diazmanuel/Display-PoV/README.md

# TD2-Project
Castro Germán.
Diaz Manuel.
Vieiro Alexis.
