diazmanuel/Display-PoV/Informes/Doxygen/latex/HallSensor_8h.tex

\hypertarget{HallSensor_8h}{}\section{inc/\+Hall\+Sensor.h File Reference}
\label{HallSensor_8h}\index{inc/\+Hall\+Sensor.\+h@{inc/\+Hall\+Sensor.\+h}}

Asociaciones a \mbox{\hyperlink{HallSensor_8c}{Hall\+Sensor.\+c}}.  

\subsection*{Data Structures}
\begin{DoxyCompactItemize}
\item 
struct \mbox{\hyperlink{structHallSensor}{Hall\+Sensor}}
\begin{DoxyCompactList}\small\item\em \mbox{\hyperlink{structHallSensor}{Hall\+Sensor}} data struct. \end{DoxyCompactList}\end{DoxyCompactItemize}
\subsection*{Macros}
\begin{DoxyCompactItemize}
\item 
\#define \mbox{\hyperlink{HallSensor_8h_a820b6b8369fe8a5102e352fd4bf670c9}{H\+A\+L\+L\+\_\+\+P\+IN}}~2,11
\item 
\#define \mbox{\hyperlink{HallSensor_8h_a815fd72f780650a3f0c92feb34b96a6e}{I\+S\+E\+\_\+\+E\+I\+N\+T1}}~19
\end{DoxyCompactItemize}
\subsection*{Typedefs}
\begin{DoxyCompactItemize}
\item 
typedef struct \mbox{\hyperlink{structHallSensor}{Hall\+Sensor}} \mbox{\hyperlink{HallSensor_8h_a1d1ee3822fdc22322726af6aaa56c168}{Hall\+Sensor\+\_\+t}}
\end{DoxyCompactItemize}
\subsection*{Functions}
\begin{DoxyCompactItemize}
\item 
void \mbox{\hyperlink{HallSensor_8h_afa1a93d781ae7c1db6d4a0d502c606f9}{Init\+Hall\+Sensor}} (void)
\begin{DoxyCompactList}\small\item\em Inicializa el hardware asociado al sensor hall. \end{DoxyCompactList}\item 
void \mbox{\hyperlink{HallSensor_8h_a336b0614150fc54c84bed71cd56a2ab3}{Crear\+Hall\+Sensor}} (\mbox{\hyperlink{HallSensor_8h_a1d1ee3822fdc22322726af6aaa56c168}{Hall\+Sensor\+\_\+t}} $\ast$$\ast$Hall\+Sensor\+H\+E\+AD)
\begin{DoxyCompactList}\small\item\em Crea y aloja en R\+AM estatica la memoria necesaria. \end{DoxyCompactList}\item 
void \mbox{\hyperlink{HallSensor_8h_a38bbe17aa64273d2f6037dbece46a151}{Eliminar\+Hall\+Sensor}} (\mbox{\hyperlink{HallSensor_8h_a1d1ee3822fdc22322726af6aaa56c168}{Hall\+Sensor\+\_\+t}} $\ast$$\ast$Hall\+Sensor\+H\+E\+AD)
\begin{DoxyCompactList}\small\item\em Elimina la memoria previamente alojada. \end{DoxyCompactList}\item 
void \mbox{\hyperlink{HallSensor_8h_a0ef4ba006c957012969c84b5b3db29e7}{E\+I\+N\+T0\+\_\+\+I\+R\+Q\+Handler}} (void)
\item 
void \mbox{\hyperlink{HallSensor_8h_a94ed24c6187969099266b37b4e22d749}{Hall\+Sensor\+Interrupt}} (\mbox{\hyperlink{HallSensor_8h_a1d1ee3822fdc22322726af6aaa56c168}{Hall\+Sensor\+\_\+t}} $\ast$This\+\_\+\+Hall\+Sensor)
\begin{DoxyCompactList}\small\item\em Sensa y da aviso de la velocidad del motor. \end{DoxyCompactList}\end{DoxyCompactItemize}
\subsection*{Variables}
\begin{DoxyCompactItemize}
\item 
\mbox{\hyperlink{HallSensor_8h_a1d1ee3822fdc22322726af6aaa56c168}{Hall\+Sensor\+\_\+t}} $\ast$ \mbox{\hyperlink{HallSensor_8h_a76ef976dec1b7dd1e23be44758510da5}{Hall\+Sensor}}
\begin{DoxyCompactList}\small\item\em Global Pointer to a Hall\+Sensor\+\_\+t. \end{DoxyCompactList}\item 
int \mbox{\hyperlink{HallSensor_8h_a4fd47c892115b2962abe067da643c98a}{Phase\+Refresh}}
\end{DoxyCompactItemize}

\subsection{Detailed Description}
Asociaciones a \mbox{\hyperlink{HallSensor_8c}{Hall\+Sensor.\+c}}. 

El codigo fuente, asi como el resto del proyecto, se encuentra disponible en su totalidad, libre y gratuito en\+:

\href{https://github.com/CastroGerman/TD2-Project/}{\tt https\+://github.\+com/\+Castro\+German/\+T\+D2-\/\+Project/}

Cualquier consulta, correccion y/o aporte al codigo y al proyecto es bienvenida por mail a\+: \href{mailto:gcastro@est.frba.utn.edu.ar}{\tt gcastro@est.\+frba.\+utn.\+edu.\+ar}

Atentamente\+: Castro Germán.

\begin{DoxyAuthor}{Author}
Castro Germán 
\end{DoxyAuthor}
\begin{DoxyDate}{Date}
07-\/\+Dic-\/2018 
\end{DoxyDate}

\subsection{Macro Definition Documentation}
\mbox{\Hypertarget{HallSensor_8h_a820b6b8369fe8a5102e352fd4bf670c9}\label{HallSensor_8h_a820b6b8369fe8a5102e352fd4bf670c9}} 
\index{Hall\+Sensor.\+h@{Hall\+Sensor.\+h}!H\+A\+L\+L\+\_\+\+P\+IN@{H\+A\+L\+L\+\_\+\+P\+IN}}
\index{H\+A\+L\+L\+\_\+\+P\+IN@{H\+A\+L\+L\+\_\+\+P\+IN}!Hall\+Sensor.\+h@{Hall\+Sensor.\+h}}
\subsubsection{\texorpdfstring{H\+A\+L\+L\+\_\+\+P\+IN}{HALL\_PIN}}
{\footnotesize\ttfamily \#define H\+A\+L\+L\+\_\+\+P\+IN~2,11}

$<$Puerto,Pin$>$ de entrada del microcontrolador al que irá conectado la señal analogica del hall sensor. Fue dispuesta para la interrupcion externa 1 (E\+I\+N\+T1). 

Definition at line 25 of file Hall\+Sensor.\+h.

Referenced by Init\+Hall\+Sensor().

\mbox{\Hypertarget{HallSensor_8h_a815fd72f780650a3f0c92feb34b96a6e}\label{HallSensor_8h_a815fd72f780650a3f0c92feb34b96a6e}} 
\index{Hall\+Sensor.\+h@{Hall\+Sensor.\+h}!I\+S\+E\+\_\+\+E\+I\+N\+T1@{I\+S\+E\+\_\+\+E\+I\+N\+T1}}
\index{I\+S\+E\+\_\+\+E\+I\+N\+T1@{I\+S\+E\+\_\+\+E\+I\+N\+T1}!Hall\+Sensor.\+h@{Hall\+Sensor.\+h}}
\subsubsection{\texorpdfstring{I\+S\+E\+\_\+\+E\+I\+N\+T1}{ISE\_EINT1}}
{\footnotesize\ttfamily \#define I\+S\+E\+\_\+\+E\+I\+N\+T1~19}

Bit asociado a la E\+I\+N\+T1 en el Interrupt Set-\/\+Enable Register 0 del microcontrolador 

Definition at line 30 of file Hall\+Sensor.\+h.

Referenced by Init\+Hall\+Sensor().

\subsection{Typedef Documentation}
\mbox{\Hypertarget{HallSensor_8h_a1d1ee3822fdc22322726af6aaa56c168}\label{HallSensor_8h_a1d1ee3822fdc22322726af6aaa56c168}} 
\index{Hall\+Sensor.\+h@{Hall\+Sensor.\+h}!Hall\+Sensor\+\_\+t@{Hall\+Sensor\+\_\+t}}
\index{Hall\+Sensor\+\_\+t@{Hall\+Sensor\+\_\+t}!Hall\+Sensor.\+h@{Hall\+Sensor.\+h}}
\subsubsection{\texorpdfstring{Hall\+Sensor\+\_\+t}{HallSensor\_t}}
{\footnotesize\ttfamily typedef struct \mbox{\hyperlink{structHallSensor}{Hall\+Sensor}} \mbox{\hyperlink{HallSensor_8h_a1d1ee3822fdc22322726af6aaa56c168}{Hall\+Sensor\+\_\+t}}}

\subsection{Function Documentation}
\mbox{\Hypertarget{HallSensor_8h_a336b0614150fc54c84bed71cd56a2ab3}\label{HallSensor_8h_a336b0614150fc54c84bed71cd56a2ab3}} 
\index{Hall\+Sensor.\+h@{Hall\+Sensor.\+h}!Crear\+Hall\+Sensor@{Crear\+Hall\+Sensor}}
\index{Crear\+Hall\+Sensor@{Crear\+Hall\+Sensor}!Hall\+Sensor.\+h@{Hall\+Sensor.\+h}}
\subsubsection{\texorpdfstring{Crear\+Hall\+Sensor()}{CrearHallSensor()}}
{\footnotesize\ttfamily void Crear\+Hall\+Sensor (\begin{DoxyParamCaption}\item[{\mbox{\hyperlink{HallSensor_8h_a1d1ee3822fdc22322726af6aaa56c168}{Hall\+Sensor\+\_\+t}} $\ast$$\ast$}]{Hall\+Sensor\+H\+E\+AD }\end{DoxyParamCaption})}

Crea y aloja en R\+AM estatica la memoria necesaria. 

\begin{DoxyParams}{Parameters}
{\em Hall\+Sensor\+H\+E\+AD} & Direccion del puntero. \\
\hline
\end{DoxyParams}
\begin{DoxyReturn}{Returns}
void 
\end{DoxyReturn}

Definition at line 55 of file Hall\+Sensor.\+c.

References pv\+Port\+Malloc().

Referenced by t\+Init().

\mbox{\Hypertarget{HallSensor_8h_a0ef4ba006c957012969c84b5b3db29e7}\label{HallSensor_8h_a0ef4ba006c957012969c84b5b3db29e7}} 
\index{Hall\+Sensor.\+h@{Hall\+Sensor.\+h}!E\+I\+N\+T0\+\_\+\+I\+R\+Q\+Handler@{E\+I\+N\+T0\+\_\+\+I\+R\+Q\+Handler}}
\index{E\+I\+N\+T0\+\_\+\+I\+R\+Q\+Handler@{E\+I\+N\+T0\+\_\+\+I\+R\+Q\+Handler}!Hall\+Sensor.\+h@{Hall\+Sensor.\+h}}
\subsubsection{\texorpdfstring{E\+I\+N\+T0\+\_\+\+I\+R\+Q\+Handler()}{EINT0\_IRQHandler()}}
{\footnotesize\ttfamily void E\+I\+N\+T0\+\_\+\+I\+R\+Q\+Handler (\begin{DoxyParamCaption}\item[{void}]{ }\end{DoxyParamCaption})}

\mbox{\Hypertarget{HallSensor_8h_a38bbe17aa64273d2f6037dbece46a151}\label{HallSensor_8h_a38bbe17aa64273d2f6037dbece46a151}} 
\index{Hall\+Sensor.\+h@{Hall\+Sensor.\+h}!Eliminar\+Hall\+Sensor@{Eliminar\+Hall\+Sensor}}
\index{Eliminar\+Hall\+Sensor@{Eliminar\+Hall\+Sensor}!Hall\+Sensor.\+h@{Hall\+Sensor.\+h}}
\subsubsection{\texorpdfstring{Eliminar\+Hall\+Sensor()}{EliminarHallSensor()}}
{\footnotesize\ttfamily void Eliminar\+Hall\+Sensor (\begin{DoxyParamCaption}\item[{\mbox{\hyperlink{HallSensor_8h_a1d1ee3822fdc22322726af6aaa56c168}{Hall\+Sensor\+\_\+t}} $\ast$$\ast$}]{Hall\+Sensor\+H\+E\+AD }\end{DoxyParamCaption})}

Elimina la memoria previamente alojada. 

\begin{DoxyParams}{Parameters}
{\em Hall\+Sensor\+H\+E\+AD} & Direccion del puntero. \\
\hline
\end{DoxyParams}
\begin{DoxyReturn}{Returns}
void 
\end{DoxyReturn}

Definition at line 67 of file Hall\+Sensor.\+c.

References v\+Port\+Free().

\mbox{\Hypertarget{HallSensor_8h_a94ed24c6187969099266b37b4e22d749}\label{HallSensor_8h_a94ed24c6187969099266b37b4e22d749}} 
\index{Hall\+Sensor.\+h@{Hall\+Sensor.\+h}!Hall\+Sensor\+Interrupt@{Hall\+Sensor\+Interrupt}}
\index{Hall\+Sensor\+Interrupt@{Hall\+Sensor\+Interrupt}!Hall\+Sensor.\+h@{Hall\+Sensor.\+h}}
\subsubsection{\texorpdfstring{Hall\+Sensor\+Interrupt()}{HallSensorInterrupt()}}
{\footnotesize\ttfamily void Hall\+Sensor\+Interrupt (\begin{DoxyParamCaption}\item[{\mbox{\hyperlink{HallSensor_8h_a1d1ee3822fdc22322726af6aaa56c168}{Hall\+Sensor\+\_\+t}} $\ast$}]{This\+\_\+\+Hall\+Sensor }\end{DoxyParamCaption})}

Sensa y da aviso de la velocidad del motor. 

Sensa multiples veces el periodo que tarda el motor en dar una vuelta, lo procesa mediante un simple filtro F\+IR y cuando alcance un valor estable dentro de un acotrado margen de error (que lo cubrira de posibles vibraciones, ventiscas y/o cualquier factor que pueda alterar su periodo de giro) indicara al sistema operativo que ese es el valor verdadero de periodo para setear un timer (timer1). A partir de este momento en adelante, dicho timer será el dictador de la frecuencia que deberan tener los leds para refrescar su imagen. 
\begin{DoxyParams}{Parameters}
{\em This\+\_\+\+Hall\+Sensor} & Direccion de memoria de informacion util. \\
\hline
\end{DoxyParams}
\begin{DoxyReturn}{Returns}
void 
\end{DoxyReturn}

Definition at line 103 of file Hall\+Sensor.\+c.

References ON, R\+E\+F\+R\+E\+S\+H\+T\+I\+M\+E\+R\+\_\+\+A\+L\+R\+E\+A\+D\+Y\+\_\+\+S\+E\+T\+UP, s\+Refresh\+Timer\+Setup, Status\+\_\+\+Flags, Hall\+Sensor\+::\+Tiempo\+Vuelta, and Hall\+Sensor\+::\+Working\+Frequency.

Referenced by t\+Hall\+Sensor().

\mbox{\Hypertarget{HallSensor_8h_afa1a93d781ae7c1db6d4a0d502c606f9}\label{HallSensor_8h_afa1a93d781ae7c1db6d4a0d502c606f9}} 
\index{Hall\+Sensor.\+h@{Hall\+Sensor.\+h}!Init\+Hall\+Sensor@{Init\+Hall\+Sensor}}
\index{Init\+Hall\+Sensor@{Init\+Hall\+Sensor}!Hall\+Sensor.\+h@{Hall\+Sensor.\+h}}
\subsubsection{\texorpdfstring{Init\+Hall\+Sensor()}{InitHallSensor()}}
{\footnotesize\ttfamily void Init\+Hall\+Sensor (\begin{DoxyParamCaption}\item[{void}]{ }\end{DoxyParamCaption})}

Inicializa el hardware asociado al sensor hall. 

\begin{DoxyReturn}{Returns}
void 
\end{DoxyReturn}

Definition at line 42 of file Hall\+Sensor.\+c.

References E\+X\+T\+M\+O\+D\+E1, E\+X\+T\+P\+O\+L\+A\+R1, H\+A\+L\+L\+\_\+\+P\+IN, I\+S\+E\+\_\+\+E\+I\+N\+T1, I\+S\+E\+R0, M\+Y\+E\+X\+T\+M\+O\+DE, M\+Y\+E\+X\+T\+P\+O\+L\+AR, and Set\+P\+I\+N\+S\+E\+L().

Referenced by Inicializar().

\subsection{Variable Documentation}
\mbox{\Hypertarget{HallSensor_8h_a76ef976dec1b7dd1e23be44758510da5}\label{HallSensor_8h_a76ef976dec1b7dd1e23be44758510da5}} 
\index{Hall\+Sensor.\+h@{Hall\+Sensor.\+h}!Hall\+Sensor@{Hall\+Sensor}}
\index{Hall\+Sensor@{Hall\+Sensor}!Hall\+Sensor.\+h@{Hall\+Sensor.\+h}}
\subsubsection{\texorpdfstring{Hall\+Sensor}{HallSensor}}
{\footnotesize\ttfamily \mbox{\hyperlink{HallSensor_8h_a1d1ee3822fdc22322726af6aaa56c168}{Hall\+Sensor\+\_\+t}}$\ast$ \mbox{\hyperlink{structHallSensor}{Hall\+Sensor}}}

Global Pointer to a Hall\+Sensor\+\_\+t. 

El puntero principal que maneja la info del sensor hall. 

Definition at line 36 of file Hall\+Sensor.\+c.

\mbox{\Hypertarget{HallSensor_8h_a4fd47c892115b2962abe067da643c98a}\label{HallSensor_8h_a4fd47c892115b2962abe067da643c98a}} 
\index{Hall\+Sensor.\+h@{Hall\+Sensor.\+h}!Phase\+Refresh@{Phase\+Refresh}}
\index{Phase\+Refresh@{Phase\+Refresh}!Hall\+Sensor.\+h@{Hall\+Sensor.\+h}}
\subsubsection{\texorpdfstring{Phase\+Refresh}{PhaseRefresh}}
{\footnotesize\ttfamily int Phase\+Refresh}

Indicador de que hay que corregir la fase 

Definition at line 28 of file Hall\+Sensor.\+c.

Referenced by Carga\+Data(), and E\+I\+N\+T1\+\_\+\+I\+R\+Q\+Handler().
