diazmanuel/Display-PoV/Informes/Doxygen/latex/InterruptHandler_8h.tex

\hypertarget{InterruptHandler_8h}{}\section{inc/\+Interrupt\+Handler.h File Reference}
\label{InterruptHandler_8h}\index{inc/\+Interrupt\+Handler.\+h@{inc/\+Interrupt\+Handler.\+h}}

Asociacion a \mbox{\hyperlink{Serial_8c}{Serial.\+c}} en \mbox{\hyperlink{myTasks_8c}{my\+Tasks.\+c}}.  

\subsection*{Macros}
\begin{DoxyCompactItemize}
\item 
\#define \mbox{\hyperlink{InterruptHandler_8h_affc1b6de5da434e95c3c7d4dc7b9ea54}{R\+E\+F\+R\+E\+S\+H\+\_\+\+S\+T\+R\+E\+AM}}~1
\item 
\#define \mbox{\hyperlink{InterruptHandler_8h_a10f6d17f39e46ab1bb19fc19519c6a96}{R\+E\+F\+R\+E\+S\+H\+\_\+\+S\+T\+R\+E\+A\+M\+\_\+S}}~\mbox{\hyperlink{InterruptHandler_8h_affc1b6de5da434e95c3c7d4dc7b9ea54}{R\+E\+F\+R\+E\+S\+H\+\_\+\+S\+T\+R\+E\+AM}}$\ast$10
\end{DoxyCompactItemize}

\subsection{Detailed Description}
Asociacion a \mbox{\hyperlink{Serial_8c}{Serial.\+c}} en \mbox{\hyperlink{myTasks_8c}{my\+Tasks.\+c}}. 

El codigo fuente, asi como el resto del proyecto, se encuentra disponible en su totalidad, libre y gratuito en\+:

\href{https://github.com/CastroGerman/TD2-Project/}{\tt https\+://github.\+com/\+Castro\+German/\+T\+D2-\/\+Project/}

Cualquier consulta, correccion y/o aporte al codigo y al proyecto es bienvenida por mail a\+: \href{mailto:gcastro@est.frba.utn.edu.ar}{\tt gcastro@est.\+frba.\+utn.\+edu.\+ar}

Atentamente\+: Castro Germán.

\begin{DoxyAuthor}{Author}
Castro Germán 
\end{DoxyAuthor}
\begin{DoxyDate}{Date}
07-\/\+Dic-\/2018 
\end{DoxyDate}

\subsection{Macro Definition Documentation}
\mbox{\Hypertarget{InterruptHandler_8h_affc1b6de5da434e95c3c7d4dc7b9ea54}\label{InterruptHandler_8h_affc1b6de5da434e95c3c7d4dc7b9ea54}} 
\index{Interrupt\+Handler.\+h@{Interrupt\+Handler.\+h}!R\+E\+F\+R\+E\+S\+H\+\_\+\+S\+T\+R\+E\+AM@{R\+E\+F\+R\+E\+S\+H\+\_\+\+S\+T\+R\+E\+AM}}
\index{R\+E\+F\+R\+E\+S\+H\+\_\+\+S\+T\+R\+E\+AM@{R\+E\+F\+R\+E\+S\+H\+\_\+\+S\+T\+R\+E\+AM}!Interrupt\+Handler.\+h@{Interrupt\+Handler.\+h}}
\subsubsection{\texorpdfstring{R\+E\+F\+R\+E\+S\+H\+\_\+\+S\+T\+R\+E\+AM}{REFRESH\_STREAM}}
{\footnotesize\ttfamily \#define R\+E\+F\+R\+E\+S\+H\+\_\+\+S\+T\+R\+E\+AM~1}

Definition at line 21 of file Interrupt\+Handler.\+h.

\mbox{\Hypertarget{InterruptHandler_8h_a10f6d17f39e46ab1bb19fc19519c6a96}\label{InterruptHandler_8h_a10f6d17f39e46ab1bb19fc19519c6a96}} 
\index{Interrupt\+Handler.\+h@{Interrupt\+Handler.\+h}!R\+E\+F\+R\+E\+S\+H\+\_\+\+S\+T\+R\+E\+A\+M\+\_\+S@{R\+E\+F\+R\+E\+S\+H\+\_\+\+S\+T\+R\+E\+A\+M\+\_\+S}}
\index{R\+E\+F\+R\+E\+S\+H\+\_\+\+S\+T\+R\+E\+A\+M\+\_\+S@{R\+E\+F\+R\+E\+S\+H\+\_\+\+S\+T\+R\+E\+A\+M\+\_\+S}!Interrupt\+Handler.\+h@{Interrupt\+Handler.\+h}}
\subsubsection{\texorpdfstring{R\+E\+F\+R\+E\+S\+H\+\_\+\+S\+T\+R\+E\+A\+M\+\_\+S}{REFRESH\_STREAM\_S}}
{\footnotesize\ttfamily \#define R\+E\+F\+R\+E\+S\+H\+\_\+\+S\+T\+R\+E\+A\+M\+\_\+S~\mbox{\hyperlink{InterruptHandler_8h_affc1b6de5da434e95c3c7d4dc7b9ea54}{R\+E\+F\+R\+E\+S\+H\+\_\+\+S\+T\+R\+E\+AM}}$\ast$10}

Definition at line 22 of file Interrupt\+Handler.\+h.

Referenced by t\+Periodic().
