diazmanuel/Display-PoV/Informes/Doxygen/latex/list_8c.tex

\hypertarget{list_8c}{}\section{freertos/src/list.c File Reference}
\label{list_8c}\index{freertos/src/list.\+c@{freertos/src/list.\+c}}
{\ttfamily \#include $<$stdlib.\+h$>$}\newline
{\ttfamily \#include \char`\"{}Free\+R\+T\+O\+S.\+h\char`\"{}}\newline
{\ttfamily \#include \char`\"{}list.\+h\char`\"{}}\newline
\subsection*{Functions}
\begin{DoxyCompactItemize}
\item 
void \mbox{\hyperlink{list_8c_ab92eb169a508a99459d23f93245ebad3}{v\+List\+Initialise}} (x\+List $\ast$const px\+List)
\item 
void \mbox{\hyperlink{list_8c_aa6b21bf070c16bbb49d79b4496ef8abc}{v\+List\+Initialise\+Item}} (x\+List\+Item $\ast$const px\+Item)
\item 
void \mbox{\hyperlink{list_8c_a64467894b97580a645908325545a9822}{v\+List\+Insert\+End}} (x\+List $\ast$const px\+List, x\+List\+Item $\ast$const px\+New\+List\+Item)
\item 
void \mbox{\hyperlink{list_8c_a74ceba64564af9cca53bb1c29cf73f46}{v\+List\+Insert}} (x\+List $\ast$const px\+List, x\+List\+Item $\ast$const px\+New\+List\+Item)
\item 
unsigned port\+B\+A\+S\+E\+\_\+\+T\+Y\+PE \mbox{\hyperlink{list_8c_ab3412c6f76400fb1df644fac2c8169cf}{ux\+List\+Remove}} (x\+List\+Item $\ast$const px\+Item\+To\+Remove)
\end{DoxyCompactItemize}

\subsection{Function Documentation}
\mbox{\Hypertarget{list_8c_ab3412c6f76400fb1df644fac2c8169cf}\label{list_8c_ab3412c6f76400fb1df644fac2c8169cf}} 
\index{list.\+c@{list.\+c}!ux\+List\+Remove@{ux\+List\+Remove}}
\index{ux\+List\+Remove@{ux\+List\+Remove}!list.\+c@{list.\+c}}
\subsubsection{\texorpdfstring{ux\+List\+Remove()}{uxListRemove()}}
{\footnotesize\ttfamily unsigned port\+B\+A\+S\+E\+\_\+\+T\+Y\+PE ux\+List\+Remove (\begin{DoxyParamCaption}\item[{x\+List\+Item $\ast$const}]{px\+Item\+To\+Remove }\end{DoxyParamCaption})}

Definition at line 181 of file list.\+c.

Referenced by v\+Task\+Place\+On\+Event\+List(), and x\+Task\+Remove\+From\+Event\+List().

\mbox{\Hypertarget{list_8c_ab92eb169a508a99459d23f93245ebad3}\label{list_8c_ab92eb169a508a99459d23f93245ebad3}} 
\index{list.\+c@{list.\+c}!v\+List\+Initialise@{v\+List\+Initialise}}
\index{v\+List\+Initialise@{v\+List\+Initialise}!list.\+c@{list.\+c}}
\subsubsection{\texorpdfstring{v\+List\+Initialise()}{vListInitialise()}}
{\footnotesize\ttfamily void v\+List\+Initialise (\begin{DoxyParamCaption}\item[{x\+List $\ast$const}]{px\+List }\end{DoxyParamCaption})}

Definition at line 75 of file list.\+c.

Referenced by x\+Queue\+Generic\+Reset().

\mbox{\Hypertarget{list_8c_aa6b21bf070c16bbb49d79b4496ef8abc}\label{list_8c_aa6b21bf070c16bbb49d79b4496ef8abc}} 
\index{list.\+c@{list.\+c}!v\+List\+Initialise\+Item@{v\+List\+Initialise\+Item}}
\index{v\+List\+Initialise\+Item@{v\+List\+Initialise\+Item}!list.\+c@{list.\+c}}
\subsubsection{\texorpdfstring{v\+List\+Initialise\+Item()}{vListInitialiseItem()}}
{\footnotesize\ttfamily void v\+List\+Initialise\+Item (\begin{DoxyParamCaption}\item[{x\+List\+Item $\ast$const}]{px\+Item }\end{DoxyParamCaption})}

Definition at line 95 of file list.\+c.

\mbox{\Hypertarget{list_8c_a74ceba64564af9cca53bb1c29cf73f46}\label{list_8c_a74ceba64564af9cca53bb1c29cf73f46}} 
\index{list.\+c@{list.\+c}!v\+List\+Insert@{v\+List\+Insert}}
\index{v\+List\+Insert@{v\+List\+Insert}!list.\+c@{list.\+c}}
\subsubsection{\texorpdfstring{v\+List\+Insert()}{vListInsert()}}
{\footnotesize\ttfamily void v\+List\+Insert (\begin{DoxyParamCaption}\item[{x\+List $\ast$const}]{px\+List,  }\item[{x\+List\+Item $\ast$const}]{px\+New\+List\+Item }\end{DoxyParamCaption})}

Definition at line 123 of file list.\+c.

Referenced by v\+Task\+Place\+On\+Event\+List().

\mbox{\Hypertarget{list_8c_a64467894b97580a645908325545a9822}\label{list_8c_a64467894b97580a645908325545a9822}} 
\index{list.\+c@{list.\+c}!v\+List\+Insert\+End@{v\+List\+Insert\+End}}
\index{v\+List\+Insert\+End@{v\+List\+Insert\+End}!list.\+c@{list.\+c}}
\subsubsection{\texorpdfstring{v\+List\+Insert\+End()}{vListInsertEnd()}}
{\footnotesize\ttfamily void v\+List\+Insert\+End (\begin{DoxyParamCaption}\item[{x\+List $\ast$const}]{px\+List,  }\item[{x\+List\+Item $\ast$const}]{px\+New\+List\+Item }\end{DoxyParamCaption})}

Definition at line 102 of file list.\+c.
