diazmanuel/Display-PoV/Informes/Doxygen/latex/myTasks_8c.tex

\hypertarget{myTasks_8c}{}\section{Applications/my\+Tasks.c File Reference}
\label{myTasks_8c}\index{Applications/my\+Tasks.\+c@{Applications/my\+Tasks.\+c}}

Todas las tareas del S.\+O.  

{\ttfamily \#include \char`\"{}my\+Tasks.\+h\char`\"{}}\newline
{\ttfamily \#include \char`\"{}Shifter.\+h\char`\"{}}\newline
{\ttfamily \#include \char`\"{}Hall\+Sensor.\+h\char`\"{}}\newline
{\ttfamily \#include \char`\"{}Display.\+h\char`\"{}}\newline
{\ttfamily \#include \char`\"{}Initializations.\+h\char`\"{}}\newline
{\ttfamily \#include \char`\"{}Interrupt\+Handler.\+h\char`\"{}}\newline
{\ttfamily \#include \char`\"{}Status\+Handler.\+h\char`\"{}}\newline
{\ttfamily \#include \char`\"{}my\+Timers.\+h\char`\"{}}\newline
{\ttfamily \#include \char`\"{}G\+P\+I\+O\+L\+P\+C1769.\+h\char`\"{}}\newline
{\ttfamily \#include \char`\"{}S\+D.\+h\char`\"{}}\newline
\subsection*{Functions}
\begin{DoxyCompactItemize}
\item 
void \mbox{\hyperlink{myTasks_8c_a66abf544a07450035ec53b9dda23a5df}{disk\+\_\+timerproc}} ()
\item 
void \mbox{\hyperlink{myTasks_8c_a034c44a0db314c1dbc468d776ae2da0c}{Crear\+Semaforos}} (void)
\begin{DoxyCompactList}\small\item\em Crea Semaforos necesarios para las tareas del S.\+O. \end{DoxyCompactList}\item 
void \mbox{\hyperlink{myTasks_8c_ac7cfc279f39f3967f9afb0506dc21289}{Crear\+Tareas}} (void)
\begin{DoxyCompactList}\small\item\em Crea las tareas requeridas por el S.\+O. \end{DoxyCompactList}\item 
void \mbox{\hyperlink{myTasks_8c_a9ca051aa77e17583aa5a85d5de5c199a}{v\+Application\+Tick\+Hook}} (void)
\begin{DoxyCompactList}\small\item\em 10ms tickhook \end{DoxyCompactList}\item 
void \mbox{\hyperlink{myTasks_8c_a97fd430f36f8b065226e2bff9bad1de5}{v\+Application\+Idle\+Hook}} (void)
\begin{DoxyCompactList}\small\item\em Idle Hook from Free\+R\+T\+OS. \end{DoxyCompactList}\item 
void \mbox{\hyperlink{myTasks_8c_a1fa1a72c443ed5eda34fdce202ff3268}{t\+Periodic}} (void $\ast$pv)
\begin{DoxyCompactList}\small\item\em Marca cada cuanto pido informacion a la aplicacion de PC. \end{DoxyCompactList}\item 
void \mbox{\hyperlink{myTasks_8c_a46c4e03979bb91cfc22c570e29a91a19}{t\+Init}} (void $\ast$pv)
\begin{DoxyCompactList}\small\item\em Tarea de inicializacion de software. \end{DoxyCompactList}\item 
void \mbox{\hyperlink{myTasks_8c_ad58e2382c3b7f1795f3c80a978b03850}{t\+Hall\+Sensor}} (void $\ast$pv)
\begin{DoxyCompactList}\small\item\em Task asociada a la interrupcion del sensor hall. \end{DoxyCompactList}\item 
void \mbox{\hyperlink{myTasks_8c_ad5378d0e04665efc69a7eed4302919f0}{t\+Refresh\+Timer\+Setup}} (void $\ast$pv)
\begin{DoxyCompactList}\small\item\em Configura Timer 1. \end{DoxyCompactList}\item 
void \mbox{\hyperlink{myTasks_8c_a0e5211df00f85a93b59e1bf4e4564da6}{t\+Carga\+Data}} (void $\ast$pv)
\begin{DoxyCompactList}\small\item\em Asociada a la carga del Shifter\+\_\+t. \end{DoxyCompactList}\item 
void \mbox{\hyperlink{myTasks_8c_a391ae66cafa2c343002e3efe882b008b}{t\+Descomprimir}} (void $\ast$pv)
\begin{DoxyCompactList}\small\item\em Asociada al algoritmo de descompresion. \end{DoxyCompactList}\end{DoxyCompactItemize}
\subsection*{Variables}
\begin{DoxyCompactItemize}
\item 
x\+Semaphore\+Handle \mbox{\hyperlink{myTasks_8c_ab55a0bce19ea14181c8e7fc2919fce57}{stick}}
\item 
x\+Semaphore\+Handle \mbox{\hyperlink{myTasks_8c_ab6877a3433079d5dc760b3416a5dec5b}{s\+Hall\+Sensor}}
\item 
x\+Semaphore\+Handle \mbox{\hyperlink{myTasks_8c_a187c552f9e424df062a340d3fde3e271}{s\+Refresh\+Timer\+Setup}}
\item 
x\+Semaphore\+Handle \mbox{\hyperlink{myTasks_8c_ab518643122c7213106819d6708cde7b7}{s\+Carga\+Data}}
\item 
x\+Semaphore\+Handle \mbox{\hyperlink{myTasks_8c_a1c00489cdc5c047622bccd33c1b7f8ae}{s\+Descomprimir}}
\end{DoxyCompactItemize}

\subsection{Detailed Description}
Todas las tareas del S.\+O. 

El codigo fuente, asi como el resto del proyecto, se encuentra disponible en su totalidad, libre y gratuito en\+:

\href{https://github.com/CastroGerman/TD2-Project/}{\tt https\+://github.\+com/\+Castro\+German/\+T\+D2-\/\+Project/}

Cualquier consulta, correccion y/o aporte al codigo y al proyecto es bienvenida por mail a\+: \href{mailto:gcastro@est.frba.utn.edu.ar}{\tt gcastro@est.\+frba.\+utn.\+edu.\+ar}

Atentamente\+: Castro Germán.

\begin{DoxyAuthor}{Author}
Castro Germán 
\end{DoxyAuthor}
\begin{DoxyDate}{Date}
07-\/\+Dic-\/2018 
\end{DoxyDate}

\subsection{Function Documentation}
\mbox{\Hypertarget{myTasks_8c_a034c44a0db314c1dbc468d776ae2da0c}\label{myTasks_8c_a034c44a0db314c1dbc468d776ae2da0c}} 
\index{my\+Tasks.\+c@{my\+Tasks.\+c}!Crear\+Semaforos@{Crear\+Semaforos}}
\index{Crear\+Semaforos@{Crear\+Semaforos}!my\+Tasks.\+c@{my\+Tasks.\+c}}
\subsubsection{\texorpdfstring{Crear\+Semaforos()}{CrearSemaforos()}}
{\footnotesize\ttfamily void Crear\+Semaforos (\begin{DoxyParamCaption}\item[{void}]{ }\end{DoxyParamCaption})}

Crea Semaforos necesarios para las tareas del S.\+O. 

Definition at line 42 of file my\+Tasks.\+c.

References s\+Carga\+Data, s\+Descomprimir, s\+Hall\+Sensor, s\+Refresh\+Timer\+Setup, and stick.

Referenced by main().

\mbox{\Hypertarget{myTasks_8c_ac7cfc279f39f3967f9afb0506dc21289}\label{myTasks_8c_ac7cfc279f39f3967f9afb0506dc21289}} 
\index{my\+Tasks.\+c@{my\+Tasks.\+c}!Crear\+Tareas@{Crear\+Tareas}}
\index{Crear\+Tareas@{Crear\+Tareas}!my\+Tasks.\+c@{my\+Tasks.\+c}}
\subsubsection{\texorpdfstring{Crear\+Tareas()}{CrearTareas()}}
{\footnotesize\ttfamily void Crear\+Tareas (\begin{DoxyParamCaption}\item[{void}]{ }\end{DoxyParamCaption})}

Crea las tareas requeridas por el S.\+O. 

Definition at line 61 of file my\+Tasks.\+c.

References config\+M\+I\+N\+I\+M\+A\+L\+\_\+\+S\+T\+A\+C\+K\+\_\+\+S\+I\+ZE, t\+Carga\+Data(), t\+Descomprimir(), t\+Hall\+Sensor(), t\+Init(), t\+Periodic(), and t\+Refresh\+Timer\+Setup().

Referenced by main().

\mbox{\Hypertarget{myTasks_8c_a66abf544a07450035ec53b9dda23a5df}\label{myTasks_8c_a66abf544a07450035ec53b9dda23a5df}} 
\index{my\+Tasks.\+c@{my\+Tasks.\+c}!disk\+\_\+timerproc@{disk\+\_\+timerproc}}
\index{disk\+\_\+timerproc@{disk\+\_\+timerproc}!my\+Tasks.\+c@{my\+Tasks.\+c}}
\subsubsection{\texorpdfstring{disk\+\_\+timerproc()}{disk\_timerproc()}}
{\footnotesize\ttfamily void disk\+\_\+timerproc (\begin{DoxyParamCaption}{ }\end{DoxyParamCaption})}

Definition at line 604 of file mmc.\+c.

Referenced by t\+Periodic().

\mbox{\Hypertarget{myTasks_8c_a0e5211df00f85a93b59e1bf4e4564da6}\label{myTasks_8c_a0e5211df00f85a93b59e1bf4e4564da6}} 
\index{my\+Tasks.\+c@{my\+Tasks.\+c}!t\+Carga\+Data@{t\+Carga\+Data}}
\index{t\+Carga\+Data@{t\+Carga\+Data}!my\+Tasks.\+c@{my\+Tasks.\+c}}
\subsubsection{\texorpdfstring{t\+Carga\+Data()}{tCargaData()}}
{\footnotesize\ttfamily void t\+Carga\+Data (\begin{DoxyParamCaption}\item[{void $\ast$}]{pv }\end{DoxyParamCaption})}

Asociada a la carga del Shifter\+\_\+t. 

Encargada de desglosar la siguiente linea de la imagen a ser impresa y cargarla como dato futuro en una estructura Shifter\+\_\+t 
\begin{DoxyParams}{Parameters}
{\em pv} & Pointer to void \\
\hline
\end{DoxyParams}

Definition at line 186 of file my\+Tasks.\+c.

References Carga\+Data(), and s\+Carga\+Data.

Referenced by Crear\+Tareas().

\mbox{\Hypertarget{myTasks_8c_a391ae66cafa2c343002e3efe882b008b}\label{myTasks_8c_a391ae66cafa2c343002e3efe882b008b}} 
\index{my\+Tasks.\+c@{my\+Tasks.\+c}!t\+Descomprimir@{t\+Descomprimir}}
\index{t\+Descomprimir@{t\+Descomprimir}!my\+Tasks.\+c@{my\+Tasks.\+c}}
\subsubsection{\texorpdfstring{t\+Descomprimir()}{tDescomprimir()}}
{\footnotesize\ttfamily void t\+Descomprimir (\begin{DoxyParamCaption}\item[{void $\ast$}]{pv }\end{DoxyParamCaption})}

Asociada al algoritmo de descompresion. 

\begin{DoxyParams}{Parameters}
{\em pv} & Pointer to void \\
\hline
\end{DoxyParams}

Definition at line 200 of file my\+Tasks.\+c.

References Descomprimir(), and s\+Descomprimir.

Referenced by Crear\+Tareas().

\mbox{\Hypertarget{myTasks_8c_ad58e2382c3b7f1795f3c80a978b03850}\label{myTasks_8c_ad58e2382c3b7f1795f3c80a978b03850}} 
\index{my\+Tasks.\+c@{my\+Tasks.\+c}!t\+Hall\+Sensor@{t\+Hall\+Sensor}}
\index{t\+Hall\+Sensor@{t\+Hall\+Sensor}!my\+Tasks.\+c@{my\+Tasks.\+c}}
\subsubsection{\texorpdfstring{t\+Hall\+Sensor()}{tHallSensor()}}
{\footnotesize\ttfamily void t\+Hall\+Sensor (\begin{DoxyParamCaption}\item[{void $\ast$}]{pv }\end{DoxyParamCaption})}

Task asociada a la interrupcion del sensor hall. 

Encargada de hacer el sensado de la velocidad del motor. 
\begin{DoxyParams}{Parameters}
{\em pv} & \\
\hline
\end{DoxyParams}

Definition at line 148 of file my\+Tasks.\+c.

References Hall\+Sensor\+Interrupt(), ON, R\+E\+F\+R\+E\+S\+H\+T\+I\+M\+E\+R\+\_\+\+A\+L\+R\+E\+A\+D\+Y\+\_\+\+S\+E\+T\+UP, s\+Hall\+Sensor, and Status\+\_\+\+Flags.

Referenced by Crear\+Tareas().

\mbox{\Hypertarget{myTasks_8c_a46c4e03979bb91cfc22c570e29a91a19}\label{myTasks_8c_a46c4e03979bb91cfc22c570e29a91a19}} 
\index{my\+Tasks.\+c@{my\+Tasks.\+c}!t\+Init@{t\+Init}}
\index{t\+Init@{t\+Init}!my\+Tasks.\+c@{my\+Tasks.\+c}}
\subsubsection{\texorpdfstring{t\+Init()}{tInit()}}
{\footnotesize\ttfamily void t\+Init (\begin{DoxyParamCaption}\item[{void $\ast$}]{pv }\end{DoxyParamCaption})}

Tarea de inicializacion de software. 

Se ejecuta una unica vez. 
\begin{DoxyParams}{Parameters}
{\em pv} & \\
\hline
\end{DoxyParams}

Definition at line 125 of file my\+Tasks.\+c.

References Crear\+Hall\+Sensor(), Crear\+Shifter(), Display\+Send(), Display\+Stop(), Inicializar(), and S\+D\+\_\+\+Read().

Referenced by Crear\+Tareas().

\mbox{\Hypertarget{myTasks_8c_a1fa1a72c443ed5eda34fdce202ff3268}\label{myTasks_8c_a1fa1a72c443ed5eda34fdce202ff3268}} 
\index{my\+Tasks.\+c@{my\+Tasks.\+c}!t\+Periodic@{t\+Periodic}}
\index{t\+Periodic@{t\+Periodic}!my\+Tasks.\+c@{my\+Tasks.\+c}}
\subsubsection{\texorpdfstring{t\+Periodic()}{tPeriodic()}}
{\footnotesize\ttfamily void t\+Periodic (\begin{DoxyParamCaption}\item[{void $\ast$}]{pv }\end{DoxyParamCaption})}

Marca cada cuanto pido informacion a la aplicacion de PC. 

\begin{DoxyParams}{Parameters}
{\em pv} & Pointer to void \\
\hline
\end{DoxyParams}

Definition at line 103 of file my\+Tasks.\+c.

References disk\+\_\+timerproc(), R\+E\+F\+R\+E\+S\+H\+\_\+\+S\+T\+R\+E\+A\+M\+\_\+S, stick, and Stream().

Referenced by Crear\+Tareas().

\mbox{\Hypertarget{myTasks_8c_ad5378d0e04665efc69a7eed4302919f0}\label{myTasks_8c_ad5378d0e04665efc69a7eed4302919f0}} 
\index{my\+Tasks.\+c@{my\+Tasks.\+c}!t\+Refresh\+Timer\+Setup@{t\+Refresh\+Timer\+Setup}}
\index{t\+Refresh\+Timer\+Setup@{t\+Refresh\+Timer\+Setup}!my\+Tasks.\+c@{my\+Tasks.\+c}}
\subsubsection{\texorpdfstring{t\+Refresh\+Timer\+Setup()}{tRefreshTimerSetup()}}
{\footnotesize\ttfamily void t\+Refresh\+Timer\+Setup (\begin{DoxyParamCaption}\item[{void $\ast$}]{pv }\end{DoxyParamCaption})}

Configura Timer 1. 

Se ejecuta una unica vez. 
\begin{DoxyParams}{Parameters}
{\em pv} & Pointer to void \\
\hline
\end{DoxyParams}

Definition at line 168 of file my\+Tasks.\+c.

References Refresh\+Timer\+Setup(), and s\+Refresh\+Timer\+Setup.

Referenced by Crear\+Tareas().

\mbox{\Hypertarget{myTasks_8c_a97fd430f36f8b065226e2bff9bad1de5}\label{myTasks_8c_a97fd430f36f8b065226e2bff9bad1de5}} 
\index{my\+Tasks.\+c@{my\+Tasks.\+c}!v\+Application\+Idle\+Hook@{v\+Application\+Idle\+Hook}}
\index{v\+Application\+Idle\+Hook@{v\+Application\+Idle\+Hook}!my\+Tasks.\+c@{my\+Tasks.\+c}}
\subsubsection{\texorpdfstring{v\+Application\+Idle\+Hook()}{vApplicationIdleHook()}}
{\footnotesize\ttfamily void v\+Application\+Idle\+Hook (\begin{DoxyParamCaption}\item[{void}]{ }\end{DoxyParamCaption})}

Idle Hook from Free\+R\+T\+OS. 

Free\+R\+T\+OS application idle hook.

La tarea de menor prioridad del sistema. Se encarga de recibir los datos de la aplicacion de PC por bluetooth. Una vez terminado de recibir el paquete comprimido, da semaforo a t\+Descomprimir. 

Definition at line 89 of file my\+Tasks.\+c.

\mbox{\Hypertarget{myTasks_8c_a9ca051aa77e17583aa5a85d5de5c199a}\label{myTasks_8c_a9ca051aa77e17583aa5a85d5de5c199a}} 
\index{my\+Tasks.\+c@{my\+Tasks.\+c}!v\+Application\+Tick\+Hook@{v\+Application\+Tick\+Hook}}
\index{v\+Application\+Tick\+Hook@{v\+Application\+Tick\+Hook}!my\+Tasks.\+c@{my\+Tasks.\+c}}
\subsubsection{\texorpdfstring{v\+Application\+Tick\+Hook()}{vApplicationTickHook()}}
{\footnotesize\ttfamily void v\+Application\+Tick\+Hook (\begin{DoxyParamCaption}\item[{void}]{ }\end{DoxyParamCaption})}

10ms tickhook 

Free\+R\+T\+OS application tick hook.

\begin{DoxyWarning}{Warning}
this is called by an interrupt handler! 
\end{DoxyWarning}

Definition at line 76 of file my\+Tasks.\+c.

\subsection{Variable Documentation}
\mbox{\Hypertarget{myTasks_8c_ab518643122c7213106819d6708cde7b7}\label{myTasks_8c_ab518643122c7213106819d6708cde7b7}} 
\index{my\+Tasks.\+c@{my\+Tasks.\+c}!s\+Carga\+Data@{s\+Carga\+Data}}
\index{s\+Carga\+Data@{s\+Carga\+Data}!my\+Tasks.\+c@{my\+Tasks.\+c}}
\subsubsection{\texorpdfstring{s\+Carga\+Data}{sCargaData}}
{\footnotesize\ttfamily x\+Semaphore\+Handle s\+Carga\+Data}

Semaforo binario para t\+Carga\+Data 

Definition at line 28 of file my\+Tasks.\+c.

Referenced by Crear\+Semaforos(), t\+Carga\+Data(), and T\+I\+M\+E\+R1\+\_\+\+I\+R\+Q\+Handler().

\mbox{\Hypertarget{myTasks_8c_a1c00489cdc5c047622bccd33c1b7f8ae}\label{myTasks_8c_a1c00489cdc5c047622bccd33c1b7f8ae}} 
\index{my\+Tasks.\+c@{my\+Tasks.\+c}!s\+Descomprimir@{s\+Descomprimir}}
\index{s\+Descomprimir@{s\+Descomprimir}!my\+Tasks.\+c@{my\+Tasks.\+c}}
\subsubsection{\texorpdfstring{s\+Descomprimir}{sDescomprimir}}
{\footnotesize\ttfamily x\+Semaphore\+Handle s\+Descomprimir}

Semaforo binario para t\+Descomprimir 

Definition at line 28 of file my\+Tasks.\+c.

Referenced by Crear\+Semaforos(), Serial\+Manager(), and t\+Descomprimir().

\mbox{\Hypertarget{myTasks_8c_ab6877a3433079d5dc760b3416a5dec5b}\label{myTasks_8c_ab6877a3433079d5dc760b3416a5dec5b}} 
\index{my\+Tasks.\+c@{my\+Tasks.\+c}!s\+Hall\+Sensor@{s\+Hall\+Sensor}}
\index{s\+Hall\+Sensor@{s\+Hall\+Sensor}!my\+Tasks.\+c@{my\+Tasks.\+c}}
\subsubsection{\texorpdfstring{s\+Hall\+Sensor}{sHallSensor}}
{\footnotesize\ttfamily x\+Semaphore\+Handle s\+Hall\+Sensor}

Semaforo binario para t\+Hall\+Sensor 

Definition at line 28 of file my\+Tasks.\+c.

Referenced by Crear\+Semaforos(), E\+I\+N\+T1\+\_\+\+I\+R\+Q\+Handler(), and t\+Hall\+Sensor().

\mbox{\Hypertarget{myTasks_8c_a187c552f9e424df062a340d3fde3e271}\label{myTasks_8c_a187c552f9e424df062a340d3fde3e271}} 
\index{my\+Tasks.\+c@{my\+Tasks.\+c}!s\+Refresh\+Timer\+Setup@{s\+Refresh\+Timer\+Setup}}
\index{s\+Refresh\+Timer\+Setup@{s\+Refresh\+Timer\+Setup}!my\+Tasks.\+c@{my\+Tasks.\+c}}
\subsubsection{\texorpdfstring{s\+Refresh\+Timer\+Setup}{sRefreshTimerSetup}}
{\footnotesize\ttfamily x\+Semaphore\+Handle s\+Refresh\+Timer\+Setup}

Semaforo binario para t\+Refresh\+Timer\+Setup 

Definition at line 28 of file my\+Tasks.\+c.

Referenced by Crear\+Semaforos(), Hall\+Sensor\+Interrupt(), and t\+Refresh\+Timer\+Setup().

\mbox{\Hypertarget{myTasks_8c_ab55a0bce19ea14181c8e7fc2919fce57}\label{myTasks_8c_ab55a0bce19ea14181c8e7fc2919fce57}} 
\index{my\+Tasks.\+c@{my\+Tasks.\+c}!stick@{stick}}
\index{stick@{stick}!my\+Tasks.\+c@{my\+Tasks.\+c}}
\subsubsection{\texorpdfstring{stick}{stick}}
{\footnotesize\ttfamily x\+Semaphore\+Handle stick}

Semaforo binario para t\+Periodic 

Definition at line 28 of file my\+Tasks.\+c.

Referenced by Crear\+Semaforos(), t\+Periodic(), and v\+Application\+Tick\+Hook().
