diazmanuel/Display-PoV/Informes/Doxygen/latex/PinoutConfigLPC1769_8c.tex

\hypertarget{PinoutConfigLPC1769_8c}{}\section{Drivers/\+Pinout\+Config\+L\+P\+C1769.c File Reference}
\label{PinoutConfigLPC1769_8c}\index{Drivers/\+Pinout\+Config\+L\+P\+C1769.\+c@{Drivers/\+Pinout\+Config\+L\+P\+C1769.\+c}}

Manejo de G\+P\+IO.  

{\ttfamily \#include \char`\"{}Pinout\+Config\+L\+P\+C1769.\+h\char`\"{}}\newline
\subsection*{Functions}
\begin{DoxyCompactItemize}
\item 
void \mbox{\hyperlink{PinoutConfigLPC1769_8c_ac1ac1e3ae9905cc5e7a407ffa5098656}{Set\+P\+I\+N\+S\+EL}} (\mbox{\hyperlink{RegsLPC1769_8h_aba7bc1797add20fe3efdf37ced1182c5}{uint8\+\_\+t}} puerto, \mbox{\hyperlink{RegsLPC1769_8h_aba7bc1797add20fe3efdf37ced1182c5}{uint8\+\_\+t}} pin, \mbox{\hyperlink{RegsLPC1769_8h_aba7bc1797add20fe3efdf37ced1182c5}{uint8\+\_\+t}} funcion)
\item 
void \mbox{\hyperlink{PinoutConfigLPC1769_8c_a8112ffeb940cdd56da108c6c14265675}{Set\+M\+O\+DE}} (\mbox{\hyperlink{RegsLPC1769_8h_aba7bc1797add20fe3efdf37ced1182c5}{uint8\+\_\+t}} port, \mbox{\hyperlink{RegsLPC1769_8h_aba7bc1797add20fe3efdf37ced1182c5}{uint8\+\_\+t}} pin, \mbox{\hyperlink{RegsLPC1769_8h_aba7bc1797add20fe3efdf37ced1182c5}{uint8\+\_\+t}} modo)
\end{DoxyCompactItemize}

\subsection{Detailed Description}
Manejo de G\+P\+IO. 

\subsection{Function Documentation}
\mbox{\Hypertarget{PinoutConfigLPC1769_8c_a8112ffeb940cdd56da108c6c14265675}\label{PinoutConfigLPC1769_8c_a8112ffeb940cdd56da108c6c14265675}} 
\index{Pinout\+Config\+L\+P\+C1769.\+c@{Pinout\+Config\+L\+P\+C1769.\+c}!Set\+M\+O\+DE@{Set\+M\+O\+DE}}
\index{Set\+M\+O\+DE@{Set\+M\+O\+DE}!Pinout\+Config\+L\+P\+C1769.\+c@{Pinout\+Config\+L\+P\+C1769.\+c}}
\subsubsection{\texorpdfstring{Set\+M\+O\+D\+E()}{SetMODE()}}
{\footnotesize\ttfamily void Set\+M\+O\+DE (\begin{DoxyParamCaption}\item[{\mbox{\hyperlink{RegsLPC1769_8h_aba7bc1797add20fe3efdf37ced1182c5}{uint8\+\_\+t}}}]{port,  }\item[{\mbox{\hyperlink{RegsLPC1769_8h_aba7bc1797add20fe3efdf37ced1182c5}{uint8\+\_\+t}}}]{pin,  }\item[{\mbox{\hyperlink{RegsLPC1769_8h_aba7bc1797add20fe3efdf37ced1182c5}{uint8\+\_\+t}}}]{modo }\end{DoxyParamCaption})}

Definition at line 33 of file Pinout\+Config\+L\+P\+C1769.\+c.

References M\+Y\+P\+I\+N\+M\+O\+DE.

Referenced by Init\+Shifter().

\mbox{\Hypertarget{PinoutConfigLPC1769_8c_ac1ac1e3ae9905cc5e7a407ffa5098656}\label{PinoutConfigLPC1769_8c_ac1ac1e3ae9905cc5e7a407ffa5098656}} 
\index{Pinout\+Config\+L\+P\+C1769.\+c@{Pinout\+Config\+L\+P\+C1769.\+c}!Set\+P\+I\+N\+S\+EL@{Set\+P\+I\+N\+S\+EL}}
\index{Set\+P\+I\+N\+S\+EL@{Set\+P\+I\+N\+S\+EL}!Pinout\+Config\+L\+P\+C1769.\+c@{Pinout\+Config\+L\+P\+C1769.\+c}}
\subsubsection{\texorpdfstring{Set\+P\+I\+N\+S\+E\+L()}{SetPINSEL()}}
{\footnotesize\ttfamily void Set\+P\+I\+N\+S\+EL (\begin{DoxyParamCaption}\item[{\mbox{\hyperlink{RegsLPC1769_8h_aba7bc1797add20fe3efdf37ced1182c5}{uint8\+\_\+t}}}]{puerto,  }\item[{\mbox{\hyperlink{RegsLPC1769_8h_aba7bc1797add20fe3efdf37ced1182c5}{uint8\+\_\+t}}}]{pin,  }\item[{\mbox{\hyperlink{RegsLPC1769_8h_aba7bc1797add20fe3efdf37ced1182c5}{uint8\+\_\+t}}}]{funcion }\end{DoxyParamCaption})}

Definition at line 16 of file Pinout\+Config\+L\+P\+C1769.\+c.

References M\+Y\+P\+I\+N\+S\+EL.

Referenced by Config\+Pin\+Bluetooth(), Init\+Hall\+Sensor(), Init\+Shifter(), Test\+Point\+Init\+B\+T(), Test\+Point\+Init\+General(), and U\+A\+R\+T\+\_\+\+Init().
