diazmanuel/Display-PoV/Informes/Doxygen/latex/StatusHandler_8c.tex

\hypertarget{StatusHandler_8c}{}\section{Drivers/\+Status\+Handler.c File Reference}
\label{StatusHandler_8c}\index{Drivers/\+Status\+Handler.\+c@{Drivers/\+Status\+Handler.\+c}}

Variable de Status.  

{\ttfamily \#include \char`\"{}Status\+Handler.\+h\char`\"{}}\newline
\subsection*{Functions}
\begin{DoxyCompactItemize}
\item 
void \mbox{\hyperlink{StatusHandler_8c_a29457ebfbe7da3c0ffa1355ab3792b98}{Init\+Status\+Flags}} (void)
\begin{DoxyCompactList}\small\item\em Inicializa el status de programa. \end{DoxyCompactList}\end{DoxyCompactItemize}
\subsection*{Variables}
\begin{DoxyCompactItemize}
\item 
unsigned int \mbox{\hyperlink{StatusHandler_8c_a33388b9ade8e912ef2c2dd3b1f0b76e5}{Status\+\_\+\+Flags}}
\end{DoxyCompactItemize}

\subsection{Detailed Description}
Variable de Status. 

El codigo fuente, asi como el resto del proyecto, se encuentra disponible en su totalidad, libre y gratuito en\+:

\href{https://github.com/CastroGerman/TD2-Project/}{\tt https\+://github.\+com/\+Castro\+German/\+T\+D2-\/\+Project/}

Cualquier consulta, correccion y/o aporte al codigo y al proyecto es bienvenida por mail a\+: \href{mailto:gcastro@est.frba.utn.edu.ar}{\tt gcastro@est.\+frba.\+utn.\+edu.\+ar}

Atentamente\+: Castro Germán.

\begin{DoxyAuthor}{Author}
Castro Germán 
\end{DoxyAuthor}
\begin{DoxyDate}{Date}
07-\/\+Dic-\/2018 
\end{DoxyDate}

\subsection{Function Documentation}
\mbox{\Hypertarget{StatusHandler_8c_a29457ebfbe7da3c0ffa1355ab3792b98}\label{StatusHandler_8c_a29457ebfbe7da3c0ffa1355ab3792b98}} 
\index{Status\+Handler.\+c@{Status\+Handler.\+c}!Init\+Status\+Flags@{Init\+Status\+Flags}}
\index{Init\+Status\+Flags@{Init\+Status\+Flags}!Status\+Handler.\+c@{Status\+Handler.\+c}}
\subsubsection{\texorpdfstring{Init\+Status\+Flags()}{InitStatusFlags()}}
{\footnotesize\ttfamily void Init\+Status\+Flags (\begin{DoxyParamCaption}\item[{void}]{ }\end{DoxyParamCaption})}

Inicializa el status de programa. 

Definition at line 25 of file Status\+Handler.\+c.

References Status\+\_\+\+Flags.

Referenced by Inicializar().

\subsection{Variable Documentation}
\mbox{\Hypertarget{StatusHandler_8c_a33388b9ade8e912ef2c2dd3b1f0b76e5}\label{StatusHandler_8c_a33388b9ade8e912ef2c2dd3b1f0b76e5}} 
\index{Status\+Handler.\+c@{Status\+Handler.\+c}!Status\+\_\+\+Flags@{Status\+\_\+\+Flags}}
\index{Status\+\_\+\+Flags@{Status\+\_\+\+Flags}!Status\+Handler.\+c@{Status\+Handler.\+c}}
\subsubsection{\texorpdfstring{Status\+\_\+\+Flags}{Status\_Flags}}
{\footnotesize\ttfamily unsigned int Status\+\_\+\+Flags}

Variable de status de programa 

Definition at line 19 of file Status\+Handler.\+c.

Referenced by Descomprimir(), Hall\+Sensor\+Interrupt(), Init\+Status\+Flags(), Refresh\+Timer\+Setup(), Serial\+Manager(), Stream(), and t\+Hall\+Sensor().
