diazmanuel/Display-PoV/Informes/Doxygen/latex/Bluetooth_8d.tex

\hypertarget{Bluetooth_8d}{}\section{Debug/\+Drivers/\+Bluetooth.d File Reference}
\label{Bluetooth_8d}\index{Debug/\+Drivers/\+Bluetooth.\+d@{Debug/\+Drivers/\+Bluetooth.\+d}}
