diazmanuel/Display-PoV/Informes/Doxygen/latex/ff_8d.tex

\hypertarget{ff_8d}{}\section{Debug/spi/src/ff.d File Reference}
\label{ff_8d}\index{Debug/spi/src/ff.\+d@{Debug/spi/src/ff.\+d}}
