diazmanuel/Display-PoV/Informes/Doxygen/latex/GPIOLPC1769_8d.tex

\hypertarget{GPIOLPC1769_8d}{}\section{Debug/\+Drivers/\+G\+P\+I\+O\+L\+P\+C1769.d File Reference}
\label{GPIOLPC1769_8d}\index{Debug/\+Drivers/\+G\+P\+I\+O\+L\+P\+C1769.\+d@{Debug/\+Drivers/\+G\+P\+I\+O\+L\+P\+C1769.\+d}}
