diazmanuel/Display-PoV/Informes/Doxygen/latex/HallSensor_8d.tex

\hypertarget{HallSensor_8d}{}\section{Debug/\+Drivers/\+Hall\+Sensor.d File Reference}
\label{HallSensor_8d}\index{Debug/\+Drivers/\+Hall\+Sensor.\+d@{Debug/\+Drivers/\+Hall\+Sensor.\+d}}
