diazmanuel/Display-PoV/Informes/Doxygen/latex/lz4_8d.tex

\hypertarget{lz4_8d}{}\section{Debug/\+Drivers/lz4.d File Reference}
\label{lz4_8d}\index{Debug/\+Drivers/lz4.\+d@{Debug/\+Drivers/lz4.\+d}}
