diazmanuel/Display-PoV/Informes/Doxygen/latex/mmc_8d.tex

\hypertarget{mmc_8d}{}\section{Debug/spi/src/mmc.d File Reference}
\label{mmc_8d}\index{Debug/spi/src/mmc.\+d@{Debug/spi/src/mmc.\+d}}
