diazmanuel/Display-PoV/Informes/Doxygen/latex/Oscilador_8d.tex

\hypertarget{Oscilador_8d}{}\section{Debug/\+Drivers/\+Oscilador.d File Reference}
\label{Oscilador_8d}\index{Debug/\+Drivers/\+Oscilador.\+d@{Debug/\+Drivers/\+Oscilador.\+d}}
