diazmanuel/Display-PoV/Informes/Doxygen/latex/PinoutConfigLPC1769_8d.tex

\hypertarget{PinoutConfigLPC1769_8d}{}\section{Debug/\+Drivers/\+Pinout\+Config\+L\+P\+C1769.d File Reference}
\label{PinoutConfigLPC1769_8d}\index{Debug/\+Drivers/\+Pinout\+Config\+L\+P\+C1769.\+d@{Debug/\+Drivers/\+Pinout\+Config\+L\+P\+C1769.\+d}}
