diazmanuel/Display-PoV/Informes/Doxygen/latex/rtc_8d.tex

\hypertarget{rtc_8d}{}\section{Debug/spi/src/rtc.d File Reference}
\label{rtc_8d}\index{Debug/spi/src/rtc.\+d@{Debug/spi/src/rtc.\+d}}
