diazmanuel/Display-PoV/Informes/Doxygen/latex/SD_8d.tex

\hypertarget{SD_8d}{}\section{Debug/\+Drivers/\+SD.d File Reference}
\label{SD_8d}\index{Debug/\+Drivers/\+S\+D.\+d@{Debug/\+Drivers/\+S\+D.\+d}}
