diazmanuel/Display-PoV/Informes/Doxygen/latex/Serial_8d.tex

\hypertarget{Serial_8d}{}\section{Debug/\+Drivers/\+Serial.d File Reference}
\label{Serial_8d}\index{Debug/\+Drivers/\+Serial.\+d@{Debug/\+Drivers/\+Serial.\+d}}
