diazmanuel/Display-PoV/Informes/Doxygen/latex/Shifter_8d.tex

\hypertarget{Shifter_8d}{}\section{Debug/\+Drivers/\+Shifter.d File Reference}
\label{Shifter_8d}\index{Debug/\+Drivers/\+Shifter.\+d@{Debug/\+Drivers/\+Shifter.\+d}}
