diazmanuel/Display-PoV/Informes/Doxygen/latex/StatusHandler_8d.tex

\hypertarget{StatusHandler_8d}{}\section{Debug/\+Drivers/\+Status\+Handler.d File Reference}
\label{StatusHandler_8d}\index{Debug/\+Drivers/\+Status\+Handler.\+d@{Debug/\+Drivers/\+Status\+Handler.\+d}}
