diazmanuel/Display-PoV/Informes/Doxygen/latex/Timers_8d.tex

\hypertarget{Timers_8d}{}\section{Debug/\+Applications/\+Timers.d File Reference}
\label{Timers_8d}\index{Debug/\+Applications/\+Timers.\+d@{Debug/\+Applications/\+Timers.\+d}}
