diazmanuel/Display-PoV/Informes/Doxygen/latex/UART_8d.tex

\hypertarget{UART_8d}{}\section{Debug/\+Drivers/\+U\+A\+RT.d File Reference}
\label{UART_8d}\index{Debug/\+Drivers/\+U\+A\+R\+T.\+d@{Debug/\+Drivers/\+U\+A\+R\+T.\+d}}
