diazmanuel/Display-PoV/Informes/Display POV.pdf

# Display POV: Persistence of vision

## INDICE

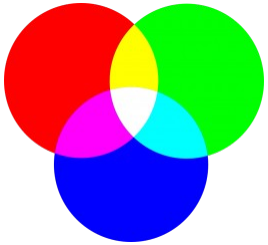
[picture p1: figure]

# 1. Descripción general

### 1.1. Introducción teórica

El display persistense of vision está basado en el conocido fenómeno de la persistencia de la visión descubierto por Peter Mark Roget el cual demostró que una imagen permanecía en la retina una decima de segundo después de haber desaparecido. Es debido a este efecto que en la vida cotidiana vemos la ilusión de movimiento debido a que el cerebro entrelaza las imágenes que se superponen en la retina.

### 1.2. Funcionamiento

El fin de este proyecto es mostrar una imagen creada en una aplicación de computadora y transmitirla al display PoV mediante una conexión bluetooth. Para esto el display aprovecha el efecto de persistencia de la visión y mediante el montaje del pcb sobre el eje de un motor, gira a una frecuencia mayor a la frecuencia de retención de imágenes del ojo humano. Dicho pcb será detallado más adelante.

### 1.3. Interface con usuario:

La aplicación “SPINO BRUSH” se encuentra disponible para las plataformas de Mac, Windows y Linux creada por Guillaume Chereau. Esta aplicación se encargará de crear y transmitir mediante una conexión de bluetooth (Requisito básico para utilizar esta aplicación) una imagen en coordenadas polares.

### 1.4. Operación:

Para lograr la conexión de la aplicación primero se deberá emparejar el dispositivo bluetooth con la computadora.
Luego se deberá establecer la conexión dentro de la aplicación. Una vez establecida la conexión el usuario contará con una serie de amplias herramientas para el diseño de su imagen así también contará con la posibilidad de cargar imágenes ya existentes.

# 2. Hardware

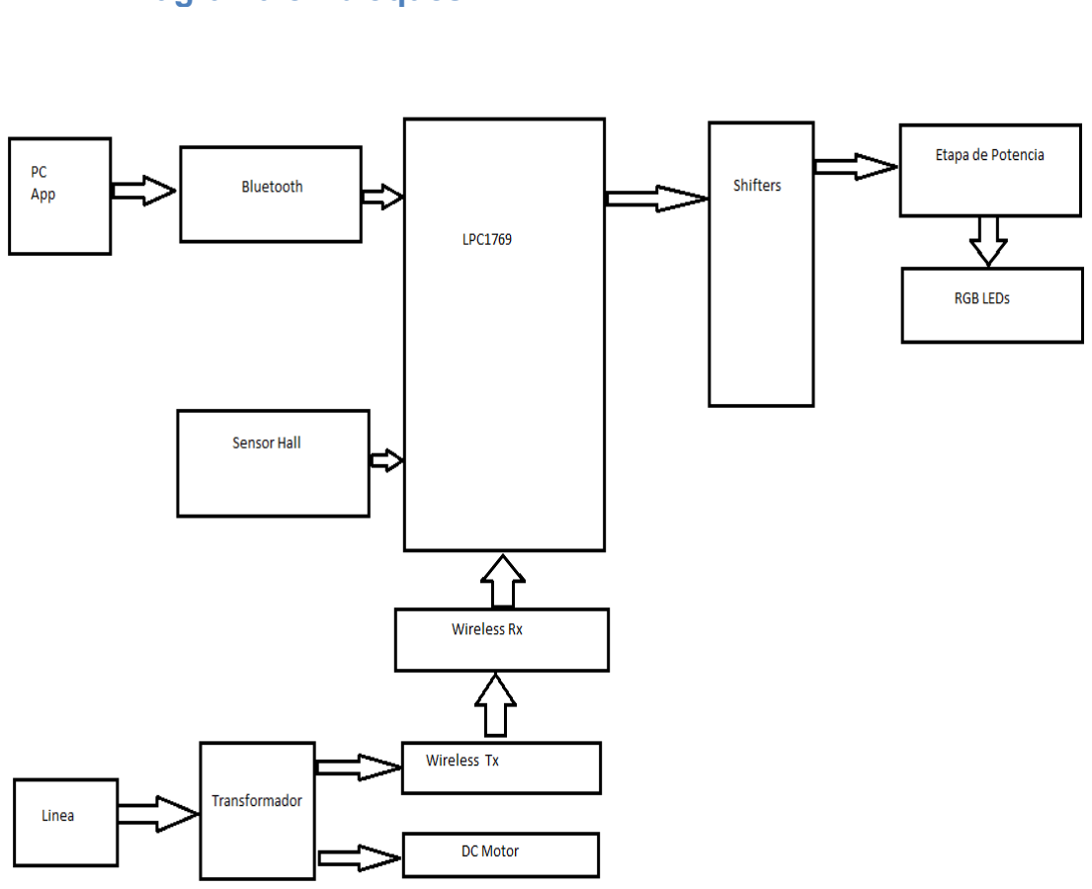
[picture p2: figure]

### 2.1. Diagrama en bloques

### 2.2. Descripción de hardware

### 2.2.1. Maqueta

(Descargar Maqueta3D) (https://github.com/CastroGerman/TD2-Project/blob/master/Hardware%20Design/Maqueta/Ensamblaje.PDF)
- Base:
El diseño consiste en un gran cubo, compuesto de pino y acrílico, en el cual irán montadas todas las piezas del proyecto. En su interior se aloja el motor y el cableado, en el acrílico frontal se montan los interruptores para el manejo por el usuario y por último sobre el acrílico superior se montan las piezas plásticas junto con la placa.
- Piezas 3D:
Se diseñaron 2 piezas 3D. La primera con el fin de sujetar y alinear la bobina encargada de la transmisión de energía hacia el PCB y la segunda encargada de la sujeción y alineación de la bobina de recepción de energía así como el agarre mecánico entre el motor y el PCB. (Ver PLANO 1, (https://github.com/CastroGerman/TD2-Project/blob/master/Hardware%20Design/Maqueta/pieza%203d/PiezaFijaTD2.PDF) PLANO 2). (https://github.com/CastroGerman/TD2-Project/blob/master/Hardware%20Design/Maqueta/pieza%203d/PiezaMovilTD2.PDF)

### 2.2.2 Módulos adicionales

- Módulo de carga inalámbrica:
Se escogió un módulo (https://github.com/CastroGerman/TD2-Project/blob/master/Hardware%20Design/DataSheets/Adicionales/Wireless_Charging_Module.pdf) de carga inalámbrica (https://github.com/CastroGerman/TD2-Project/blob/master/Hardware%20Design/DataSheets/Adicionales/Wireless_Charging_Module.pdf) para transmitir la potencia necesaria para alimentar a la placa mediante el fenómeno de inducción magnética. Con esto evitamos problemas típicos de cableado, falsos contactos, ruidos y desgaste mecánico en la unión eléctrica de un sistema estático con uno en movimiento.
- Motor de corriente continúa:
Se escogió el motor SP6-1500 (https://github.com/CastroGerman/TD2-Project/blob/master/Hardware%20Design/DataSheets/Adicionales/SP6_satelital-43.pdf) debido a que poseía las suficientes revoluciones por minuto para generar el efecto de persistencia de la visión.
- Módulo de control de velocidad:
Se escogió este módulo (https://es.aliexpress.com/item/4-5-35V-90W-PWM-DC-Motor-Speed-Control-Regulator-Module-5A-Switch-Function-LED-Dimmer/32830231028.html) para poder hacer un arranque lento del motor, ademas de poder jugar con diferentes velocidades y ver cómo influye en el efecto del proyecto.
- Sensor hall:
Se escogió el modelo A1301 (https://github.com/CastroGerman/TD2-Project/blob/master/Hardware%20Design/DataSheets/Componentes%20Integrados%20PCB/A1301-2.pdf) para sensar la velocidad del motor de continua a través de un imán.
- Imán de neodimio:
Se escogió un imán (https://articulo.mercadolibre.com.ar/MLA-759919643-iman-neodimio-8x2-mm-1-unidaded-super-potencia-_JM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) de neodimio (https://articulo.mercadolibre.com.ar/MLA-759919643-iman-neodimio-8x2-mm-1-unidaded-super-potencia-_JM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) con el fin de utilizarlo como referencia para el sensor hall.

### 2.2.3 PCB: componentes principales

- Microcontrolador:
Se escogió el LPC1769. (https://github.com/CastroGerman/TD2-Project/blob/master/Hardware%20Design/DataSheets/Componentes%20Integrados%20PCB/LPC1769_68_67_66_65_64_63.pdf) Basado en un Cortex-M3 que contiene todo el firmware. Es el núcleo principal de la placa y se destinó a realizar todas sus tareas y funcionalidades.
- Registro de desplazamiento (Shifter):
Se escogió el integrado MC74HC595. (https://github.com/CastroGerman/TD2-Project/blob/master/Hardware%20Design/DataSheets/Componentes%20Integrados%20PCB/MC54HC595.pdf) Se colocaron 12 registros de desplazamiento para poder controlar los 32 leds rgb, dispuestos de una forma matricial determinada acorde al manejo de la información de los mismos por parte del microcontrolador.
- Módulo Bluetooth:
Se escogió el modulo HC-05. (https://github.com/CastroGerman/TD2-Project/blob/master/Hardware%20Design/DataSheets/Componentes%20Integrados%20PCB/hc-05.pdf) Se colocó 1 modulo bluetooth para lograr una conexión inalámbrica entre la aplicación de PC y el microcontrolador.
- Tarjeta Micro SD:
Se escogió una tarjeta micro SD (https://github.com/CastroGerman/TD2-Project/blob/master/Hardware%20Design/DataSheets/Componentes%20Integrados%20PCB/zocalo_sd_2.jpg) con el fin de poder cargar una imagen estática sin la necesidad de la aplicación de PC.
- Amplificador Operacional:
Se escogió el operacional MC33202.Se (https://github.com/CastroGerman/TD2-Project/blob/master/Hardware%20Design/DataSheets/Componentes%20Integrados%20PCB/MC33202.pdf) coloco este operacional rail to rail para que opere como smith trigger comparando la señal analogica de salida del sensor hall con una tensión estable de referencia.
- Leds RGB:
Se escogieron 32 leds RGB 1206 (https://github.com/CastroGerman/TD2-Project/blob/master/Hardware%20Design/DataSheets/Componentes%20Integrados%20PCB/LED-160-80180.pdf) para obtener una buena resolución en la imagen.
- Regulador switching:
Se escogió el integrado A5972D (https://github.com/CastroGerman/TD2-Project/blob/master/Hardware%20Design/DataSheets/Componentes%20Integrados%20PCB/A5972D.pdf) para la regulación de tensión de 5v de entrada a 3,3v de salida.

### 2.3. Circuito impreso

(Ver Esquemático) (https://github.com/CastroGerman/TD2-Project/blob/master/Hardware%20Design/PCB/PCB_TPO_TD2.PDF)

- Diseño total

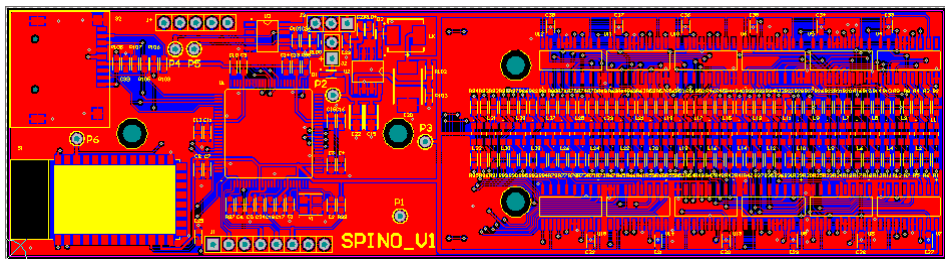
[picture p3: figure]

- Modelo 3D
(Descargar PCB3D) (https://github.com/CastroGerman/TD2-Project/blob/master/Hardware%20Design/PCB/PCB.PDF)

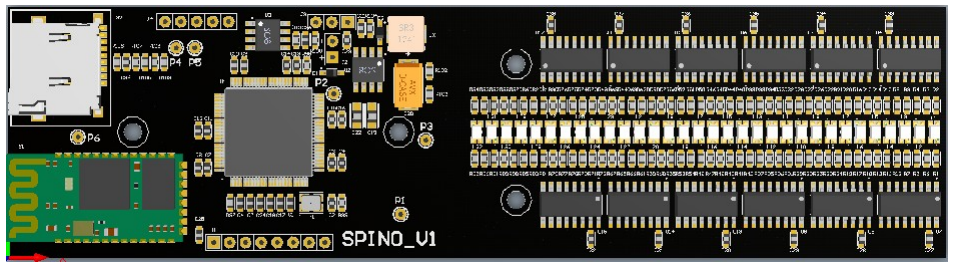
[picture p4: figure]

# 3. Firmware

### 3.1. Firmware Microcontrolador

- Funcionamiento general:

El firmware fue diseñado en base a un sistema operativo en tiempo real, y si bien su propósito final es mostrar una imagen, podemos destacar y subdividir 4 áreas de su funcionamiento.
-Secuencia de inicio:
Al iniciar el programa, se concentrará específicamente en calibrar su frecuencia de refresco de imagen para poder trabajar adecuadamente (independientemente de poseer una imagen a imprimir). Esto se logra gracias a la señal del sensor de efecto hall, de la cual se toman sucesivas muestras que, luego de un simple filtro FIR, indicarán el periodo de trabajo del motor, es decir, el tiempo que tarda en dar una vuelta.
A partir de este momento, el sistema se encuentra listo y se habilita para realizar el resto de sus tareas habituales.
-Obtención de la imagen en formato fuente:
El sistema ahora estará a la espera de una conexión por bluetooth de la cual adquiera los datos necesarios para almacenar una imagen. Mientras no tenga éxito en la conexión, tomará su imagen fuente de una tarjeta micro SD por SPI. De tener éxito, el sistema se encargará de establecer comunicación, solicitar y validar la información requerida, esta última será enviada de forma comprimida para reducir el tamaño del paquete de información.
-Procesado y almacenamiento de la imagen en formato final:
Una vez recibido el dato, será momento de descomprimirlo, interpretarlo, traducirlo y almacenarlo para posteriormente poder imprimirlo. Cabe destacar que la información enviada por la aplicación de PC y la información requerida por el firmware son de tipos y tamaños completamente diferentes, por los que necesitan una transformación especial.
Por lo tanto, la información primero sufre descompresión por el algoritmo lz4, luego transformación de tipo y por último se almacena en memoria estática esperando ser solicitada.
-Impresión de la imagen en formato final:
Por último, conociendo ya a qué frecuencia deberá imprimir los datos, el sistema empezará a enviar serialmente la información y la señal de reloj a los registros de desplazamiento, y repetirá la secuencia recorriendo fila por fila de la imagen total.
De completar la secuencia de la imagen y no poseer una nueva que imprimir, el sistema, al tener una copia de la imagen almacenada, imprimirá indefinidamente dicha imagen.

Para ver información detallada de la programación de firmware, puede ver la documentación en Doxygen. (https://github.com/CastroGerman/TD2-Project/tree/master/Informes/Doxygen)

# 4. Problemas durante el desarrollo

### 4.1 Hardware

- Manejo de leds:
Para el manejo de los leds RGB tuvimos que utilizar una multiplexacion debido a la gran cantidad de pines que representaban los 32 leds RGB

- Ruteo:
Debido a la alta densidad de trazas en el PCB por la cantidad de leds y la elección de utilizar solo 2 layers para reducir costos, encontramos dificultades a la hora de rutear por lo que utilizamos un layer para las trazas verticales y otro para las horizontales a modo de organización para facilitar el ruteo.
- Motor:
Nos encontramos con dificultades a la hora del montado de las piezas 3d sobre el motor por el tamaño del eje del motor. Una vez solucionado este problema y mediante algunos testeos llegamos a la conclusión de que al estar alimentando al PCB por inducción el motor también se veía inmerso en este campo magnético por lo que se terminaba induciendo una corriente la cual calentaba el motor. Este efecto además de ser perjudicial para el motor también generaba una pérdida de potencia por lo que se escogió cambiar el motor por uno con caja reductora de plástico, de esta manera solucionamos el problema de la inducción del motor y además conseguimos un eje más largo lo cual aumento la estabilidad de las piezas finales.
- Piezas 3D:
Se presentaron inconvenientes a la hora del diseño de las piezas 3D ya que ningún integrante poseía el conocimiento para éste, y tampoco una impresora 3D. Luego de muchos intentos habiendo solucionado problemas de contrapeso y gracias a la disponibilidad de la impresora 3D del departamento de electrónica logramos diseñar estas piezas.

### 4.2 Software PC

- Aplicación ya existente:
Se optó por utilizar una aplicación ya existente para reducir el tiempo de desarrollo del proyecto, debido a esto tuvimos problemas a la hora de hacer ingeniería inversa para identificar el formato en el cual se enviaba la imagen.

### 4.3 Firmware Microcontrolador

- Tiempos de procesamiento:
Se encontraron dificultades para hacer que el tiempo desde que se envía la imagen en la aplicación hasta que se ve realmente en el display fuera de percepción instantánea. Los algoritmos de descompresión y procesamiento, junto con los tiempos de interrupción del sistema operativo lograron superar al microcontrolador tanto en frecuencia de operación como en memoria requerida.
- Memoria disponible:
El gran almacenamiento de datos para contener copias de la imagen y la memoria que requirió individualmente cada tarea del sistema operativo, saturaron en gran parte a la memoria del microcontrolador. Se solucionó reduciendo la cantidad de tareas del sistema operativo y agrupandolas de manera estratégica. No se optó por sobredimensionar el microcontrolador porque no se contaba con dicha opción.

# 5. Software Utilizado

- Programación de microcontrolador: MCUexpress
- Diseño 3D: SolidWorks
- Planos: SolidWorks
- Diseño PCB: Altium

# 6. Referencias

- Repositorio General (https://github.com/CastroGerman/TD2-Project)
- Hojas de datos (https://github.com/CastroGerman/TD2-Project/tree/master/Hardware%20Design/DataSheets)
- Informe PCB (https://github.com/CastroGerman/TD2-Project/blob/master/Informes/dise%C3%B1o%20de%20circuitos%20impresos.pdf)
- Doxygen (https://github.com/CastroGerman/TD2-Project/tree/master/Informes/Doxygen)
- Manual Técnico (https://github.com/CastroGerman/TD2-Project/blob/master/Informes/Display_POV_Technical_Manual.pdf)
- Manual de Usuario (https://github.com/CastroGerman/TD2-Project/blob/master/Informes/Display_POV_User_Manual.pdf)
- Aplicación PC (https://github.com/CastroGerman/TD2-Project/tree/master/Software%20Design/Aplicacion-PC) (WEB del Creador) (http://rseghier.wixsite.com/spino)
- BOM (https://github.com/CastroGerman/TD2-Project/blob/master/Hardware%20Design/PCB/BOM.BOM)
- Esquemáticos (https://github.com/CastroGerman/TD2-Project/blob/master/Hardware%20Design/PCB/PCB_TPO_TD2.PDF)
- Maqueta3D (https://github.com/CastroGerman/TD2-Project/blob/master/Hardware%20Design/Maqueta/Ensamblaje.PDF)
