diazmanuel/Display-PoV/Informes/Doxygen/latex/Display_8h.tex

\hypertarget{Display_8h}{}\section{inc/\+Display.h File Reference}
\label{Display_8h}\index{inc/\+Display.\+h@{inc/\+Display.\+h}}

Asociaciones a \mbox{\hyperlink{Display_8c}{Display.\+c}}.  

{\ttfamily \#include \char`\"{}Shifter.\+h\char`\"{}}\newline
{\ttfamily \#include \char`\"{}Serial.\+h\char`\"{}}\newline
\subsection*{Macros}
\begin{DoxyCompactItemize}
\item 
\#define \mbox{\hyperlink{Display_8h_a9c1a0b24455d4675b5de3beb0728fdfb}{T\+P\+G\+P\+I\+O1}}~0,18
\item 
\#define \mbox{\hyperlink{Display_8h_aaf3cffde55e62cc65d04594d4db010e4}{T\+P\+G\+P\+I\+O2}}~0,17
\item 
\#define \mbox{\hyperlink{Display_8h_adaa9894659d4bbea802487aa0097c0b9}{T\+P\+G\+P\+I\+O3}}~0,15
\item 
\#define \mbox{\hyperlink{Display_8h_ae741f9ab5787690d8e7800ea48a040ef}{T\+P\+G\+P\+I\+O4}}~0,16
\item 
\#define \mbox{\hyperlink{Display_8h_a21b29c52d74f32c5f4fe4e9d041af738}{T\+P\+G\+P\+I\+O5}}~2,9
\end{DoxyCompactItemize}
\subsection*{Functions}
\begin{DoxyCompactItemize}
\item 
void \mbox{\hyperlink{Display_8h_a465112a01ba2b29a185fbbdec6ba2122}{Display\+Send}} (\mbox{\hyperlink{Shifter_8h_a3c4991c1fd648b348e30bea6a0edde02}{Shifter\+\_\+t}} $\ast$This\+\_\+\+Shifter)
\begin{DoxyCompactList}\small\item\em Inicia la sencuencia de impresion. \end{DoxyCompactList}\item 
void \mbox{\hyperlink{Display_8h_a74383d781cbf2a7697a4d26c61fd1486}{Display\+Stop}} (void)
\begin{DoxyCompactList}\small\item\em Detiene la sencuencia de impresion. \end{DoxyCompactList}\item 
void \mbox{\hyperlink{Display_8h_ad2b6377f664a30620696fee0fb25f20a}{Print\+Start}} (\mbox{\hyperlink{Shifter_8h_a3c4991c1fd648b348e30bea6a0edde02}{Shifter\+\_\+t}} $\ast$This\+\_\+\+Shifter)
\begin{DoxyCompactList}\small\item\em Indica el inicio de la secuencia de impresion. \end{DoxyCompactList}\item 
void \mbox{\hyperlink{Display_8h_ab75fe2736e72c9ea21d26f6e9b6619df}{Print\+Stop}} (void)
\begin{DoxyCompactList}\small\item\em Indica el final de la secuencia de impresion. \end{DoxyCompactList}\item 
void \mbox{\hyperlink{Display_8h_a81ef32728b89a8257cc5b64944bd3231}{Carga\+Data}} (\mbox{\hyperlink{Shifter_8h_a3c4991c1fd648b348e30bea6a0edde02}{Shifter\+\_\+t}} $\ast$This\+\_\+\+Shifter)
\begin{DoxyCompactList}\small\item\em Funcion de traduccion de buffers de datos. \end{DoxyCompactList}\item 
void \mbox{\hyperlink{Display_8h_a05556888b7ba8e6d337200a7e5c25707}{Descomprimir}} (void)
\begin{DoxyCompactList}\small\item\em Funcion de descompresion. \end{DoxyCompactList}\item 
void \mbox{\hyperlink{Display_8h_a852ce8afeddf2f9a8eabae3de336e393}{Stream}} (void)
\begin{DoxyCompactList}\small\item\em Aviso de refresco a la A\+PP. \end{DoxyCompactList}\item 
void \mbox{\hyperlink{Display_8h_af285c349bb1be0f91133967bf06ffc3f}{Test\+Point\+Init\+General}} (void)
\begin{DoxyCompactList}\small\item\em Inicializa Test Points en Hardware. \end{DoxyCompactList}\end{DoxyCompactItemize}

\subsection{Detailed Description}
Asociaciones a \mbox{\hyperlink{Display_8c}{Display.\+c}}. 

El codigo fuente, asi como el resto del proyecto, se encuentra disponible en su totalidad, libre y gratuito en\+:

\href{https://github.com/CastroGerman/TD2-Project/}{\tt https\+://github.\+com/\+Castro\+German/\+T\+D2-\/\+Project/}

Cualquier consulta, correccion y/o aporte al codigo y al proyecto es bienvenida por mail a\+: \href{mailto:gcastro@est.frba.utn.edu.ar}{\tt gcastro@est.\+frba.\+utn.\+edu.\+ar}

Atentamente\+: Castro Germán.

\begin{DoxyAuthor}{Author}
Castro Germán 
\end{DoxyAuthor}
\begin{DoxyDate}{Date}
07-\/\+Dic-\/2018 
\end{DoxyDate}

\subsection{Macro Definition Documentation}
\mbox{\Hypertarget{Display_8h_a9c1a0b24455d4675b5de3beb0728fdfb}\label{Display_8h_a9c1a0b24455d4675b5de3beb0728fdfb}} 
\index{Display.\+h@{Display.\+h}!T\+P\+G\+P\+I\+O1@{T\+P\+G\+P\+I\+O1}}
\index{T\+P\+G\+P\+I\+O1@{T\+P\+G\+P\+I\+O1}!Display.\+h@{Display.\+h}}
\subsubsection{\texorpdfstring{T\+P\+G\+P\+I\+O1}{TPGPIO1}}
{\footnotesize\ttfamily \#define T\+P\+G\+P\+I\+O1~0,18}

Definition at line 24 of file Display.\+h.

Referenced by Test\+Point\+Init\+General().

\mbox{\Hypertarget{Display_8h_aaf3cffde55e62cc65d04594d4db010e4}\label{Display_8h_aaf3cffde55e62cc65d04594d4db010e4}} 
\index{Display.\+h@{Display.\+h}!T\+P\+G\+P\+I\+O2@{T\+P\+G\+P\+I\+O2}}
\index{T\+P\+G\+P\+I\+O2@{T\+P\+G\+P\+I\+O2}!Display.\+h@{Display.\+h}}
\subsubsection{\texorpdfstring{T\+P\+G\+P\+I\+O2}{TPGPIO2}}
{\footnotesize\ttfamily \#define T\+P\+G\+P\+I\+O2~0,17}

Definition at line 25 of file Display.\+h.

Referenced by Test\+Point\+Init\+General().

\mbox{\Hypertarget{Display_8h_adaa9894659d4bbea802487aa0097c0b9}\label{Display_8h_adaa9894659d4bbea802487aa0097c0b9}} 
\index{Display.\+h@{Display.\+h}!T\+P\+G\+P\+I\+O3@{T\+P\+G\+P\+I\+O3}}
\index{T\+P\+G\+P\+I\+O3@{T\+P\+G\+P\+I\+O3}!Display.\+h@{Display.\+h}}
\subsubsection{\texorpdfstring{T\+P\+G\+P\+I\+O3}{TPGPIO3}}
{\footnotesize\ttfamily \#define T\+P\+G\+P\+I\+O3~0,15}

Definition at line 26 of file Display.\+h.

Referenced by Test\+Point\+Init\+General().

\mbox{\Hypertarget{Display_8h_ae741f9ab5787690d8e7800ea48a040ef}\label{Display_8h_ae741f9ab5787690d8e7800ea48a040ef}} 
\index{Display.\+h@{Display.\+h}!T\+P\+G\+P\+I\+O4@{T\+P\+G\+P\+I\+O4}}
\index{T\+P\+G\+P\+I\+O4@{T\+P\+G\+P\+I\+O4}!Display.\+h@{Display.\+h}}
\subsubsection{\texorpdfstring{T\+P\+G\+P\+I\+O4}{TPGPIO4}}
{\footnotesize\ttfamily \#define T\+P\+G\+P\+I\+O4~0,16}

Definition at line 27 of file Display.\+h.

Referenced by Test\+Point\+Init\+General().

\mbox{\Hypertarget{Display_8h_a21b29c52d74f32c5f4fe4e9d041af738}\label{Display_8h_a21b29c52d74f32c5f4fe4e9d041af738}} 
\index{Display.\+h@{Display.\+h}!T\+P\+G\+P\+I\+O5@{T\+P\+G\+P\+I\+O5}}
\index{T\+P\+G\+P\+I\+O5@{T\+P\+G\+P\+I\+O5}!Display.\+h@{Display.\+h}}
\subsubsection{\texorpdfstring{T\+P\+G\+P\+I\+O5}{TPGPIO5}}
{\footnotesize\ttfamily \#define T\+P\+G\+P\+I\+O5~2,9}

Definition at line 28 of file Display.\+h.

Referenced by Test\+Point\+Init\+General().

\subsection{Function Documentation}
\mbox{\Hypertarget{Display_8h_a81ef32728b89a8257cc5b64944bd3231}\label{Display_8h_a81ef32728b89a8257cc5b64944bd3231}} 
\index{Display.\+h@{Display.\+h}!Carga\+Data@{Carga\+Data}}
\index{Carga\+Data@{Carga\+Data}!Display.\+h@{Display.\+h}}
\subsubsection{\texorpdfstring{Carga\+Data()}{CargaData()}}
{\footnotesize\ttfamily void Carga\+Data (\begin{DoxyParamCaption}\item[{\mbox{\hyperlink{Shifter_8h_a3c4991c1fd648b348e30bea6a0edde02}{Shifter\+\_\+t}} $\ast$}]{This\+\_\+\+Shifter }\end{DoxyParamCaption})}

Funcion de traduccion de buffers de datos. 

Aplica una transformacion a los datos recibidos descomprimidos de la aplicacion de PC en un tipo de dato unsigned int y aplica logica de ordenamiento para dejar los datos listos para ser interpretados por el hardware en un Shifter\+\_\+t. 
\begin{DoxyParams}{Parameters}
{\em This\+\_\+\+Shifter} & Puntero a donde alojar el dato post-\/procesado. \\
\hline
\end{DoxyParams}

Definition at line 88 of file Display.\+c.

References Buffer\+::\+Buffers, Shifter\+::\+Data, Shifter\+::\+Data\+Source, F\+I\+L\+A\+S\+\_\+\+S\+H\+I\+F\+T\+E\+RS, Image, M\+Y\+IR, N\+\_\+\+C\+IR, N\+\_\+\+L\+E\+DS, and Phase\+Refresh.

Referenced by t\+Carga\+Data().

\mbox{\Hypertarget{Display_8h_a05556888b7ba8e6d337200a7e5c25707}\label{Display_8h_a05556888b7ba8e6d337200a7e5c25707}} 
\index{Display.\+h@{Display.\+h}!Descomprimir@{Descomprimir}}
\index{Descomprimir@{Descomprimir}!Display.\+h@{Display.\+h}}
\subsubsection{\texorpdfstring{Descomprimir()}{Descomprimir()}}
{\footnotesize\ttfamily void Descomprimir (\begin{DoxyParamCaption}\item[{void}]{ }\end{DoxyParamCaption})}

Funcion de descompresion. 

Toma el dato post-\/procesado por el algoritmo lz4 y lo guarda en el buffer de la matriz imagen completa. Por ultimo levanta el status flag indicando que esta listo para recibir y procesar otro dato. 

Definition at line 150 of file Display.\+c.

References Buffer\+::\+Buffer\+\_\+\+Index, Buffer\+::\+Buffers, Image, IW, L\+Z4\+\_\+decompress\+\_\+safe\+\_\+using\+Dict(), M\+Y\+IR, N\+\_\+\+P\+IX, ON, Status\+\_\+\+Flags, S\+T\+R\+E\+AM, Buffer\+::\+Stream\+\_\+\+Buffer, and Buffer\+::\+Stream\+\_\+\+Size.

Referenced by t\+Descomprimir().

\mbox{\Hypertarget{Display_8h_a465112a01ba2b29a185fbbdec6ba2122}\label{Display_8h_a465112a01ba2b29a185fbbdec6ba2122}} 
\index{Display.\+h@{Display.\+h}!Display\+Send@{Display\+Send}}
\index{Display\+Send@{Display\+Send}!Display.\+h@{Display.\+h}}
\subsubsection{\texorpdfstring{Display\+Send()}{DisplaySend()}}
{\footnotesize\ttfamily void Display\+Send (\begin{DoxyParamCaption}\item[{\mbox{\hyperlink{Shifter_8h_a3c4991c1fd648b348e30bea6a0edde02}{Shifter\+\_\+t}} $\ast$}]{This\+\_\+\+Shifter }\end{DoxyParamCaption})}

Inicia la sencuencia de impresion. 

Se abstrajo de Print\+Start para sumar una capa de nivel al programa. 
\begin{DoxyParams}{Parameters}
{\em This\+\_\+\+Shifter} & Puntero a la estructura \\
\hline
\end{DoxyParams}

Definition at line 37 of file Display.\+c.

References Print\+Start().

Referenced by t\+Init().

\mbox{\Hypertarget{Display_8h_a74383d781cbf2a7697a4d26c61fd1486}\label{Display_8h_a74383d781cbf2a7697a4d26c61fd1486}} 
\index{Display.\+h@{Display.\+h}!Display\+Stop@{Display\+Stop}}
\index{Display\+Stop@{Display\+Stop}!Display.\+h@{Display.\+h}}
\subsubsection{\texorpdfstring{Display\+Stop()}{DisplayStop()}}
{\footnotesize\ttfamily void Display\+Stop (\begin{DoxyParamCaption}\item[{void}]{ }\end{DoxyParamCaption})}

Detiene la sencuencia de impresion. 

Se abstrajo de Print\+Stop para sumar una capa de nivel al programa. 

Definition at line 47 of file Display.\+c.

References Print\+Stop().

Referenced by t\+Init().

\mbox{\Hypertarget{Display_8h_ad2b6377f664a30620696fee0fb25f20a}\label{Display_8h_ad2b6377f664a30620696fee0fb25f20a}} 
\index{Display.\+h@{Display.\+h}!Print\+Start@{Print\+Start}}
\index{Print\+Start@{Print\+Start}!Display.\+h@{Display.\+h}}
\subsubsection{\texorpdfstring{Print\+Start()}{PrintStart()}}
{\footnotesize\ttfamily void Print\+Start (\begin{DoxyParamCaption}\item[{\mbox{\hyperlink{Shifter_8h_a3c4991c1fd648b348e30bea6a0edde02}{Shifter\+\_\+t}} $\ast$}]{This\+\_\+\+Shifter }\end{DoxyParamCaption})}

Indica el inicio de la secuencia de impresion. 

Reinicia el indice de P\+WM, arranca el timer 0 encargado del shifteo y coloca los bits menos significativos (que es de donde parte la secuencia) en los pines fisicos de hardware. 
\begin{DoxyParams}{Parameters}
{\em This\+\_\+\+Shifter} & Puntero a la estructura \\
\hline
\end{DoxyParams}

Definition at line 58 of file Display.\+c.

References CE, D0\+\_\+\+P\+IN, D1\+\_\+\+P\+IN, D2\+\_\+\+P\+IN, D3\+\_\+\+P\+IN, Shifter\+::\+Data, M\+Y\+CR, Pwm\+State\+Index, Set\+P\+I\+N(), and T0\+T\+CR.

Referenced by Display\+Send().

\mbox{\Hypertarget{Display_8h_ab75fe2736e72c9ea21d26f6e9b6619df}\label{Display_8h_ab75fe2736e72c9ea21d26f6e9b6619df}} 
\index{Display.\+h@{Display.\+h}!Print\+Stop@{Print\+Stop}}
\index{Print\+Stop@{Print\+Stop}!Display.\+h@{Display.\+h}}
\subsubsection{\texorpdfstring{Print\+Stop()}{PrintStop()}}
{\footnotesize\ttfamily void Print\+Stop (\begin{DoxyParamCaption}\item[{void}]{ }\end{DoxyParamCaption})}

Indica el final de la secuencia de impresion. 

Para y reinicia el timer 0 y el indice de shifteo de la informacion. 

Definition at line 73 of file Display.\+c.

References CE, M\+Y\+CR, Shift\+Counter, and T0\+T\+CR.

Referenced by Display\+Stop().

\mbox{\Hypertarget{Display_8h_a852ce8afeddf2f9a8eabae3de336e393}\label{Display_8h_a852ce8afeddf2f9a8eabae3de336e393}} 
\index{Display.\+h@{Display.\+h}!Stream@{Stream}}
\index{Stream@{Stream}!Display.\+h@{Display.\+h}}
\subsubsection{\texorpdfstring{Stream()}{Stream()}}
{\footnotesize\ttfamily void Stream (\begin{DoxyParamCaption}\item[{void}]{ }\end{DoxyParamCaption})}

Aviso de refresco a la A\+PP. 

Avisa a la aplicacion de pc, una vez recibido el dato, que puede enviar uno nuevo. 

Definition at line 170 of file Display.\+c.

References ON, Serial\+\_\+\+Push\+Tx(), Status\+\_\+\+Flags, and S\+T\+R\+E\+AM.

Referenced by t\+Periodic().

\mbox{\Hypertarget{Display_8h_af285c349bb1be0f91133967bf06ffc3f}\label{Display_8h_af285c349bb1be0f91133967bf06ffc3f}} 
\index{Display.\+h@{Display.\+h}!Test\+Point\+Init\+General@{Test\+Point\+Init\+General}}
\index{Test\+Point\+Init\+General@{Test\+Point\+Init\+General}!Display.\+h@{Display.\+h}}
\subsubsection{\texorpdfstring{Test\+Point\+Init\+General()}{TestPointInitGeneral()}}
{\footnotesize\ttfamily void Test\+Point\+Init\+General (\begin{DoxyParamCaption}\item[{void}]{ }\end{DoxyParamCaption})}

Inicializa Test Points en Hardware. 

Declaro todos los test points genericos del hardware y les grabo una secuencia para medir. 

Definition at line 185 of file Display.\+c.

References Set\+D\+I\+R(), Set\+P\+I\+N(), Set\+P\+I\+N\+S\+E\+L(), T\+P\+G\+P\+I\+O1, T\+P\+G\+P\+I\+O2, T\+P\+G\+P\+I\+O3, T\+P\+G\+P\+I\+O4, and T\+P\+G\+P\+I\+O5.

Referenced by Inicializar().
