diazmanuel/Display-PoV/Informes/Doxygen/latex/GPIOLPC1769_8c.tex

\hypertarget{GPIOLPC1769_8c}{}\section{Drivers/\+G\+P\+I\+O\+L\+P\+C1769.c File Reference}
\label{GPIOLPC1769_8c}\index{Drivers/\+G\+P\+I\+O\+L\+P\+C1769.\+c@{Drivers/\+G\+P\+I\+O\+L\+P\+C1769.\+c}}

Funciones de manejo de G\+P\+IO.  

{\ttfamily \#include \char`\"{}G\+P\+I\+O\+L\+P\+C1769.\+h\char`\"{}}\newline
\subsection*{Functions}
\begin{DoxyCompactItemize}
\item 
void \mbox{\hyperlink{GPIOLPC1769_8c_a364318c9385f02fba27dab40be6dc146}{Set\+D\+IR}} (\mbox{\hyperlink{RegsLPC1769_8h_aba7bc1797add20fe3efdf37ced1182c5}{uint8\+\_\+t}} puerto, \mbox{\hyperlink{RegsLPC1769_8h_aba7bc1797add20fe3efdf37ced1182c5}{uint8\+\_\+t}} pin, \mbox{\hyperlink{RegsLPC1769_8h_aba7bc1797add20fe3efdf37ced1182c5}{uint8\+\_\+t}} dir)
\item 
void \mbox{\hyperlink{GPIOLPC1769_8c_adf2bf48acd964aa48aab6475714591c5}{Set\+P\+IN}} (\mbox{\hyperlink{RegsLPC1769_8h_aba7bc1797add20fe3efdf37ced1182c5}{uint8\+\_\+t}} puerto, \mbox{\hyperlink{RegsLPC1769_8h_aba7bc1797add20fe3efdf37ced1182c5}{uint8\+\_\+t}} pin, \mbox{\hyperlink{RegsLPC1769_8h_aba7bc1797add20fe3efdf37ced1182c5}{uint8\+\_\+t}} estado)
\item 
\mbox{\hyperlink{RegsLPC1769_8h_aba7bc1797add20fe3efdf37ced1182c5}{uint8\+\_\+t}} \mbox{\hyperlink{GPIOLPC1769_8c_aa638fbc7839d4df2a9ac29e7f2a56b7e}{Get\+P\+IN}} (\mbox{\hyperlink{RegsLPC1769_8h_aba7bc1797add20fe3efdf37ced1182c5}{uint8\+\_\+t}} puerto, \mbox{\hyperlink{RegsLPC1769_8h_aba7bc1797add20fe3efdf37ced1182c5}{uint8\+\_\+t}} pin, \mbox{\hyperlink{RegsLPC1769_8h_aba7bc1797add20fe3efdf37ced1182c5}{uint8\+\_\+t}} actividad)
\item 
void \mbox{\hyperlink{GPIOLPC1769_8c_af4fcadd3633ea324f15335ede2128d38}{toggle}} (\mbox{\hyperlink{RegsLPC1769_8h_aba7bc1797add20fe3efdf37ced1182c5}{uint8\+\_\+t}} puerto, \mbox{\hyperlink{RegsLPC1769_8h_aba7bc1797add20fe3efdf37ced1182c5}{uint8\+\_\+t}} pin)
\end{DoxyCompactItemize}

\subsection{Detailed Description}
Funciones de manejo de G\+P\+IO. 

\subsection{Function Documentation}
\mbox{\Hypertarget{GPIOLPC1769_8c_aa638fbc7839d4df2a9ac29e7f2a56b7e}\label{GPIOLPC1769_8c_aa638fbc7839d4df2a9ac29e7f2a56b7e}} 
\index{G\+P\+I\+O\+L\+P\+C1769.\+c@{G\+P\+I\+O\+L\+P\+C1769.\+c}!Get\+P\+IN@{Get\+P\+IN}}
\index{Get\+P\+IN@{Get\+P\+IN}!G\+P\+I\+O\+L\+P\+C1769.\+c@{G\+P\+I\+O\+L\+P\+C1769.\+c}}
\subsubsection{\texorpdfstring{Get\+P\+I\+N()}{GetPIN()}}
{\footnotesize\ttfamily \mbox{\hyperlink{RegsLPC1769_8h_aba7bc1797add20fe3efdf37ced1182c5}{uint8\+\_\+t}} Get\+P\+IN (\begin{DoxyParamCaption}\item[{\mbox{\hyperlink{RegsLPC1769_8h_aba7bc1797add20fe3efdf37ced1182c5}{uint8\+\_\+t}}}]{puerto,  }\item[{\mbox{\hyperlink{RegsLPC1769_8h_aba7bc1797add20fe3efdf37ced1182c5}{uint8\+\_\+t}}}]{pin,  }\item[{\mbox{\hyperlink{RegsLPC1769_8h_aba7bc1797add20fe3efdf37ced1182c5}{uint8\+\_\+t}}}]{actividad }\end{DoxyParamCaption})}

Definition at line 52 of file G\+P\+I\+O\+L\+P\+C1769.\+c.

References G\+P\+IO.

Referenced by Serial\+Manager(), and toggle().

\mbox{\Hypertarget{GPIOLPC1769_8c_a364318c9385f02fba27dab40be6dc146}\label{GPIOLPC1769_8c_a364318c9385f02fba27dab40be6dc146}} 
\index{G\+P\+I\+O\+L\+P\+C1769.\+c@{G\+P\+I\+O\+L\+P\+C1769.\+c}!Set\+D\+IR@{Set\+D\+IR}}
\index{Set\+D\+IR@{Set\+D\+IR}!G\+P\+I\+O\+L\+P\+C1769.\+c@{G\+P\+I\+O\+L\+P\+C1769.\+c}}
\subsubsection{\texorpdfstring{Set\+D\+I\+R()}{SetDIR()}}
{\footnotesize\ttfamily void Set\+D\+IR (\begin{DoxyParamCaption}\item[{\mbox{\hyperlink{RegsLPC1769_8h_aba7bc1797add20fe3efdf37ced1182c5}{uint8\+\_\+t}}}]{puerto,  }\item[{\mbox{\hyperlink{RegsLPC1769_8h_aba7bc1797add20fe3efdf37ced1182c5}{uint8\+\_\+t}}}]{pin,  }\item[{\mbox{\hyperlink{RegsLPC1769_8h_aba7bc1797add20fe3efdf37ced1182c5}{uint8\+\_\+t}}}]{dir }\end{DoxyParamCaption})}

Definition at line 18 of file G\+P\+I\+O\+L\+P\+C1769.\+c.

References G\+P\+IO.

Referenced by Config\+Pin\+Bluetooth(), Init\+Shifter(), Test\+Point\+Init\+B\+T(), and Test\+Point\+Init\+General().

\mbox{\Hypertarget{GPIOLPC1769_8c_adf2bf48acd964aa48aab6475714591c5}\label{GPIOLPC1769_8c_adf2bf48acd964aa48aab6475714591c5}} 
\index{G\+P\+I\+O\+L\+P\+C1769.\+c@{G\+P\+I\+O\+L\+P\+C1769.\+c}!Set\+P\+IN@{Set\+P\+IN}}
\index{Set\+P\+IN@{Set\+P\+IN}!G\+P\+I\+O\+L\+P\+C1769.\+c@{G\+P\+I\+O\+L\+P\+C1769.\+c}}
\subsubsection{\texorpdfstring{Set\+P\+I\+N()}{SetPIN()}}
{\footnotesize\ttfamily void Set\+P\+IN (\begin{DoxyParamCaption}\item[{\mbox{\hyperlink{RegsLPC1769_8h_aba7bc1797add20fe3efdf37ced1182c5}{uint8\+\_\+t}}}]{puerto,  }\item[{\mbox{\hyperlink{RegsLPC1769_8h_aba7bc1797add20fe3efdf37ced1182c5}{uint8\+\_\+t}}}]{pin,  }\item[{\mbox{\hyperlink{RegsLPC1769_8h_aba7bc1797add20fe3efdf37ced1182c5}{uint8\+\_\+t}}}]{estado }\end{DoxyParamCaption})}

Definition at line 35 of file G\+P\+I\+O\+L\+P\+C1769.\+c.

References G\+P\+IO.

Referenced by Bluetooth\+\_\+\+Init(), Print\+Start(), Resetear\+H\+C05(), Shift\+Data\+Interrupt(), Test\+Point\+Init\+General(), T\+I\+M\+E\+R0\+\_\+\+I\+R\+Q\+Handler(), and toggle().

\mbox{\Hypertarget{GPIOLPC1769_8c_af4fcadd3633ea324f15335ede2128d38}\label{GPIOLPC1769_8c_af4fcadd3633ea324f15335ede2128d38}} 
\index{G\+P\+I\+O\+L\+P\+C1769.\+c@{G\+P\+I\+O\+L\+P\+C1769.\+c}!toggle@{toggle}}
\index{toggle@{toggle}!G\+P\+I\+O\+L\+P\+C1769.\+c@{G\+P\+I\+O\+L\+P\+C1769.\+c}}
\subsubsection{\texorpdfstring{toggle()}{toggle()}}
{\footnotesize\ttfamily void toggle (\begin{DoxyParamCaption}\item[{\mbox{\hyperlink{RegsLPC1769_8h_aba7bc1797add20fe3efdf37ced1182c5}{uint8\+\_\+t}}}]{puerto,  }\item[{\mbox{\hyperlink{RegsLPC1769_8h_aba7bc1797add20fe3efdf37ced1182c5}{uint8\+\_\+t}}}]{pin }\end{DoxyParamCaption})}

Definition at line 68 of file G\+P\+I\+O\+L\+P\+C1769.\+c.

References Get\+P\+I\+N(), and Set\+P\+I\+N().
