diazmanuel/Display-PoV/Informes/Doxygen/latex/Initializations_8c.tex

\hypertarget{Initializations_8c}{}\section{Applications/\+Initializations.c File Reference}
\label{Initializations_8c}\index{Applications/\+Initializations.\+c@{Applications/\+Initializations.\+c}}

Contiene la inicializacion de proyecto.  

{\ttfamily \#include \char`\"{}my\+Tasks.\+h\char`\"{}}\newline
{\ttfamily \#include \char`\"{}Oscilador.\+h\char`\"{}}\newline
{\ttfamily \#include \char`\"{}U\+A\+R\+T.\+h\char`\"{}}\newline
{\ttfamily \#include \char`\"{}Bluetooth.\+h\char`\"{}}\newline
{\ttfamily \#include \char`\"{}Initializations.\+h\char`\"{}}\newline
{\ttfamily \#include \char`\"{}my\+Timers.\+h\char`\"{}}\newline
{\ttfamily \#include \char`\"{}Shifter.\+h\char`\"{}}\newline
{\ttfamily \#include \char`\"{}Interrupt\+Handler.\+h\char`\"{}}\newline
{\ttfamily \#include \char`\"{}Status\+Handler.\+h\char`\"{}}\newline
{\ttfamily \#include \char`\"{}Display.\+h\char`\"{}}\newline
\subsection*{Functions}
\begin{DoxyCompactItemize}
\item 
void \mbox{\hyperlink{Initializations_8c_a9f91672db6157602a5f91d553728d75d}{Inicializar}} (void)
\begin{DoxyCompactList}\small\item\em Inicializacion de Hardware. \end{DoxyCompactList}\end{DoxyCompactItemize}

\subsection{Detailed Description}
Contiene la inicializacion de proyecto. 

El codigo fuente, asi como el resto del proyecto, se encuentra disponible en su totalidad, libre y gratuito en\+:

\href{https://github.com/CastroGerman/TD2-Project/}{\tt https\+://github.\+com/\+Castro\+German/\+T\+D2-\/\+Project/}

Cualquier consulta, correccion y/o aporte al codigo y al proyecto es bienvenida por mail a\+: \href{mailto:gcastro@est.frba.utn.edu.ar}{\tt gcastro@est.\+frba.\+utn.\+edu.\+ar}

Atentamente\+: Castro Germán.

\begin{DoxyAuthor}{Author}
Castro Germán 
\end{DoxyAuthor}
\begin{DoxyDate}{Date}
07-\/\+Dic-\/2018 
\end{DoxyDate}

\subsection{Function Documentation}
\mbox{\Hypertarget{Initializations_8c_a9f91672db6157602a5f91d553728d75d}\label{Initializations_8c_a9f91672db6157602a5f91d553728d75d}} 
\index{Initializations.\+c@{Initializations.\+c}!Inicializar@{Inicializar}}
\index{Inicializar@{Inicializar}!Initializations.\+c@{Initializations.\+c}}
\subsubsection{\texorpdfstring{Inicializar()}{Inicializar()}}
{\footnotesize\ttfamily void Inicializar (\begin{DoxyParamCaption}\item[{void}]{ }\end{DoxyParamCaption})}

Inicializacion de Hardware. 

\begin{DoxyParams}{Parameters}
{\em void} & \\
\hline
\end{DoxyParams}
\begin{DoxyReturn}{Returns}
\+:void 
\end{DoxyReturn}

Definition at line 35 of file Initializations.\+c.

References Init\+Hall\+Sensor(), Init\+P\+L\+L(), Init\+Shifter(), Init\+Status\+Flags(), Init\+Timer0(), Init\+Timer1(), Test\+Point\+Init\+General(), and U\+A\+R\+T\+\_\+\+Init().

Referenced by t\+Init().
