diazmanuel/Display-PoV/Informes/Doxygen/latex/mmc_8c.tex

\hypertarget{mmc_8c}{}\section{spi/src/mmc.c File Reference}
\label{mmc_8c}\index{spi/src/mmc.\+c@{spi/src/mmc.\+c}}
{\ttfamily \#include \char`\"{}board.\+h\char`\"{}}\newline
{\ttfamily \#include \char`\"{}diskio.\+h\char`\"{}}\newline
\subsection*{Macros}
\begin{DoxyCompactItemize}
\item 
\#define \mbox{\hyperlink{mmc_8c_a938c1466755f12fb04ac0d1b775584d1}{C\+M\+D0}}~(0x40+0)	/$\ast$ G\+O\+\_\+\+I\+D\+L\+E\+\_\+\+S\+T\+A\+T\+E $\ast$/
\item 
\#define \mbox{\hyperlink{mmc_8c_aca9979f299fa78c1128d778084478673}{C\+M\+D1}}~(0x40+1)	/$\ast$ S\+E\+N\+D\+\_\+\+O\+P\+\_\+\+C\+O\+N\+D (\+M\+M\+C) $\ast$/
\item 
\#define \mbox{\hyperlink{mmc_8c_a9b6fdfed1b57ac31269b6b9987e0761b}{A\+C\+M\+D41}}~(0x\+C0+41)	/$\ast$ S\+E\+N\+D\+\_\+\+O\+P\+\_\+\+C\+O\+N\+D (\+S\+D\+C) $\ast$/
\item 
\#define \mbox{\hyperlink{mmc_8c_ac75b3e0ad1fb013ea946fb49bbe65668}{C\+M\+D8}}~(0x40+8)	/$\ast$ S\+E\+N\+D\+\_\+\+I\+F\+\_\+\+C\+O\+N\+D $\ast$/
\item 
\#define \mbox{\hyperlink{mmc_8c_a1fac6a251d7e7dc204d21639bf521459}{C\+M\+D9}}~(0x40+9)	/$\ast$ S\+E\+N\+D\+\_\+\+C\+S\+D $\ast$/
\item 
\#define \mbox{\hyperlink{mmc_8c_ae7b800ed8e7bd52e6f570a5ce72b8104}{C\+M\+D10}}~(0x40+10)	/$\ast$ S\+E\+N\+D\+\_\+\+C\+I\+D $\ast$/
\item 
\#define \mbox{\hyperlink{mmc_8c_a8d6283c9b060afbaa0e6d1ff7e5ea7b8}{C\+M\+D12}}~(0x40+12)	/$\ast$ S\+T\+O\+P\+\_\+\+T\+R\+A\+N\+S\+M\+I\+S\+S\+I\+O\+N $\ast$/
\item 
\#define \mbox{\hyperlink{mmc_8c_a4be8f501d86d24b02923846db618fc71}{A\+C\+M\+D13}}~(0x\+C0+13)	/$\ast$ S\+D\+\_\+\+S\+T\+A\+T\+U\+S (\+S\+D\+C) $\ast$/
\item 
\#define \mbox{\hyperlink{mmc_8c_aaeab261b94f2031ba41a1d4d857c3541}{C\+M\+D16}}~(0x40+16)	/$\ast$ S\+E\+T\+\_\+\+B\+L\+O\+C\+K\+L\+E\+N $\ast$/
\item 
\#define \mbox{\hyperlink{mmc_8c_a6bbfe7dc16a19b7f40efcf554b5666ad}{C\+M\+D17}}~(0x40+17)	/$\ast$ R\+E\+A\+D\+\_\+\+S\+I\+N\+G\+L\+E\+\_\+\+B\+L\+O\+C\+K $\ast$/
\item 
\#define \mbox{\hyperlink{mmc_8c_a3d32c27a6be061b865ba539127278f14}{C\+M\+D18}}~(0x40+18)	/$\ast$ R\+E\+A\+D\+\_\+\+M\+U\+L\+T\+I\+P\+L\+E\+\_\+\+B\+L\+O\+C\+K $\ast$/
\item 
\#define \mbox{\hyperlink{mmc_8c_a14506e981f38b6177bc36f72c2ca18b1}{C\+M\+D23}}~(0x40+23)	/$\ast$ S\+E\+T\+\_\+\+B\+L\+O\+C\+K\+\_\+\+C\+O\+U\+N\+T (\+M\+M\+C) $\ast$/
\item 
\#define \mbox{\hyperlink{mmc_8c_aa38144d651e2880f92c65bb683621f78}{A\+C\+M\+D23}}~(0x\+C0+23)	/$\ast$ S\+E\+T\+\_\+\+W\+R\+\_\+\+B\+L\+K\+\_\+\+E\+R\+A\+S\+E\+\_\+\+C\+O\+U\+N\+T (\+S\+D\+C) $\ast$/
\item 
\#define \mbox{\hyperlink{mmc_8c_a252300302c6f7960df547a7f5c25be85}{C\+M\+D24}}~(0x40+24)	/$\ast$ W\+R\+I\+T\+E\+\_\+\+B\+L\+O\+C\+K $\ast$/
\item 
\#define \mbox{\hyperlink{mmc_8c_aee2c673fba987178f4642531fdeefe9e}{C\+M\+D25}}~(0x40+25)	/$\ast$ W\+R\+I\+T\+E\+\_\+\+M\+U\+L\+T\+I\+P\+L\+E\+\_\+\+B\+L\+O\+C\+K $\ast$/
\item 
\#define \mbox{\hyperlink{mmc_8c_a78289a7a85ffcfddd626694105dc0780}{C\+M\+D55}}~(0x40+55)	/$\ast$ A\+P\+P\+\_\+\+C\+M\+D $\ast$/
\item 
\#define \mbox{\hyperlink{mmc_8c_aa7a26b2cf17e1ff5967820a1fa41a7aa}{C\+M\+D58}}~(0x40+58)	/$\ast$ R\+E\+A\+D\+\_\+\+O\+C\+R $\ast$/
\item 
\#define \mbox{\hyperlink{mmc_8c_ae4cc35dcc70810fa972cc8a5185a28fa}{B\+O\+OL}}~bool
\item 
\#define \mbox{\hyperlink{mmc_8c_ab6b224028ee993b43049cd45010ec00f}{C\+S\+\_\+\+L\+OW}}()~Chip\+\_\+\+G\+P\+I\+O\+\_\+\+Set\+Pin\+Out\+Low(L\+P\+C\+\_\+\+G\+P\+IO, 0, 6)
\item 
\#define \mbox{\hyperlink{mmc_8c_af67a5c0216de0cfadf059fa4cf05d65d}{C\+S\+\_\+\+H\+I\+GH}}()~Chip\+\_\+\+G\+P\+I\+O\+\_\+\+Set\+Pin\+Out\+High(L\+P\+C\+\_\+\+G\+P\+IO, 0, 6)
\item 
\#define \mbox{\hyperlink{mmc_8c_ae3d9176798d1718d779e2db397de4bb5}{F\+C\+L\+K\+\_\+\+S\+L\+OW}}()~/$\ast$ Set slow clock (100k-\/400k) $\ast$/
\item 
\#define \mbox{\hyperlink{mmc_8c_a1ffcdd6f111fd9b4229f49a5e37046b7}{F\+C\+L\+K\+\_\+\+F\+A\+ST}}()~/$\ast$ Set fast clock (depends on the C\+SD) $\ast$/
\item 
\#define \mbox{\hyperlink{mmc_8c_a317ab656a06a309fbb136df11cb83535}{rcvr\+\_\+spi\+\_\+m}}(\mbox{\hyperlink{lz4_8h_a961c13eb7fcda15b167b953cac1ab3ec}{dst}})
\end{DoxyCompactItemize}
\subsection*{Functions}
\begin{DoxyCompactItemize}
\item 
void \mbox{\hyperlink{mmc_8c_a3c8830caf8a7efcd3be2c8a0b963099e}{S\+S\+P\+Receive}} (\mbox{\hyperlink{RegsLPC1769_8h_aba7bc1797add20fe3efdf37ced1182c5}{uint8\+\_\+t}} $\ast$buf, \mbox{\hyperlink{RegsLPC1769_8h_a435d1572bf3f880d55459d9805097f62}{uint32\+\_\+t}} Length)
\item 
D\+S\+T\+A\+T\+US \mbox{\hyperlink{mmc_8c_a8e429a29bdbb73f5bc9e2ab2335a5112}{disk\+\_\+initialize}} (\mbox{\hyperlink{lz4_8c_a4ae1dab0fb4b072a66584546209e7d58}{B\+Y\+TE}} drv)
\item 
D\+S\+T\+A\+T\+US \mbox{\hyperlink{mmc_8c_a21ad8e9a107ea2000705a3edfebaaa2d}{disk\+\_\+status}} (\mbox{\hyperlink{lz4_8c_a4ae1dab0fb4b072a66584546209e7d58}{B\+Y\+TE}} drv)
\item 
D\+R\+E\+S\+U\+LT \mbox{\hyperlink{mmc_8c_a99e229031022d13ac273b6ea78af49cd}{disk\+\_\+read}} (\mbox{\hyperlink{lz4_8c_a4ae1dab0fb4b072a66584546209e7d58}{B\+Y\+TE}} drv, \mbox{\hyperlink{lz4_8c_a4ae1dab0fb4b072a66584546209e7d58}{B\+Y\+TE}} $\ast$buff, D\+W\+O\+RD sector, U\+I\+NT count)
\item 
D\+R\+E\+S\+U\+LT \mbox{\hyperlink{mmc_8c_ac03220b2c8a090b4f76eb2c9407b84fb}{disk\+\_\+write}} (\mbox{\hyperlink{lz4_8c_a4ae1dab0fb4b072a66584546209e7d58}{B\+Y\+TE}} drv, const \mbox{\hyperlink{lz4_8c_a4ae1dab0fb4b072a66584546209e7d58}{B\+Y\+TE}} $\ast$buff, D\+W\+O\+RD sector, U\+I\+NT count)
\item 
void \mbox{\hyperlink{mmc_8c_a045f8898a243c16aca4e64e069c49c03}{disk\+\_\+timerproc}} (void)
\end{DoxyCompactItemize}

\subsection{Macro Definition Documentation}
\mbox{\Hypertarget{mmc_8c_a4be8f501d86d24b02923846db618fc71}\label{mmc_8c_a4be8f501d86d24b02923846db618fc71}} 
\index{mmc.\+c@{mmc.\+c}!A\+C\+M\+D13@{A\+C\+M\+D13}}
\index{A\+C\+M\+D13@{A\+C\+M\+D13}!mmc.\+c@{mmc.\+c}}
\subsubsection{\texorpdfstring{A\+C\+M\+D13}{ACMD13}}
{\footnotesize\ttfamily \#define A\+C\+M\+D13~(0x\+C0+13)	/$\ast$ S\+D\+\_\+\+S\+T\+A\+T\+U\+S (\+S\+D\+C) $\ast$/}

Definition at line 20 of file mmc.\+c.

\mbox{\Hypertarget{mmc_8c_aa38144d651e2880f92c65bb683621f78}\label{mmc_8c_aa38144d651e2880f92c65bb683621f78}} 
\index{mmc.\+c@{mmc.\+c}!A\+C\+M\+D23@{A\+C\+M\+D23}}
\index{A\+C\+M\+D23@{A\+C\+M\+D23}!mmc.\+c@{mmc.\+c}}
\subsubsection{\texorpdfstring{A\+C\+M\+D23}{ACMD23}}
{\footnotesize\ttfamily \#define A\+C\+M\+D23~(0x\+C0+23)	/$\ast$ S\+E\+T\+\_\+\+W\+R\+\_\+\+B\+L\+K\+\_\+\+E\+R\+A\+S\+E\+\_\+\+C\+O\+U\+N\+T (\+S\+D\+C) $\ast$/}

Definition at line 25 of file mmc.\+c.

\mbox{\Hypertarget{mmc_8c_a9b6fdfed1b57ac31269b6b9987e0761b}\label{mmc_8c_a9b6fdfed1b57ac31269b6b9987e0761b}} 
\index{mmc.\+c@{mmc.\+c}!A\+C\+M\+D41@{A\+C\+M\+D41}}
\index{A\+C\+M\+D41@{A\+C\+M\+D41}!mmc.\+c@{mmc.\+c}}
\subsubsection{\texorpdfstring{A\+C\+M\+D41}{ACMD41}}
{\footnotesize\ttfamily \#define A\+C\+M\+D41~(0x\+C0+41)	/$\ast$ S\+E\+N\+D\+\_\+\+O\+P\+\_\+\+C\+O\+N\+D (\+S\+D\+C) $\ast$/}

Definition at line 15 of file mmc.\+c.

\mbox{\Hypertarget{mmc_8c_ae4cc35dcc70810fa972cc8a5185a28fa}\label{mmc_8c_ae4cc35dcc70810fa972cc8a5185a28fa}} 
\index{mmc.\+c@{mmc.\+c}!B\+O\+OL@{B\+O\+OL}}
\index{B\+O\+OL@{B\+O\+OL}!mmc.\+c@{mmc.\+c}}
\subsubsection{\texorpdfstring{B\+O\+OL}{BOOL}}
{\footnotesize\ttfamily \#define B\+O\+OL~bool}

Definition at line 31 of file mmc.\+c.

\mbox{\Hypertarget{mmc_8c_a938c1466755f12fb04ac0d1b775584d1}\label{mmc_8c_a938c1466755f12fb04ac0d1b775584d1}} 
\index{mmc.\+c@{mmc.\+c}!C\+M\+D0@{C\+M\+D0}}
\index{C\+M\+D0@{C\+M\+D0}!mmc.\+c@{mmc.\+c}}
\subsubsection{\texorpdfstring{C\+M\+D0}{CMD0}}
{\footnotesize\ttfamily \#define C\+M\+D0~(0x40+0)	/$\ast$ G\+O\+\_\+\+I\+D\+L\+E\+\_\+\+S\+T\+A\+T\+E $\ast$/}

Definition at line 13 of file mmc.\+c.

\mbox{\Hypertarget{mmc_8c_aca9979f299fa78c1128d778084478673}\label{mmc_8c_aca9979f299fa78c1128d778084478673}} 
\index{mmc.\+c@{mmc.\+c}!C\+M\+D1@{C\+M\+D1}}
\index{C\+M\+D1@{C\+M\+D1}!mmc.\+c@{mmc.\+c}}
\subsubsection{\texorpdfstring{C\+M\+D1}{CMD1}}
{\footnotesize\ttfamily \#define C\+M\+D1~(0x40+1)	/$\ast$ S\+E\+N\+D\+\_\+\+O\+P\+\_\+\+C\+O\+N\+D (\+M\+M\+C) $\ast$/}

Definition at line 14 of file mmc.\+c.

\mbox{\Hypertarget{mmc_8c_ae7b800ed8e7bd52e6f570a5ce72b8104}\label{mmc_8c_ae7b800ed8e7bd52e6f570a5ce72b8104}} 
\index{mmc.\+c@{mmc.\+c}!C\+M\+D10@{C\+M\+D10}}
\index{C\+M\+D10@{C\+M\+D10}!mmc.\+c@{mmc.\+c}}
\subsubsection{\texorpdfstring{C\+M\+D10}{CMD10}}
{\footnotesize\ttfamily \#define C\+M\+D10~(0x40+10)	/$\ast$ S\+E\+N\+D\+\_\+\+C\+I\+D $\ast$/}

Definition at line 18 of file mmc.\+c.

\mbox{\Hypertarget{mmc_8c_a8d6283c9b060afbaa0e6d1ff7e5ea7b8}\label{mmc_8c_a8d6283c9b060afbaa0e6d1ff7e5ea7b8}} 
\index{mmc.\+c@{mmc.\+c}!C\+M\+D12@{C\+M\+D12}}
\index{C\+M\+D12@{C\+M\+D12}!mmc.\+c@{mmc.\+c}}
\subsubsection{\texorpdfstring{C\+M\+D12}{CMD12}}
{\footnotesize\ttfamily \#define C\+M\+D12~(0x40+12)	/$\ast$ S\+T\+O\+P\+\_\+\+T\+R\+A\+N\+S\+M\+I\+S\+S\+I\+O\+N $\ast$/}

Definition at line 19 of file mmc.\+c.

\mbox{\Hypertarget{mmc_8c_aaeab261b94f2031ba41a1d4d857c3541}\label{mmc_8c_aaeab261b94f2031ba41a1d4d857c3541}} 
\index{mmc.\+c@{mmc.\+c}!C\+M\+D16@{C\+M\+D16}}
\index{C\+M\+D16@{C\+M\+D16}!mmc.\+c@{mmc.\+c}}
\subsubsection{\texorpdfstring{C\+M\+D16}{CMD16}}
{\footnotesize\ttfamily \#define C\+M\+D16~(0x40+16)	/$\ast$ S\+E\+T\+\_\+\+B\+L\+O\+C\+K\+L\+E\+N $\ast$/}

Definition at line 21 of file mmc.\+c.

\mbox{\Hypertarget{mmc_8c_a6bbfe7dc16a19b7f40efcf554b5666ad}\label{mmc_8c_a6bbfe7dc16a19b7f40efcf554b5666ad}} 
\index{mmc.\+c@{mmc.\+c}!C\+M\+D17@{C\+M\+D17}}
\index{C\+M\+D17@{C\+M\+D17}!mmc.\+c@{mmc.\+c}}
\subsubsection{\texorpdfstring{C\+M\+D17}{CMD17}}
{\footnotesize\ttfamily \#define C\+M\+D17~(0x40+17)	/$\ast$ R\+E\+A\+D\+\_\+\+S\+I\+N\+G\+L\+E\+\_\+\+B\+L\+O\+C\+K $\ast$/}

Definition at line 22 of file mmc.\+c.

\mbox{\Hypertarget{mmc_8c_a3d32c27a6be061b865ba539127278f14}\label{mmc_8c_a3d32c27a6be061b865ba539127278f14}} 
\index{mmc.\+c@{mmc.\+c}!C\+M\+D18@{C\+M\+D18}}
\index{C\+M\+D18@{C\+M\+D18}!mmc.\+c@{mmc.\+c}}
\subsubsection{\texorpdfstring{C\+M\+D18}{CMD18}}
{\footnotesize\ttfamily \#define C\+M\+D18~(0x40+18)	/$\ast$ R\+E\+A\+D\+\_\+\+M\+U\+L\+T\+I\+P\+L\+E\+\_\+\+B\+L\+O\+C\+K $\ast$/}

Definition at line 23 of file mmc.\+c.

\mbox{\Hypertarget{mmc_8c_a14506e981f38b6177bc36f72c2ca18b1}\label{mmc_8c_a14506e981f38b6177bc36f72c2ca18b1}} 
\index{mmc.\+c@{mmc.\+c}!C\+M\+D23@{C\+M\+D23}}
\index{C\+M\+D23@{C\+M\+D23}!mmc.\+c@{mmc.\+c}}
\subsubsection{\texorpdfstring{C\+M\+D23}{CMD23}}
{\footnotesize\ttfamily \#define C\+M\+D23~(0x40+23)	/$\ast$ S\+E\+T\+\_\+\+B\+L\+O\+C\+K\+\_\+\+C\+O\+U\+N\+T (\+M\+M\+C) $\ast$/}

Definition at line 24 of file mmc.\+c.

\mbox{\Hypertarget{mmc_8c_a252300302c6f7960df547a7f5c25be85}\label{mmc_8c_a252300302c6f7960df547a7f5c25be85}} 
\index{mmc.\+c@{mmc.\+c}!C\+M\+D24@{C\+M\+D24}}
\index{C\+M\+D24@{C\+M\+D24}!mmc.\+c@{mmc.\+c}}
\subsubsection{\texorpdfstring{C\+M\+D24}{CMD24}}
{\footnotesize\ttfamily \#define C\+M\+D24~(0x40+24)	/$\ast$ W\+R\+I\+T\+E\+\_\+\+B\+L\+O\+C\+K $\ast$/}

Definition at line 26 of file mmc.\+c.

\mbox{\Hypertarget{mmc_8c_aee2c673fba987178f4642531fdeefe9e}\label{mmc_8c_aee2c673fba987178f4642531fdeefe9e}} 
\index{mmc.\+c@{mmc.\+c}!C\+M\+D25@{C\+M\+D25}}
\index{C\+M\+D25@{C\+M\+D25}!mmc.\+c@{mmc.\+c}}
\subsubsection{\texorpdfstring{C\+M\+D25}{CMD25}}
{\footnotesize\ttfamily \#define C\+M\+D25~(0x40+25)	/$\ast$ W\+R\+I\+T\+E\+\_\+\+M\+U\+L\+T\+I\+P\+L\+E\+\_\+\+B\+L\+O\+C\+K $\ast$/}

Definition at line 27 of file mmc.\+c.

\mbox{\Hypertarget{mmc_8c_a78289a7a85ffcfddd626694105dc0780}\label{mmc_8c_a78289a7a85ffcfddd626694105dc0780}} 
\index{mmc.\+c@{mmc.\+c}!C\+M\+D55@{C\+M\+D55}}
\index{C\+M\+D55@{C\+M\+D55}!mmc.\+c@{mmc.\+c}}
\subsubsection{\texorpdfstring{C\+M\+D55}{CMD55}}
{\footnotesize\ttfamily \#define C\+M\+D55~(0x40+55)	/$\ast$ A\+P\+P\+\_\+\+C\+M\+D $\ast$/}

Definition at line 28 of file mmc.\+c.

\mbox{\Hypertarget{mmc_8c_aa7a26b2cf17e1ff5967820a1fa41a7aa}\label{mmc_8c_aa7a26b2cf17e1ff5967820a1fa41a7aa}} 
\index{mmc.\+c@{mmc.\+c}!C\+M\+D58@{C\+M\+D58}}
\index{C\+M\+D58@{C\+M\+D58}!mmc.\+c@{mmc.\+c}}
\subsubsection{\texorpdfstring{C\+M\+D58}{CMD58}}
{\footnotesize\ttfamily \#define C\+M\+D58~(0x40+58)	/$\ast$ R\+E\+A\+D\+\_\+\+O\+C\+R $\ast$/}

Definition at line 29 of file mmc.\+c.

\mbox{\Hypertarget{mmc_8c_ac75b3e0ad1fb013ea946fb49bbe65668}\label{mmc_8c_ac75b3e0ad1fb013ea946fb49bbe65668}} 
\index{mmc.\+c@{mmc.\+c}!C\+M\+D8@{C\+M\+D8}}
\index{C\+M\+D8@{C\+M\+D8}!mmc.\+c@{mmc.\+c}}
\subsubsection{\texorpdfstring{C\+M\+D8}{CMD8}}
{\footnotesize\ttfamily \#define C\+M\+D8~(0x40+8)	/$\ast$ S\+E\+N\+D\+\_\+\+I\+F\+\_\+\+C\+O\+N\+D $\ast$/}

Definition at line 16 of file mmc.\+c.

\mbox{\Hypertarget{mmc_8c_a1fac6a251d7e7dc204d21639bf521459}\label{mmc_8c_a1fac6a251d7e7dc204d21639bf521459}} 
\index{mmc.\+c@{mmc.\+c}!C\+M\+D9@{C\+M\+D9}}
\index{C\+M\+D9@{C\+M\+D9}!mmc.\+c@{mmc.\+c}}
\subsubsection{\texorpdfstring{C\+M\+D9}{CMD9}}
{\footnotesize\ttfamily \#define C\+M\+D9~(0x40+9)	/$\ast$ S\+E\+N\+D\+\_\+\+C\+S\+D $\ast$/}

Definition at line 17 of file mmc.\+c.

\mbox{\Hypertarget{mmc_8c_af67a5c0216de0cfadf059fa4cf05d65d}\label{mmc_8c_af67a5c0216de0cfadf059fa4cf05d65d}} 
\index{mmc.\+c@{mmc.\+c}!C\+S\+\_\+\+H\+I\+GH@{C\+S\+\_\+\+H\+I\+GH}}
\index{C\+S\+\_\+\+H\+I\+GH@{C\+S\+\_\+\+H\+I\+GH}!mmc.\+c@{mmc.\+c}}
\subsubsection{\texorpdfstring{C\+S\+\_\+\+H\+I\+GH}{CS\_HIGH}}
{\footnotesize\ttfamily \#define C\+S\+\_\+\+H\+I\+GH(\begin{DoxyParamCaption}{ }\end{DoxyParamCaption})~Chip\+\_\+\+G\+P\+I\+O\+\_\+\+Set\+Pin\+Out\+High(L\+P\+C\+\_\+\+G\+P\+IO, 0, 6)}

Definition at line 35 of file mmc.\+c.

\mbox{\Hypertarget{mmc_8c_ab6b224028ee993b43049cd45010ec00f}\label{mmc_8c_ab6b224028ee993b43049cd45010ec00f}} 
\index{mmc.\+c@{mmc.\+c}!C\+S\+\_\+\+L\+OW@{C\+S\+\_\+\+L\+OW}}
\index{C\+S\+\_\+\+L\+OW@{C\+S\+\_\+\+L\+OW}!mmc.\+c@{mmc.\+c}}
\subsubsection{\texorpdfstring{C\+S\+\_\+\+L\+OW}{CS\_LOW}}
{\footnotesize\ttfamily \#define C\+S\+\_\+\+L\+OW(\begin{DoxyParamCaption}{ }\end{DoxyParamCaption})~Chip\+\_\+\+G\+P\+I\+O\+\_\+\+Set\+Pin\+Out\+Low(L\+P\+C\+\_\+\+G\+P\+IO, 0, 6)}

Definition at line 34 of file mmc.\+c.

\mbox{\Hypertarget{mmc_8c_a1ffcdd6f111fd9b4229f49a5e37046b7}\label{mmc_8c_a1ffcdd6f111fd9b4229f49a5e37046b7}} 
\index{mmc.\+c@{mmc.\+c}!F\+C\+L\+K\+\_\+\+F\+A\+ST@{F\+C\+L\+K\+\_\+\+F\+A\+ST}}
\index{F\+C\+L\+K\+\_\+\+F\+A\+ST@{F\+C\+L\+K\+\_\+\+F\+A\+ST}!mmc.\+c@{mmc.\+c}}
\subsubsection{\texorpdfstring{F\+C\+L\+K\+\_\+\+F\+A\+ST}{FCLK\_FAST}}
{\footnotesize\ttfamily \#define F\+C\+L\+K\+\_\+\+F\+A\+ST(\begin{DoxyParamCaption}{ }\end{DoxyParamCaption})~/$\ast$ Set fast clock (depends on the C\+SD) $\ast$/}

Definition at line 38 of file mmc.\+c.

\mbox{\Hypertarget{mmc_8c_ae3d9176798d1718d779e2db397de4bb5}\label{mmc_8c_ae3d9176798d1718d779e2db397de4bb5}} 
\index{mmc.\+c@{mmc.\+c}!F\+C\+L\+K\+\_\+\+S\+L\+OW@{F\+C\+L\+K\+\_\+\+S\+L\+OW}}
\index{F\+C\+L\+K\+\_\+\+S\+L\+OW@{F\+C\+L\+K\+\_\+\+S\+L\+OW}!mmc.\+c@{mmc.\+c}}
\subsubsection{\texorpdfstring{F\+C\+L\+K\+\_\+\+S\+L\+OW}{FCLK\_SLOW}}
{\footnotesize\ttfamily \#define F\+C\+L\+K\+\_\+\+S\+L\+OW(\begin{DoxyParamCaption}{ }\end{DoxyParamCaption})~/$\ast$ Set slow clock (100k-\/400k) $\ast$/}

Definition at line 37 of file mmc.\+c.

\mbox{\Hypertarget{mmc_8c_a317ab656a06a309fbb136df11cb83535}\label{mmc_8c_a317ab656a06a309fbb136df11cb83535}} 
\index{mmc.\+c@{mmc.\+c}!rcvr\+\_\+spi\+\_\+m@{rcvr\+\_\+spi\+\_\+m}}
\index{rcvr\+\_\+spi\+\_\+m@{rcvr\+\_\+spi\+\_\+m}!mmc.\+c@{mmc.\+c}}
\subsubsection{\texorpdfstring{rcvr\+\_\+spi\+\_\+m}{rcvr\_spi\_m}}
{\footnotesize\ttfamily \#define rcvr\+\_\+spi\+\_\+m(\begin{DoxyParamCaption}\item[{}]{\mbox{\hyperlink{lz4_8h_a961c13eb7fcda15b167b953cac1ab3ec}{dst}} }\end{DoxyParamCaption})}

{\bfseries Value\+:}
\begin{DoxyCode}
\textcolor{keywordflow}{do} \{ \(\backslash\)
        SSPReceive((\mbox{\hyperlink{RegsLPC1769_8h_aba7bc1797add20fe3efdf37ced1182c5}{uint8\_t}}*)(\mbox{\hyperlink{lz4_8h_a961c13eb7fcda15b167b953cac1ab3ec}{dst}}), 1); \(\backslash\)
    \} \textcolor{keywordflow}{while}(0)
\end{DoxyCode}

Definition at line 110 of file mmc.\+c.

\subsection{Function Documentation}
\mbox{\Hypertarget{mmc_8c_a8e429a29bdbb73f5bc9e2ab2335a5112}\label{mmc_8c_a8e429a29bdbb73f5bc9e2ab2335a5112}} 
\index{mmc.\+c@{mmc.\+c}!disk\+\_\+initialize@{disk\+\_\+initialize}}
\index{disk\+\_\+initialize@{disk\+\_\+initialize}!mmc.\+c@{mmc.\+c}}
\subsubsection{\texorpdfstring{disk\+\_\+initialize()}{disk\_initialize()}}
{\footnotesize\ttfamily D\+S\+T\+A\+T\+US disk\+\_\+initialize (\begin{DoxyParamCaption}\item[{\mbox{\hyperlink{lz4_8c_a4ae1dab0fb4b072a66584546209e7d58}{B\+Y\+TE}}}]{drv }\end{DoxyParamCaption})}

Definition at line 319 of file mmc.\+c.

\mbox{\Hypertarget{mmc_8c_a99e229031022d13ac273b6ea78af49cd}\label{mmc_8c_a99e229031022d13ac273b6ea78af49cd}} 
\index{mmc.\+c@{mmc.\+c}!disk\+\_\+read@{disk\+\_\+read}}
\index{disk\+\_\+read@{disk\+\_\+read}!mmc.\+c@{mmc.\+c}}
\subsubsection{\texorpdfstring{disk\+\_\+read()}{disk\_read()}}
{\footnotesize\ttfamily D\+R\+E\+S\+U\+LT disk\+\_\+read (\begin{DoxyParamCaption}\item[{\mbox{\hyperlink{lz4_8c_a4ae1dab0fb4b072a66584546209e7d58}{B\+Y\+TE}}}]{drv,  }\item[{\mbox{\hyperlink{lz4_8c_a4ae1dab0fb4b072a66584546209e7d58}{B\+Y\+TE}} $\ast$}]{buff,  }\item[{D\+W\+O\+RD}]{sector,  }\item[{U\+I\+NT}]{count }\end{DoxyParamCaption})}

Definition at line 388 of file mmc.\+c.

\mbox{\Hypertarget{mmc_8c_a21ad8e9a107ea2000705a3edfebaaa2d}\label{mmc_8c_a21ad8e9a107ea2000705a3edfebaaa2d}} 
\index{mmc.\+c@{mmc.\+c}!disk\+\_\+status@{disk\+\_\+status}}
\index{disk\+\_\+status@{disk\+\_\+status}!mmc.\+c@{mmc.\+c}}
\subsubsection{\texorpdfstring{disk\+\_\+status()}{disk\_status()}}
{\footnotesize\ttfamily D\+S\+T\+A\+T\+US disk\+\_\+status (\begin{DoxyParamCaption}\item[{\mbox{\hyperlink{lz4_8c_a4ae1dab0fb4b072a66584546209e7d58}{B\+Y\+TE}}}]{drv }\end{DoxyParamCaption})}

Definition at line 374 of file mmc.\+c.

\mbox{\Hypertarget{mmc_8c_a045f8898a243c16aca4e64e069c49c03}\label{mmc_8c_a045f8898a243c16aca4e64e069c49c03}} 
\index{mmc.\+c@{mmc.\+c}!disk\+\_\+timerproc@{disk\+\_\+timerproc}}
\index{disk\+\_\+timerproc@{disk\+\_\+timerproc}!mmc.\+c@{mmc.\+c}}
\subsubsection{\texorpdfstring{disk\+\_\+timerproc()}{disk\_timerproc()}}
{\footnotesize\ttfamily void disk\+\_\+timerproc (\begin{DoxyParamCaption}\item[{void}]{ }\end{DoxyParamCaption})}

Definition at line 604 of file mmc.\+c.

Referenced by t\+Periodic().

\mbox{\Hypertarget{mmc_8c_ac03220b2c8a090b4f76eb2c9407b84fb}\label{mmc_8c_ac03220b2c8a090b4f76eb2c9407b84fb}} 
\index{mmc.\+c@{mmc.\+c}!disk\+\_\+write@{disk\+\_\+write}}
\index{disk\+\_\+write@{disk\+\_\+write}!mmc.\+c@{mmc.\+c}}
\subsubsection{\texorpdfstring{disk\+\_\+write()}{disk\_write()}}
{\footnotesize\ttfamily D\+R\+E\+S\+U\+LT disk\+\_\+write (\begin{DoxyParamCaption}\item[{\mbox{\hyperlink{lz4_8c_a4ae1dab0fb4b072a66584546209e7d58}{B\+Y\+TE}}}]{drv,  }\item[{const \mbox{\hyperlink{lz4_8c_a4ae1dab0fb4b072a66584546209e7d58}{B\+Y\+TE}} $\ast$}]{buff,  }\item[{D\+W\+O\+RD}]{sector,  }\item[{U\+I\+NT}]{count }\end{DoxyParamCaption})}

Definition at line 426 of file mmc.\+c.

\mbox{\Hypertarget{mmc_8c_a3c8830caf8a7efcd3be2c8a0b963099e}\label{mmc_8c_a3c8830caf8a7efcd3be2c8a0b963099e}} 
\index{mmc.\+c@{mmc.\+c}!S\+S\+P\+Receive@{S\+S\+P\+Receive}}
\index{S\+S\+P\+Receive@{S\+S\+P\+Receive}!mmc.\+c@{mmc.\+c}}
\subsubsection{\texorpdfstring{S\+S\+P\+Receive()}{SSPReceive()}}
{\footnotesize\ttfamily void S\+S\+P\+Receive (\begin{DoxyParamCaption}\item[{\mbox{\hyperlink{RegsLPC1769_8h_aba7bc1797add20fe3efdf37ced1182c5}{uint8\+\_\+t}} $\ast$}]{buf,  }\item[{\mbox{\hyperlink{RegsLPC1769_8h_a435d1572bf3f880d55459d9805097f62}{uint32\+\_\+t}}}]{Length }\end{DoxyParamCaption})}

Definition at line 69 of file mmc.\+c.
