diazmanuel/Display-PoV/Informes/Doxygen/latex/MyFreeRTOSProject_8c.tex

\hypertarget{MyFreeRTOSProject_8c}{}\section{src/\+My\+Free\+R\+T\+O\+S\+Project.c File Reference}
\label{MyFreeRTOSProject_8c}\index{src/\+My\+Free\+R\+T\+O\+S\+Project.\+c@{src/\+My\+Free\+R\+T\+O\+S\+Project.\+c}}

Main del software.  

{\ttfamily \#include \char`\"{}my\+Tasks.\+h\char`\"{}}\newline
{\ttfamily \#include \char`\"{}Shifter.\+h\char`\"{}}\newline
{\ttfamily \#include \char`\"{}Hall\+Sensor.\+h\char`\"{}}\newline
\subsection*{Functions}
\begin{DoxyCompactItemize}
\item 
int \mbox{\hyperlink{MyFreeRTOSProject_8c_a840291bc02cba5474a4cb46a9b9566fe}{main}} (void)
\begin{DoxyCompactList}\small\item\em Funcion principal. \end{DoxyCompactList}\end{DoxyCompactItemize}

\subsection{Detailed Description}
Main del software. 

El codigo fuente, asi como el resto del proyecto, se encuentra disponible en su totalidad, libre y gratuito en\+:

\href{https://github.com/CastroGerman/TD2-Project/}{\tt https\+://github.\+com/\+Castro\+German/\+T\+D2-\/\+Project/}

Cualquier consulta, correccion y/o aporte al codigo y al proyecto es bienvenida por mail a\+: \href{mailto:gcastro@est.frba.utn.edu.ar}{\tt gcastro@est.\+frba.\+utn.\+edu.\+ar}

Atentamente\+: Castro Germán.

\begin{DoxyAuthor}{Author}
Castro Germán 
\end{DoxyAuthor}
\begin{DoxyDate}{Date}
07-\/\+Dic-\/2018 
\end{DoxyDate}

\subsection{Function Documentation}
\mbox{\Hypertarget{MyFreeRTOSProject_8c_a840291bc02cba5474a4cb46a9b9566fe}\label{MyFreeRTOSProject_8c_a840291bc02cba5474a4cb46a9b9566fe}} 
\index{My\+Free\+R\+T\+O\+S\+Project.\+c@{My\+Free\+R\+T\+O\+S\+Project.\+c}!main@{main}}
\index{main@{main}!My\+Free\+R\+T\+O\+S\+Project.\+c@{My\+Free\+R\+T\+O\+S\+Project.\+c}}
\subsubsection{\texorpdfstring{main()}{main()}}
{\footnotesize\ttfamily int main (\begin{DoxyParamCaption}\item[{void}]{ }\end{DoxyParamCaption})}

Funcion principal. 

Definition at line 62 of file My\+Free\+R\+T\+O\+S\+Project.\+c.

References Crear\+Semaforos(), Crear\+Tareas(), and v\+Task\+Start\+Scheduler().
