diazmanuel/Display-PoV/Informes/Doxygen/latex/Oscilador_8c.tex

\hypertarget{Oscilador_8c}{}\section{Drivers/\+Oscilador.c File Reference}
\label{Oscilador_8c}\index{Drivers/\+Oscilador.\+c@{Drivers/\+Oscilador.\+c}}

Inicializacion de P\+LL.  

{\ttfamily \#include \char`\"{}Oscilador.\+h\char`\"{}}\newline
{\ttfamily \#include \char`\"{}Regs\+L\+P\+C1769.\+h\char`\"{}}\newline
\subsection*{Functions}
\begin{DoxyCompactItemize}
\item 
void \mbox{\hyperlink{Oscilador_8c_abb83a221491226aea83a2ee0ce1ad097}{Init\+P\+LL}} (void)
\end{DoxyCompactItemize}

\subsection{Detailed Description}
Inicializacion de P\+LL. 

\subsection{Function Documentation}
\mbox{\Hypertarget{Oscilador_8c_abb83a221491226aea83a2ee0ce1ad097}\label{Oscilador_8c_abb83a221491226aea83a2ee0ce1ad097}} 
\index{Oscilador.\+c@{Oscilador.\+c}!Init\+P\+LL@{Init\+P\+LL}}
\index{Init\+P\+LL@{Init\+P\+LL}!Oscilador.\+c@{Oscilador.\+c}}
\subsubsection{\texorpdfstring{Init\+P\+L\+L()}{InitPLL()}}
{\footnotesize\ttfamily void Init\+P\+LL (\begin{DoxyParamCaption}\item[{void}]{ }\end{DoxyParamCaption})}

Definition at line 19 of file Oscilador.\+c.

References C\+C\+L\+K\+C\+FG, C\+C\+L\+K\+C\+F\+G\+\_\+\+Value, C\+L\+K\+O\+U\+T\+C\+FG, C\+L\+K\+O\+U\+T\+C\+F\+G\+\_\+\+Value, C\+L\+K\+S\+R\+C\+S\+EL, C\+L\+K\+S\+R\+C\+S\+E\+L\+\_\+\+Value, F\+L\+A\+S\+H\+C\+FG, F\+L\+A\+S\+H\+C\+F\+G\+\_\+\+Value, M\+Y\+P\+C\+O\+NP, P\+C\+L\+K\+S\+E\+L0, P\+C\+L\+K\+S\+E\+L0\+\_\+\+Value, P\+C\+L\+K\+S\+E\+L1, P\+C\+L\+K\+S\+E\+L1\+\_\+\+Value, P\+C\+O\+N\+P\+\_\+\+Value, P\+L\+L0\+C\+FG, P\+L\+L0\+C\+F\+G\+\_\+\+Value, P\+L\+L0\+C\+ON, P\+L\+L0\+F\+E\+ED, P\+L\+L0\+S\+T\+AT, P\+L\+L1\+C\+FG, P\+L\+L1\+C\+F\+G\+\_\+\+Value, P\+L\+L1\+C\+ON, P\+L\+L1\+F\+E\+ED, P\+L\+L1\+S\+T\+AT, S\+CS, and S\+C\+S\+\_\+\+Value.

Referenced by Inicializar().
