diazmanuel/Display-PoV/Informes/Doxygen/latex/SD_8c.tex

\hypertarget{SD_8c}{}\section{Drivers/\+SD.c File Reference}
\label{SD_8c}\index{Drivers/\+S\+D.\+c@{Drivers/\+S\+D.\+c}}

Funcionalidades de la tarjeta SD.  

{\ttfamily \#include \char`\"{}Display.\+h\char`\"{}}\newline
{\ttfamily \#include \char`\"{}S\+D.\+h\char`\"{}}\newline
{\ttfamily \#include \char`\"{}ff.\+h\char`\"{}}\newline
{\ttfamily \#include \char`\"{}integer.\+h\char`\"{}}\newline
\subsection*{Functions}
\begin{DoxyCompactItemize}
\item 
void \mbox{\hyperlink{SD_8c_a64e018aeb8a642f834123495bdd1d590}{S\+D\+\_\+\+Read}} ()
\begin{DoxyCompactList}\small\item\em Carga la mariz de la imagen desde un archivo.\+txt. \end{DoxyCompactList}\end{DoxyCompactItemize}

\subsection{Detailed Description}
Funcionalidades de la tarjeta SD. 

El codigo fuente, asi como el resto del proyecto, se encuentra disponible en su totalidad, libre y gratuito en\+:

\href{https://github.com/CastroGerman/TD2-Project/}{\tt https\+://github.\+com/\+Castro\+German/\+T\+D2-\/\+Project/}

Cualquier consulta, correccion y/o aporte al codigo y al proyecto es bienvenida por mail a\+: \href{mailto:gcastro@est.frba.utn.edu.ar}{\tt gcastro@est.\+frba.\+utn.\+edu.\+ar}

Atentamente\+: Castro Germán.

\begin{DoxyAuthor}{Author}
Castro Germán 
\end{DoxyAuthor}
\begin{DoxyDate}{Date}
07-\/\+Dic-\/2018 
\end{DoxyDate}

\subsection{Function Documentation}
\mbox{\Hypertarget{SD_8c_a64e018aeb8a642f834123495bdd1d590}\label{SD_8c_a64e018aeb8a642f834123495bdd1d590}} 
\index{S\+D.\+c@{S\+D.\+c}!S\+D\+\_\+\+Read@{S\+D\+\_\+\+Read}}
\index{S\+D\+\_\+\+Read@{S\+D\+\_\+\+Read}!S\+D.\+c@{S\+D.\+c}}
\subsubsection{\texorpdfstring{S\+D\+\_\+\+Read()}{SD\_Read()}}
{\footnotesize\ttfamily void S\+D\+\_\+\+Read (\begin{DoxyParamCaption}{ }\end{DoxyParamCaption})}

Carga la mariz de la imagen desde un archivo.\+txt. 

El archivo debe contener en texto plano la informacion de la matriz imagen lista para ser leida y copiada al buffer en R\+AM. 

Definition at line 30 of file S\+D.\+c.

References f\+\_\+mount().

Referenced by Serial\+Manager(), and t\+Init().
