diazmanuel/Display-PoV/Informes/Doxygen/latex/sysinit_8c.tex

\hypertarget{sysinit_8c}{}\section{src/sysinit.c File Reference}
\label{sysinit_8c}\index{src/sysinit.\+c@{src/sysinit.\+c}}
{\ttfamily \#include \char`\"{}board.\+h\char`\"{}}\newline
\subsection*{Functions}
\begin{DoxyCompactItemize}
\item 
void \mbox{\hyperlink{sysinit_8c_a93f514700ccf00d08dbdcff7f1224eb2}{System\+Init}} (void)
\end{DoxyCompactItemize}

\subsection{Function Documentation}
\mbox{\Hypertarget{sysinit_8c_a93f514700ccf00d08dbdcff7f1224eb2}\label{sysinit_8c_a93f514700ccf00d08dbdcff7f1224eb2}} 
\index{sysinit.\+c@{sysinit.\+c}!System\+Init@{System\+Init}}
\index{System\+Init@{System\+Init}!sysinit.\+c@{sysinit.\+c}}
\subsubsection{\texorpdfstring{System\+Init()}{SystemInit()}}
{\footnotesize\ttfamily void System\+Init (\begin{DoxyParamCaption}\item[{void}]{ }\end{DoxyParamCaption})}

Definition at line 51 of file sysinit.\+c.
