diazmanuel/Display-PoV/Informes/Doxygen/latex/portmacro_8h.tex

\hypertarget{portmacro_8h}{}\section{freertos/inc/portmacro.h File Reference}
\label{portmacro_8h}\index{freertos/inc/portmacro.\+h@{freertos/inc/portmacro.\+h}}
\subsection*{Macros}
\begin{DoxyCompactItemize}
\item 
\#define \hyperlink{portmacro_8h_add0bdbfef5abf241c7774f68bde42f1d}{port\+C\+H\+AR}~char
\item 
\#define \hyperlink{portmacro_8h_a1bbe1ef117ec274ef919e0a930c888ac}{port\+F\+L\+O\+AT}~float
\item 
\#define \hyperlink{portmacro_8h_a4711ce186a903a14bc8ea7c8650b4f61}{port\+D\+O\+U\+B\+LE}~double
\item 
\#define \hyperlink{portmacro_8h_a6bbebff6020ac333ab6ec2ffd7f77001}{port\+L\+O\+NG}~long
\item 
\#define \hyperlink{portmacro_8h_a42e62d5881b12ff2a5c659576c64d003}{port\+S\+H\+O\+RT}~short
\item 
\#define \hyperlink{portmacro_8h_ab0a294066ac7369b8f59a52d9491a92c}{port\+S\+T\+A\+C\+K\+\_\+\+T\+Y\+PE}~unsigned \hyperlink{portmacro_8h_a6bbebff6020ac333ab6ec2ffd7f77001}{port\+L\+O\+NG}
\item 
\#define \hyperlink{portmacro_8h_a1ebe82d24d764ae4e352f7c3a9f92c01}{port\+B\+A\+S\+E\+\_\+\+T\+Y\+PE}~long
\item 
\#define \hyperlink{portmacro_8h_a72723ba1e4a85ca14f25c2b9e066613d}{port\+M\+A\+X\+\_\+\+D\+E\+L\+AY}~( \hyperlink{portmacro_8h_a4d746b2ff8fafc490b764c66411ec457}{port\+Tick\+Type} ) 0xffffffff
\item 
\#define \hyperlink{portmacro_8h_a21adaab1601f6a0f35ba550a43060830}{port\+S\+T\+A\+C\+K\+\_\+\+G\+R\+O\+W\+TH}~( -\/1 )
\item 
\#define \hyperlink{portmacro_8h_a8689cad2afb0c5f65d866e2c356378bf}{port\+T\+I\+C\+K\+\_\+\+R\+A\+T\+E\+\_\+\+MS}~( ( \hyperlink{portmacro_8h_a4d746b2ff8fafc490b764c66411ec457}{port\+Tick\+Type} ) 1000 / \hyperlink{FreeRTOSConfig_8h_a2f0258dd1e3b877e5bc013be54c2db6a}{config\+T\+I\+C\+K\+\_\+\+R\+A\+T\+E\+\_\+\+HZ} )
\item 
\#define \hyperlink{portmacro_8h_ab9091ce3940d8bd93ec850122a2c6a1c}{port\+B\+Y\+T\+E\+\_\+\+A\+L\+I\+G\+N\+M\+E\+NT}~8
\item 
\#define \hyperlink{portmacro_8h_ae42817ecbd6fe76d846a89cc0fcd0d95}{port\+N\+V\+I\+C\+\_\+\+I\+N\+T\+\_\+\+C\+T\+R\+L\+\_\+\+R\+EG}~( $\ast$ ( ( volatile unsigned long $\ast$ ) 0xe000ed04 ) )
\item 
\#define \hyperlink{portmacro_8h_a16830bf8349e14cdeed05193af234d5e}{port\+N\+V\+I\+C\+\_\+\+P\+E\+N\+D\+S\+V\+S\+E\+T\+\_\+\+B\+IT}~( 1\+U\+L $<$$<$ 28\+U\+L )
\item 
\#define \hyperlink{portmacro_8h_ae1ff06193615f5130b5a97dc9e708fc7}{port\+Y\+I\+E\+LD}()~\hyperlink{port_8c_add01c927fb689f7ec170e42d47d27927}{v\+Port\+Yield}()
\item 
\#define \hyperlink{portmacro_8h_a63b994040c62c9685490a71c87a13d8a}{port\+E\+N\+D\+\_\+\+S\+W\+I\+T\+C\+H\+I\+N\+G\+\_\+\+I\+SR}(x\+Switch\+Required)~if( x\+Switch\+Required ) \hyperlink{portmacro_8h_ae42817ecbd6fe76d846a89cc0fcd0d95}{port\+N\+V\+I\+C\+\_\+\+I\+N\+T\+\_\+\+C\+T\+R\+L\+\_\+\+R\+EG} = \hyperlink{portmacro_8h_a16830bf8349e14cdeed05193af234d5e}{port\+N\+V\+I\+C\+\_\+\+P\+E\+N\+D\+S\+V\+S\+E\+T\+\_\+\+B\+IT}
\item 
\#define \hyperlink{portmacro_8h_aac6850c66595efdc02a8bbb95fb4648e}{port\+Y\+I\+E\+L\+D\+\_\+\+F\+R\+O\+M\+\_\+\+I\+SR}(x)~\hyperlink{portmacro_8h_a63b994040c62c9685490a71c87a13d8a}{port\+E\+N\+D\+\_\+\+S\+W\+I\+T\+C\+H\+I\+N\+G\+\_\+\+I\+SR}( x )
\item 
\#define \hyperlink{portmacro_8h_a31b4260dbc1823ba80b578f86eb15a98}{port\+S\+E\+T\+\_\+\+I\+N\+T\+E\+R\+R\+U\+P\+T\+\_\+\+M\+A\+S\+K\+\_\+\+F\+R\+O\+M\+\_\+\+I\+SR}()~\hyperlink{portmacro_8h_a00617dbc97b67d0f27064b65c8db0279}{ul\+Port\+Set\+Interrupt\+Mask}()
\item 
\#define \hyperlink{portmacro_8h_a79d65a5d0f6f9133a0739832e9d8367e}{port\+C\+L\+E\+A\+R\+\_\+\+I\+N\+T\+E\+R\+R\+U\+P\+T\+\_\+\+M\+A\+S\+K\+\_\+\+F\+R\+O\+M\+\_\+\+I\+SR}(x)~\hyperlink{portmacro_8h_a181162673e726b3f0512ff311cffb38c}{v\+Port\+Clear\+Interrupt\+Mask}(x)
\item 
\#define \hyperlink{portmacro_8h_a6e3d10ee1a0734a647ca192523c2cfc1}{port\+D\+I\+S\+A\+B\+L\+E\+\_\+\+I\+N\+T\+E\+R\+R\+U\+P\+TS}()~\hyperlink{portmacro_8h_a00617dbc97b67d0f27064b65c8db0279}{ul\+Port\+Set\+Interrupt\+Mask}()
\item 
\#define \hyperlink{portmacro_8h_abc47e85a6befbb47961ad5ee7aa57173}{port\+E\+N\+A\+B\+L\+E\+\_\+\+I\+N\+T\+E\+R\+R\+U\+P\+TS}()~\hyperlink{portmacro_8h_a181162673e726b3f0512ff311cffb38c}{v\+Port\+Clear\+Interrupt\+Mask}(0)
\item 
\#define \hyperlink{portmacro_8h_a8a09321ad004019f3c8d0f2e4d7224c7}{port\+E\+N\+T\+E\+R\+\_\+\+C\+R\+I\+T\+I\+C\+AL}()~\hyperlink{port_8c_a2ed3554a3de09a3bd09d396ee081ab69}{v\+Port\+Enter\+Critical}()
\item 
\#define \hyperlink{portmacro_8h_a529358e6147881dd881c890ade21c9bd}{port\+E\+X\+I\+T\+\_\+\+C\+R\+I\+T\+I\+C\+AL}()~\hyperlink{port_8c_aed20ada05b957181a0de042802a82a5b}{v\+Port\+Exit\+Critical}()
\item 
\#define \hyperlink{portmacro_8h_a2921e1c5a1f974dfa01ae44d1f665f14}{port\+T\+A\+S\+K\+\_\+\+F\+U\+N\+C\+T\+I\+O\+N\+\_\+\+P\+R\+O\+TO}(v\+Function,  pv\+Parameters)~void v\+Function( void $\ast$pv\+Parameters )
\item 
\#define \hyperlink{portmacro_8h_a3a289793652f505c538abea27045ccdf}{port\+T\+A\+S\+K\+\_\+\+F\+U\+N\+C\+T\+I\+ON}(v\+Function,  pv\+Parameters)~void v\+Function( void $\ast$pv\+Parameters )
\item 
\#define \hyperlink{portmacro_8h_a1dcf4bd9c1ad4fe16a71391dd95cf585}{port\+S\+U\+P\+P\+R\+E\+S\+S\+\_\+\+T\+I\+C\+K\+S\+\_\+\+A\+N\+D\+\_\+\+S\+L\+E\+EP}(x\+Expected\+Idle\+Time)~\hyperlink{portmacro_8h_acdb8d638456fdeeb9d21cb8f3fc74efe}{v\+Port\+Suppress\+Ticks\+And\+Sleep}( x\+Expected\+Idle\+Time )
\item 
\#define \hyperlink{portmacro_8h_a23c54dff0b50ff35563ef06c6d6d1835}{port\+N\+OP}()
\end{DoxyCompactItemize}
\subsection*{Typedefs}
\begin{DoxyCompactItemize}
\item 
typedef unsigned \hyperlink{portmacro_8h_a6bbebff6020ac333ab6ec2ffd7f77001}{port\+L\+O\+NG} \hyperlink{portmacro_8h_a4d746b2ff8fafc490b764c66411ec457}{port\+Tick\+Type}
\end{DoxyCompactItemize}
\subsection*{Functions}
\begin{DoxyCompactItemize}
\item 
void \hyperlink{portmacro_8h_add01c927fb689f7ec170e42d47d27927}{v\+Port\+Yield} (void)
\item 
void \hyperlink{portmacro_8h_a2ed3554a3de09a3bd09d396ee081ab69}{v\+Port\+Enter\+Critical} (void)
\item 
void \hyperlink{portmacro_8h_aed20ada05b957181a0de042802a82a5b}{v\+Port\+Exit\+Critical} (void)
\item 
unsigned long \hyperlink{portmacro_8h_a00617dbc97b67d0f27064b65c8db0279}{ul\+Port\+Set\+Interrupt\+Mask} (void)
\item 
void \hyperlink{portmacro_8h_a181162673e726b3f0512ff311cffb38c}{v\+Port\+Clear\+Interrupt\+Mask} (unsigned long ul\+New\+Mask\+Value)
\item 
void \hyperlink{portmacro_8h_acdb8d638456fdeeb9d21cb8f3fc74efe}{v\+Port\+Suppress\+Ticks\+And\+Sleep} (\hyperlink{portmacro_8h_a4d746b2ff8fafc490b764c66411ec457}{port\+Tick\+Type} x\+Expected\+Idle\+Time)
\end{DoxyCompactItemize}

\subsection{Macro Definition Documentation}
\mbox{\Hypertarget{portmacro_8h_a1ebe82d24d764ae4e352f7c3a9f92c01}\label{portmacro_8h_a1ebe82d24d764ae4e352f7c3a9f92c01}} 
\index{portmacro.\+h@{portmacro.\+h}!port\+B\+A\+S\+E\+\_\+\+T\+Y\+PE@{port\+B\+A\+S\+E\+\_\+\+T\+Y\+PE}}
\index{port\+B\+A\+S\+E\+\_\+\+T\+Y\+PE@{port\+B\+A\+S\+E\+\_\+\+T\+Y\+PE}!portmacro.\+h@{portmacro.\+h}}
\subsubsection{\texorpdfstring{port\+B\+A\+S\+E\+\_\+\+T\+Y\+PE}{portBASE\_TYPE}}
{\footnotesize\ttfamily \#define port\+B\+A\+S\+E\+\_\+\+T\+Y\+PE~long}

Definition at line 91 of file portmacro.\+h.

Referenced by E\+I\+N\+T1\+\_\+\+I\+R\+Q\+Handler(), prv\+Allocate\+T\+C\+B\+And\+Stack(), prv\+Copy\+Data\+To\+Queue(), prv\+Initialise\+Task\+Lists(), prv\+Initialise\+T\+C\+B\+Variables(), prv\+Is\+Queue\+Empty(), prv\+Is\+Queue\+Full(), T\+I\+M\+E\+R1\+\_\+\+I\+R\+Q\+Handler(), ux\+Queue\+Messages\+Waiting(), ux\+Queue\+Messages\+Waiting\+From\+I\+S\+R(), ux\+Queue\+Spaces\+Available(), v\+Application\+Tick\+Hook(), v\+List\+Initialise(), x\+Queue\+Generic\+Create(), x\+Queue\+Generic\+Receive(), x\+Queue\+Generic\+Reset(), x\+Queue\+Generic\+Send(), x\+Queue\+Generic\+Send\+From\+I\+S\+R(), x\+Queue\+Is\+Queue\+Empty\+From\+I\+S\+R(), x\+Queue\+Is\+Queue\+Full\+From\+I\+S\+R(), x\+Queue\+Peek\+From\+I\+S\+R(), and x\+Queue\+Receive\+From\+I\+S\+R().

\mbox{\Hypertarget{portmacro_8h_ab9091ce3940d8bd93ec850122a2c6a1c}\label{portmacro_8h_ab9091ce3940d8bd93ec850122a2c6a1c}} 
\index{portmacro.\+h@{portmacro.\+h}!port\+B\+Y\+T\+E\+\_\+\+A\+L\+I\+G\+N\+M\+E\+NT@{port\+B\+Y\+T\+E\+\_\+\+A\+L\+I\+G\+N\+M\+E\+NT}}
\index{port\+B\+Y\+T\+E\+\_\+\+A\+L\+I\+G\+N\+M\+E\+NT@{port\+B\+Y\+T\+E\+\_\+\+A\+L\+I\+G\+N\+M\+E\+NT}!portmacro.\+h@{portmacro.\+h}}
\subsubsection{\texorpdfstring{port\+B\+Y\+T\+E\+\_\+\+A\+L\+I\+G\+N\+M\+E\+NT}{portBYTE\_ALIGNMENT}}
{\footnotesize\ttfamily \#define port\+B\+Y\+T\+E\+\_\+\+A\+L\+I\+G\+N\+M\+E\+NT~8}

Definition at line 105 of file portmacro.\+h.

\mbox{\Hypertarget{portmacro_8h_add0bdbfef5abf241c7774f68bde42f1d}\label{portmacro_8h_add0bdbfef5abf241c7774f68bde42f1d}} 
\index{portmacro.\+h@{portmacro.\+h}!port\+C\+H\+AR@{port\+C\+H\+AR}}
\index{port\+C\+H\+AR@{port\+C\+H\+AR}!portmacro.\+h@{portmacro.\+h}}
\subsubsection{\texorpdfstring{port\+C\+H\+AR}{portCHAR}}
{\footnotesize\ttfamily \#define port\+C\+H\+AR~char}

Definition at line 85 of file portmacro.\+h.

\mbox{\Hypertarget{portmacro_8h_a79d65a5d0f6f9133a0739832e9d8367e}\label{portmacro_8h_a79d65a5d0f6f9133a0739832e9d8367e}} 
\index{portmacro.\+h@{portmacro.\+h}!port\+C\+L\+E\+A\+R\+\_\+\+I\+N\+T\+E\+R\+R\+U\+P\+T\+\_\+\+M\+A\+S\+K\+\_\+\+F\+R\+O\+M\+\_\+\+I\+SR@{port\+C\+L\+E\+A\+R\+\_\+\+I\+N\+T\+E\+R\+R\+U\+P\+T\+\_\+\+M\+A\+S\+K\+\_\+\+F\+R\+O\+M\+\_\+\+I\+SR}}
\index{port\+C\+L\+E\+A\+R\+\_\+\+I\+N\+T\+E\+R\+R\+U\+P\+T\+\_\+\+M\+A\+S\+K\+\_\+\+F\+R\+O\+M\+\_\+\+I\+SR@{port\+C\+L\+E\+A\+R\+\_\+\+I\+N\+T\+E\+R\+R\+U\+P\+T\+\_\+\+M\+A\+S\+K\+\_\+\+F\+R\+O\+M\+\_\+\+I\+SR}!portmacro.\+h@{portmacro.\+h}}
\subsubsection{\texorpdfstring{port\+C\+L\+E\+A\+R\+\_\+\+I\+N\+T\+E\+R\+R\+U\+P\+T\+\_\+\+M\+A\+S\+K\+\_\+\+F\+R\+O\+M\+\_\+\+I\+SR}{portCLEAR\_INTERRUPT\_MASK\_FROM\_ISR}}
{\footnotesize\ttfamily \#define port\+C\+L\+E\+A\+R\+\_\+\+I\+N\+T\+E\+R\+R\+U\+P\+T\+\_\+\+M\+A\+S\+K\+\_\+\+F\+R\+O\+M\+\_\+\+I\+SR(\begin{DoxyParamCaption}\item[{}]{x }\end{DoxyParamCaption})~\hyperlink{portmacro_8h_a181162673e726b3f0512ff311cffb38c}{v\+Port\+Clear\+Interrupt\+Mask}(x)}

Definition at line 124 of file portmacro.\+h.

Referenced by x\+Port\+Sys\+Tick\+Handler(), x\+Queue\+Generic\+Send\+From\+I\+S\+R(), x\+Queue\+Peek\+From\+I\+S\+R(), x\+Queue\+Receive\+From\+I\+S\+R(), and x\+Task\+Get\+Tick\+Count\+From\+I\+S\+R().

\mbox{\Hypertarget{portmacro_8h_a6e3d10ee1a0734a647ca192523c2cfc1}\label{portmacro_8h_a6e3d10ee1a0734a647ca192523c2cfc1}} 
\index{portmacro.\+h@{portmacro.\+h}!port\+D\+I\+S\+A\+B\+L\+E\+\_\+\+I\+N\+T\+E\+R\+R\+U\+P\+TS@{port\+D\+I\+S\+A\+B\+L\+E\+\_\+\+I\+N\+T\+E\+R\+R\+U\+P\+TS}}
\index{port\+D\+I\+S\+A\+B\+L\+E\+\_\+\+I\+N\+T\+E\+R\+R\+U\+P\+TS@{port\+D\+I\+S\+A\+B\+L\+E\+\_\+\+I\+N\+T\+E\+R\+R\+U\+P\+TS}!portmacro.\+h@{portmacro.\+h}}
\subsubsection{\texorpdfstring{port\+D\+I\+S\+A\+B\+L\+E\+\_\+\+I\+N\+T\+E\+R\+R\+U\+P\+TS}{portDISABLE\_INTERRUPTS}}
{\footnotesize\ttfamily \#define port\+D\+I\+S\+A\+B\+L\+E\+\_\+\+I\+N\+T\+E\+R\+R\+U\+P\+TS(\begin{DoxyParamCaption}{ }\end{DoxyParamCaption})~\hyperlink{portmacro_8h_a00617dbc97b67d0f27064b65c8db0279}{ul\+Port\+Set\+Interrupt\+Mask}()}

Definition at line 125 of file portmacro.\+h.

Referenced by prv\+Allocate\+T\+C\+B\+And\+Stack(), prv\+Task\+Exit\+Error(), v\+Port\+Enter\+Critical(), v\+Task\+End\+Scheduler(), v\+Task\+Start\+Scheduler(), and x\+Queue\+Is\+Queue\+Full\+From\+I\+S\+R().

\mbox{\Hypertarget{portmacro_8h_a4711ce186a903a14bc8ea7c8650b4f61}\label{portmacro_8h_a4711ce186a903a14bc8ea7c8650b4f61}} 
\index{portmacro.\+h@{portmacro.\+h}!port\+D\+O\+U\+B\+LE@{port\+D\+O\+U\+B\+LE}}
\index{port\+D\+O\+U\+B\+LE@{port\+D\+O\+U\+B\+LE}!portmacro.\+h@{portmacro.\+h}}
\subsubsection{\texorpdfstring{port\+D\+O\+U\+B\+LE}{portDOUBLE}}
{\footnotesize\ttfamily \#define port\+D\+O\+U\+B\+LE~double}

Definition at line 87 of file portmacro.\+h.

\mbox{\Hypertarget{portmacro_8h_abc47e85a6befbb47961ad5ee7aa57173}\label{portmacro_8h_abc47e85a6befbb47961ad5ee7aa57173}} 
\index{portmacro.\+h@{portmacro.\+h}!port\+E\+N\+A\+B\+L\+E\+\_\+\+I\+N\+T\+E\+R\+R\+U\+P\+TS@{port\+E\+N\+A\+B\+L\+E\+\_\+\+I\+N\+T\+E\+R\+R\+U\+P\+TS}}
\index{port\+E\+N\+A\+B\+L\+E\+\_\+\+I\+N\+T\+E\+R\+R\+U\+P\+TS@{port\+E\+N\+A\+B\+L\+E\+\_\+\+I\+N\+T\+E\+R\+R\+U\+P\+TS}!portmacro.\+h@{portmacro.\+h}}
\subsubsection{\texorpdfstring{port\+E\+N\+A\+B\+L\+E\+\_\+\+I\+N\+T\+E\+R\+R\+U\+P\+TS}{portENABLE\_INTERRUPTS}}
{\footnotesize\ttfamily \#define port\+E\+N\+A\+B\+L\+E\+\_\+\+I\+N\+T\+E\+R\+R\+U\+P\+TS(\begin{DoxyParamCaption}{ }\end{DoxyParamCaption})~\hyperlink{portmacro_8h_a181162673e726b3f0512ff311cffb38c}{v\+Port\+Clear\+Interrupt\+Mask}(0)}

Definition at line 126 of file portmacro.\+h.

Referenced by prv\+Allocate\+T\+C\+B\+And\+Stack(), v\+Port\+Exit\+Critical(), and x\+Queue\+Is\+Queue\+Full\+From\+I\+S\+R().

\mbox{\Hypertarget{portmacro_8h_a63b994040c62c9685490a71c87a13d8a}\label{portmacro_8h_a63b994040c62c9685490a71c87a13d8a}} 
\index{portmacro.\+h@{portmacro.\+h}!port\+E\+N\+D\+\_\+\+S\+W\+I\+T\+C\+H\+I\+N\+G\+\_\+\+I\+SR@{port\+E\+N\+D\+\_\+\+S\+W\+I\+T\+C\+H\+I\+N\+G\+\_\+\+I\+SR}}
\index{port\+E\+N\+D\+\_\+\+S\+W\+I\+T\+C\+H\+I\+N\+G\+\_\+\+I\+SR@{port\+E\+N\+D\+\_\+\+S\+W\+I\+T\+C\+H\+I\+N\+G\+\_\+\+I\+SR}!portmacro.\+h@{portmacro.\+h}}
\subsubsection{\texorpdfstring{port\+E\+N\+D\+\_\+\+S\+W\+I\+T\+C\+H\+I\+N\+G\+\_\+\+I\+SR}{portEND\_SWITCHING\_ISR}}
{\footnotesize\ttfamily \#define port\+E\+N\+D\+\_\+\+S\+W\+I\+T\+C\+H\+I\+N\+G\+\_\+\+I\+SR(\begin{DoxyParamCaption}\item[{}]{x\+Switch\+Required }\end{DoxyParamCaption})~if( x\+Switch\+Required ) \hyperlink{portmacro_8h_ae42817ecbd6fe76d846a89cc0fcd0d95}{port\+N\+V\+I\+C\+\_\+\+I\+N\+T\+\_\+\+C\+T\+R\+L\+\_\+\+R\+EG} = \hyperlink{portmacro_8h_a16830bf8349e14cdeed05193af234d5e}{port\+N\+V\+I\+C\+\_\+\+P\+E\+N\+D\+S\+V\+S\+E\+T\+\_\+\+B\+IT}}

Definition at line 114 of file portmacro.\+h.

Referenced by E\+I\+N\+T1\+\_\+\+I\+R\+Q\+Handler(), T\+I\+M\+E\+R1\+\_\+\+I\+R\+Q\+Handler(), and v\+Application\+Tick\+Hook().

\mbox{\Hypertarget{portmacro_8h_a8a09321ad004019f3c8d0f2e4d7224c7}\label{portmacro_8h_a8a09321ad004019f3c8d0f2e4d7224c7}} 
\index{portmacro.\+h@{portmacro.\+h}!port\+E\+N\+T\+E\+R\+\_\+\+C\+R\+I\+T\+I\+C\+AL@{port\+E\+N\+T\+E\+R\+\_\+\+C\+R\+I\+T\+I\+C\+AL}}
\index{port\+E\+N\+T\+E\+R\+\_\+\+C\+R\+I\+T\+I\+C\+AL@{port\+E\+N\+T\+E\+R\+\_\+\+C\+R\+I\+T\+I\+C\+AL}!portmacro.\+h@{portmacro.\+h}}
\subsubsection{\texorpdfstring{port\+E\+N\+T\+E\+R\+\_\+\+C\+R\+I\+T\+I\+C\+AL}{portENTER\_CRITICAL}}
{\footnotesize\ttfamily \#define port\+E\+N\+T\+E\+R\+\_\+\+C\+R\+I\+T\+I\+C\+AL(\begin{DoxyParamCaption}{ }\end{DoxyParamCaption})~\hyperlink{port_8c_a2ed3554a3de09a3bd09d396ee081ab69}{v\+Port\+Enter\+Critical}()}

Definition at line 127 of file portmacro.\+h.

Referenced by x\+Port\+Sys\+Tick\+Handler(), x\+Queue\+Generic\+Receive(), and x\+Queue\+Generic\+Send().

\mbox{\Hypertarget{portmacro_8h_a529358e6147881dd881c890ade21c9bd}\label{portmacro_8h_a529358e6147881dd881c890ade21c9bd}} 
\index{portmacro.\+h@{portmacro.\+h}!port\+E\+X\+I\+T\+\_\+\+C\+R\+I\+T\+I\+C\+AL@{port\+E\+X\+I\+T\+\_\+\+C\+R\+I\+T\+I\+C\+AL}}
\index{port\+E\+X\+I\+T\+\_\+\+C\+R\+I\+T\+I\+C\+AL@{port\+E\+X\+I\+T\+\_\+\+C\+R\+I\+T\+I\+C\+AL}!portmacro.\+h@{portmacro.\+h}}
\subsubsection{\texorpdfstring{port\+E\+X\+I\+T\+\_\+\+C\+R\+I\+T\+I\+C\+AL}{portEXIT\_CRITICAL}}
{\footnotesize\ttfamily \#define port\+E\+X\+I\+T\+\_\+\+C\+R\+I\+T\+I\+C\+AL(\begin{DoxyParamCaption}{ }\end{DoxyParamCaption})~\hyperlink{port_8c_aed20ada05b957181a0de042802a82a5b}{v\+Port\+Exit\+Critical}()}

Definition at line 128 of file portmacro.\+h.

Referenced by x\+Port\+Sys\+Tick\+Handler(), x\+Queue\+Generic\+Receive(), and x\+Queue\+Generic\+Send().

\mbox{\Hypertarget{portmacro_8h_a1bbe1ef117ec274ef919e0a930c888ac}\label{portmacro_8h_a1bbe1ef117ec274ef919e0a930c888ac}} 
\index{portmacro.\+h@{portmacro.\+h}!port\+F\+L\+O\+AT@{port\+F\+L\+O\+AT}}
\index{port\+F\+L\+O\+AT@{port\+F\+L\+O\+AT}!portmacro.\+h@{portmacro.\+h}}
\subsubsection{\texorpdfstring{port\+F\+L\+O\+AT}{portFLOAT}}
{\footnotesize\ttfamily \#define port\+F\+L\+O\+AT~float}

Definition at line 86 of file portmacro.\+h.

\mbox{\Hypertarget{portmacro_8h_a6bbebff6020ac333ab6ec2ffd7f77001}\label{portmacro_8h_a6bbebff6020ac333ab6ec2ffd7f77001}} 
\index{portmacro.\+h@{portmacro.\+h}!port\+L\+O\+NG@{port\+L\+O\+NG}}
\index{port\+L\+O\+NG@{port\+L\+O\+NG}!portmacro.\+h@{portmacro.\+h}}
\subsubsection{\texorpdfstring{port\+L\+O\+NG}{portLONG}}
{\footnotesize\ttfamily \#define port\+L\+O\+NG~long}

Definition at line 88 of file portmacro.\+h.

\mbox{\Hypertarget{portmacro_8h_a72723ba1e4a85ca14f25c2b9e066613d}\label{portmacro_8h_a72723ba1e4a85ca14f25c2b9e066613d}} 
\index{portmacro.\+h@{portmacro.\+h}!port\+M\+A\+X\+\_\+\+D\+E\+L\+AY@{port\+M\+A\+X\+\_\+\+D\+E\+L\+AY}}
\index{port\+M\+A\+X\+\_\+\+D\+E\+L\+AY@{port\+M\+A\+X\+\_\+\+D\+E\+L\+AY}!portmacro.\+h@{portmacro.\+h}}
\subsubsection{\texorpdfstring{port\+M\+A\+X\+\_\+\+D\+E\+L\+AY}{portMAX\_DELAY}}
{\footnotesize\ttfamily \#define port\+M\+A\+X\+\_\+\+D\+E\+L\+AY~( \hyperlink{portmacro_8h_a4d746b2ff8fafc490b764c66411ec457}{port\+Tick\+Type} ) 0xffffffff}

Definition at line 98 of file portmacro.\+h.

Referenced by t\+Carga\+Data(), t\+Descomprimir(), t\+Hall\+Sensor(), t\+Periodic(), t\+Refresh\+Timer\+Setup(), v\+List\+Initialise(), v\+List\+Insert(), v\+Task\+Place\+On\+Event\+List(), x\+Task\+Check\+For\+Time\+Out(), and x\+Task\+Increment\+Tick().

\mbox{\Hypertarget{portmacro_8h_a23c54dff0b50ff35563ef06c6d6d1835}\label{portmacro_8h_a23c54dff0b50ff35563ef06c6d6d1835}} 
\index{portmacro.\+h@{portmacro.\+h}!port\+N\+OP@{port\+N\+OP}}
\index{port\+N\+OP@{port\+N\+OP}!portmacro.\+h@{portmacro.\+h}}
\subsubsection{\texorpdfstring{port\+N\+OP}{portNOP}}
{\footnotesize\ttfamily \#define port\+N\+OP(\begin{DoxyParamCaption}{ }\end{DoxyParamCaption})}

Definition at line 180 of file portmacro.\+h.

\mbox{\Hypertarget{portmacro_8h_ae42817ecbd6fe76d846a89cc0fcd0d95}\label{portmacro_8h_ae42817ecbd6fe76d846a89cc0fcd0d95}} 
\index{portmacro.\+h@{portmacro.\+h}!port\+N\+V\+I\+C\+\_\+\+I\+N\+T\+\_\+\+C\+T\+R\+L\+\_\+\+R\+EG@{port\+N\+V\+I\+C\+\_\+\+I\+N\+T\+\_\+\+C\+T\+R\+L\+\_\+\+R\+EG}}
\index{port\+N\+V\+I\+C\+\_\+\+I\+N\+T\+\_\+\+C\+T\+R\+L\+\_\+\+R\+EG@{port\+N\+V\+I\+C\+\_\+\+I\+N\+T\+\_\+\+C\+T\+R\+L\+\_\+\+R\+EG}!portmacro.\+h@{portmacro.\+h}}
\subsubsection{\texorpdfstring{port\+N\+V\+I\+C\+\_\+\+I\+N\+T\+\_\+\+C\+T\+R\+L\+\_\+\+R\+EG}{portNVIC\_INT\_CTRL\_REG}}
{\footnotesize\ttfamily \#define port\+N\+V\+I\+C\+\_\+\+I\+N\+T\+\_\+\+C\+T\+R\+L\+\_\+\+R\+EG~( $\ast$ ( ( volatile unsigned long $\ast$ ) 0xe000ed04 ) )}

Definition at line 111 of file portmacro.\+h.

Referenced by v\+Port\+Yield(), and x\+Port\+Sys\+Tick\+Handler().

\mbox{\Hypertarget{portmacro_8h_a16830bf8349e14cdeed05193af234d5e}\label{portmacro_8h_a16830bf8349e14cdeed05193af234d5e}} 
\index{portmacro.\+h@{portmacro.\+h}!port\+N\+V\+I\+C\+\_\+\+P\+E\+N\+D\+S\+V\+S\+E\+T\+\_\+\+B\+IT@{port\+N\+V\+I\+C\+\_\+\+P\+E\+N\+D\+S\+V\+S\+E\+T\+\_\+\+B\+IT}}
\index{port\+N\+V\+I\+C\+\_\+\+P\+E\+N\+D\+S\+V\+S\+E\+T\+\_\+\+B\+IT@{port\+N\+V\+I\+C\+\_\+\+P\+E\+N\+D\+S\+V\+S\+E\+T\+\_\+\+B\+IT}!portmacro.\+h@{portmacro.\+h}}
\subsubsection{\texorpdfstring{port\+N\+V\+I\+C\+\_\+\+P\+E\+N\+D\+S\+V\+S\+E\+T\+\_\+\+B\+IT}{portNVIC\_PENDSVSET\_BIT}}
{\footnotesize\ttfamily \#define port\+N\+V\+I\+C\+\_\+\+P\+E\+N\+D\+S\+V\+S\+E\+T\+\_\+\+B\+IT~( 1\+U\+L $<$$<$ 28\+U\+L )}

Definition at line 112 of file portmacro.\+h.

Referenced by v\+Port\+Yield(), and x\+Port\+Sys\+Tick\+Handler().

\mbox{\Hypertarget{portmacro_8h_a31b4260dbc1823ba80b578f86eb15a98}\label{portmacro_8h_a31b4260dbc1823ba80b578f86eb15a98}} 
\index{portmacro.\+h@{portmacro.\+h}!port\+S\+E\+T\+\_\+\+I\+N\+T\+E\+R\+R\+U\+P\+T\+\_\+\+M\+A\+S\+K\+\_\+\+F\+R\+O\+M\+\_\+\+I\+SR@{port\+S\+E\+T\+\_\+\+I\+N\+T\+E\+R\+R\+U\+P\+T\+\_\+\+M\+A\+S\+K\+\_\+\+F\+R\+O\+M\+\_\+\+I\+SR}}
\index{port\+S\+E\+T\+\_\+\+I\+N\+T\+E\+R\+R\+U\+P\+T\+\_\+\+M\+A\+S\+K\+\_\+\+F\+R\+O\+M\+\_\+\+I\+SR@{port\+S\+E\+T\+\_\+\+I\+N\+T\+E\+R\+R\+U\+P\+T\+\_\+\+M\+A\+S\+K\+\_\+\+F\+R\+O\+M\+\_\+\+I\+SR}!portmacro.\+h@{portmacro.\+h}}
\subsubsection{\texorpdfstring{port\+S\+E\+T\+\_\+\+I\+N\+T\+E\+R\+R\+U\+P\+T\+\_\+\+M\+A\+S\+K\+\_\+\+F\+R\+O\+M\+\_\+\+I\+SR}{portSET\_INTERRUPT\_MASK\_FROM\_ISR}}
{\footnotesize\ttfamily \#define port\+S\+E\+T\+\_\+\+I\+N\+T\+E\+R\+R\+U\+P\+T\+\_\+\+M\+A\+S\+K\+\_\+\+F\+R\+O\+M\+\_\+\+I\+SR(\begin{DoxyParamCaption}{ }\end{DoxyParamCaption})~\hyperlink{portmacro_8h_a00617dbc97b67d0f27064b65c8db0279}{ul\+Port\+Set\+Interrupt\+Mask}()}

Definition at line 123 of file portmacro.\+h.

Referenced by x\+Port\+Sys\+Tick\+Handler(), x\+Queue\+Generic\+Send\+From\+I\+S\+R(), x\+Queue\+Peek\+From\+I\+S\+R(), x\+Queue\+Receive\+From\+I\+S\+R(), and x\+Task\+Get\+Tick\+Count\+From\+I\+S\+R().

\mbox{\Hypertarget{portmacro_8h_a42e62d5881b12ff2a5c659576c64d003}\label{portmacro_8h_a42e62d5881b12ff2a5c659576c64d003}} 
\index{portmacro.\+h@{portmacro.\+h}!port\+S\+H\+O\+RT@{port\+S\+H\+O\+RT}}
\index{port\+S\+H\+O\+RT@{port\+S\+H\+O\+RT}!portmacro.\+h@{portmacro.\+h}}
\subsubsection{\texorpdfstring{port\+S\+H\+O\+RT}{portSHORT}}
{\footnotesize\ttfamily \#define port\+S\+H\+O\+RT~short}

Definition at line 89 of file portmacro.\+h.

\mbox{\Hypertarget{portmacro_8h_a21adaab1601f6a0f35ba550a43060830}\label{portmacro_8h_a21adaab1601f6a0f35ba550a43060830}} 
\index{portmacro.\+h@{portmacro.\+h}!port\+S\+T\+A\+C\+K\+\_\+\+G\+R\+O\+W\+TH@{port\+S\+T\+A\+C\+K\+\_\+\+G\+R\+O\+W\+TH}}
\index{port\+S\+T\+A\+C\+K\+\_\+\+G\+R\+O\+W\+TH@{port\+S\+T\+A\+C\+K\+\_\+\+G\+R\+O\+W\+TH}!portmacro.\+h@{portmacro.\+h}}
\subsubsection{\texorpdfstring{port\+S\+T\+A\+C\+K\+\_\+\+G\+R\+O\+W\+TH}{portSTACK\_GROWTH}}
{\footnotesize\ttfamily \#define port\+S\+T\+A\+C\+K\+\_\+\+G\+R\+O\+W\+TH~( -\/1 )}

Definition at line 103 of file portmacro.\+h.

Referenced by prv\+Allocate\+T\+C\+B\+And\+Stack().

\mbox{\Hypertarget{portmacro_8h_ab0a294066ac7369b8f59a52d9491a92c}\label{portmacro_8h_ab0a294066ac7369b8f59a52d9491a92c}} 
\index{portmacro.\+h@{portmacro.\+h}!port\+S\+T\+A\+C\+K\+\_\+\+T\+Y\+PE@{port\+S\+T\+A\+C\+K\+\_\+\+T\+Y\+PE}}
\index{port\+S\+T\+A\+C\+K\+\_\+\+T\+Y\+PE@{port\+S\+T\+A\+C\+K\+\_\+\+T\+Y\+PE}!portmacro.\+h@{portmacro.\+h}}
\subsubsection{\texorpdfstring{port\+S\+T\+A\+C\+K\+\_\+\+T\+Y\+PE}{portSTACK\_TYPE}}
{\footnotesize\ttfamily \#define port\+S\+T\+A\+C\+K\+\_\+\+T\+Y\+PE~unsigned \hyperlink{portmacro_8h_a6bbebff6020ac333ab6ec2ffd7f77001}{port\+L\+O\+NG}}

Definition at line 90 of file portmacro.\+h.

Referenced by prv\+Allocate\+T\+C\+B\+And\+Stack().

\mbox{\Hypertarget{portmacro_8h_a1dcf4bd9c1ad4fe16a71391dd95cf585}\label{portmacro_8h_a1dcf4bd9c1ad4fe16a71391dd95cf585}} 
\index{portmacro.\+h@{portmacro.\+h}!port\+S\+U\+P\+P\+R\+E\+S\+S\+\_\+\+T\+I\+C\+K\+S\+\_\+\+A\+N\+D\+\_\+\+S\+L\+E\+EP@{port\+S\+U\+P\+P\+R\+E\+S\+S\+\_\+\+T\+I\+C\+K\+S\+\_\+\+A\+N\+D\+\_\+\+S\+L\+E\+EP}}
\index{port\+S\+U\+P\+P\+R\+E\+S\+S\+\_\+\+T\+I\+C\+K\+S\+\_\+\+A\+N\+D\+\_\+\+S\+L\+E\+EP@{port\+S\+U\+P\+P\+R\+E\+S\+S\+\_\+\+T\+I\+C\+K\+S\+\_\+\+A\+N\+D\+\_\+\+S\+L\+E\+EP}!portmacro.\+h@{portmacro.\+h}}
\subsubsection{\texorpdfstring{port\+S\+U\+P\+P\+R\+E\+S\+S\+\_\+\+T\+I\+C\+K\+S\+\_\+\+A\+N\+D\+\_\+\+S\+L\+E\+EP}{portSUPPRESS\_TICKS\_AND\_SLEEP}}
{\footnotesize\ttfamily \#define port\+S\+U\+P\+P\+R\+E\+S\+S\+\_\+\+T\+I\+C\+K\+S\+\_\+\+A\+N\+D\+\_\+\+S\+L\+E\+EP(\begin{DoxyParamCaption}\item[{}]{x\+Expected\+Idle\+Time }\end{DoxyParamCaption})~\hyperlink{portmacro_8h_acdb8d638456fdeeb9d21cb8f3fc74efe}{v\+Port\+Suppress\+Ticks\+And\+Sleep}( x\+Expected\+Idle\+Time )}

Definition at line 141 of file portmacro.\+h.

Referenced by port\+T\+A\+S\+K\+\_\+\+F\+U\+N\+C\+T\+I\+O\+N().

\mbox{\Hypertarget{portmacro_8h_a3a289793652f505c538abea27045ccdf}\label{portmacro_8h_a3a289793652f505c538abea27045ccdf}} 
\index{portmacro.\+h@{portmacro.\+h}!port\+T\+A\+S\+K\+\_\+\+F\+U\+N\+C\+T\+I\+ON@{port\+T\+A\+S\+K\+\_\+\+F\+U\+N\+C\+T\+I\+ON}}
\index{port\+T\+A\+S\+K\+\_\+\+F\+U\+N\+C\+T\+I\+ON@{port\+T\+A\+S\+K\+\_\+\+F\+U\+N\+C\+T\+I\+ON}!portmacro.\+h@{portmacro.\+h}}
\subsubsection{\texorpdfstring{port\+T\+A\+S\+K\+\_\+\+F\+U\+N\+C\+T\+I\+ON}{portTASK\_FUNCTION}}
{\footnotesize\ttfamily \#define port\+T\+A\+S\+K\+\_\+\+F\+U\+N\+C\+T\+I\+ON(\begin{DoxyParamCaption}\item[{}]{v\+Function,  }\item[{}]{pv\+Parameters }\end{DoxyParamCaption})~void v\+Function( void $\ast$pv\+Parameters )}

Definition at line 135 of file portmacro.\+h.

\mbox{\Hypertarget{portmacro_8h_a2921e1c5a1f974dfa01ae44d1f665f14}\label{portmacro_8h_a2921e1c5a1f974dfa01ae44d1f665f14}} 
\index{portmacro.\+h@{portmacro.\+h}!port\+T\+A\+S\+K\+\_\+\+F\+U\+N\+C\+T\+I\+O\+N\+\_\+\+P\+R\+O\+TO@{port\+T\+A\+S\+K\+\_\+\+F\+U\+N\+C\+T\+I\+O\+N\+\_\+\+P\+R\+O\+TO}}
\index{port\+T\+A\+S\+K\+\_\+\+F\+U\+N\+C\+T\+I\+O\+N\+\_\+\+P\+R\+O\+TO@{port\+T\+A\+S\+K\+\_\+\+F\+U\+N\+C\+T\+I\+O\+N\+\_\+\+P\+R\+O\+TO}!portmacro.\+h@{portmacro.\+h}}
\subsubsection{\texorpdfstring{port\+T\+A\+S\+K\+\_\+\+F\+U\+N\+C\+T\+I\+O\+N\+\_\+\+P\+R\+O\+TO}{portTASK\_FUNCTION\_PROTO}}
{\footnotesize\ttfamily \#define port\+T\+A\+S\+K\+\_\+\+F\+U\+N\+C\+T\+I\+O\+N\+\_\+\+P\+R\+O\+TO(\begin{DoxyParamCaption}\item[{}]{v\+Function,  }\item[{}]{pv\+Parameters }\end{DoxyParamCaption})~void v\+Function( void $\ast$pv\+Parameters )}

Definition at line 134 of file portmacro.\+h.

\mbox{\Hypertarget{portmacro_8h_a8689cad2afb0c5f65d866e2c356378bf}\label{portmacro_8h_a8689cad2afb0c5f65d866e2c356378bf}} 
\index{portmacro.\+h@{portmacro.\+h}!port\+T\+I\+C\+K\+\_\+\+R\+A\+T\+E\+\_\+\+MS@{port\+T\+I\+C\+K\+\_\+\+R\+A\+T\+E\+\_\+\+MS}}
\index{port\+T\+I\+C\+K\+\_\+\+R\+A\+T\+E\+\_\+\+MS@{port\+T\+I\+C\+K\+\_\+\+R\+A\+T\+E\+\_\+\+MS}!portmacro.\+h@{portmacro.\+h}}
\subsubsection{\texorpdfstring{port\+T\+I\+C\+K\+\_\+\+R\+A\+T\+E\+\_\+\+MS}{portTICK\_RATE\_MS}}
{\footnotesize\ttfamily \#define port\+T\+I\+C\+K\+\_\+\+R\+A\+T\+E\+\_\+\+MS~( ( \hyperlink{portmacro_8h_a4d746b2ff8fafc490b764c66411ec457}{port\+Tick\+Type} ) 1000 / \hyperlink{FreeRTOSConfig_8h_a2f0258dd1e3b877e5bc013be54c2db6a}{config\+T\+I\+C\+K\+\_\+\+R\+A\+T\+E\+\_\+\+HZ} )}

Definition at line 104 of file portmacro.\+h.

\mbox{\Hypertarget{portmacro_8h_ae1ff06193615f5130b5a97dc9e708fc7}\label{portmacro_8h_ae1ff06193615f5130b5a97dc9e708fc7}} 
\index{portmacro.\+h@{portmacro.\+h}!port\+Y\+I\+E\+LD@{port\+Y\+I\+E\+LD}}
\index{port\+Y\+I\+E\+LD@{port\+Y\+I\+E\+LD}!portmacro.\+h@{portmacro.\+h}}
\subsubsection{\texorpdfstring{port\+Y\+I\+E\+LD}{portYIELD}}
{\footnotesize\ttfamily \#define port\+Y\+I\+E\+LD(\begin{DoxyParamCaption}{ }\end{DoxyParamCaption})~\hyperlink{port_8c_add01c927fb689f7ec170e42d47d27927}{v\+Port\+Yield}()}

Definition at line 113 of file portmacro.\+h.

\mbox{\Hypertarget{portmacro_8h_aac6850c66595efdc02a8bbb95fb4648e}\label{portmacro_8h_aac6850c66595efdc02a8bbb95fb4648e}} 
\index{portmacro.\+h@{portmacro.\+h}!port\+Y\+I\+E\+L\+D\+\_\+\+F\+R\+O\+M\+\_\+\+I\+SR@{port\+Y\+I\+E\+L\+D\+\_\+\+F\+R\+O\+M\+\_\+\+I\+SR}}
\index{port\+Y\+I\+E\+L\+D\+\_\+\+F\+R\+O\+M\+\_\+\+I\+SR@{port\+Y\+I\+E\+L\+D\+\_\+\+F\+R\+O\+M\+\_\+\+I\+SR}!portmacro.\+h@{portmacro.\+h}}
\subsubsection{\texorpdfstring{port\+Y\+I\+E\+L\+D\+\_\+\+F\+R\+O\+M\+\_\+\+I\+SR}{portYIELD\_FROM\_ISR}}
{\footnotesize\ttfamily \#define port\+Y\+I\+E\+L\+D\+\_\+\+F\+R\+O\+M\+\_\+\+I\+SR(\begin{DoxyParamCaption}\item[{}]{x }\end{DoxyParamCaption})~\hyperlink{portmacro_8h_a63b994040c62c9685490a71c87a13d8a}{port\+E\+N\+D\+\_\+\+S\+W\+I\+T\+C\+H\+I\+N\+G\+\_\+\+I\+SR}( x )}

Definition at line 115 of file portmacro.\+h.

\subsection{Typedef Documentation}
\mbox{\Hypertarget{portmacro_8h_a4d746b2ff8fafc490b764c66411ec457}\label{portmacro_8h_a4d746b2ff8fafc490b764c66411ec457}} 
\index{portmacro.\+h@{portmacro.\+h}!port\+Tick\+Type@{port\+Tick\+Type}}
\index{port\+Tick\+Type@{port\+Tick\+Type}!portmacro.\+h@{portmacro.\+h}}
\subsubsection{\texorpdfstring{port\+Tick\+Type}{portTickType}}
{\footnotesize\ttfamily typedef unsigned \hyperlink{portmacro_8h_a6bbebff6020ac333ab6ec2ffd7f77001}{port\+L\+O\+NG} \hyperlink{portmacro_8h_a4d746b2ff8fafc490b764c66411ec457}{port\+Tick\+Type}}

Definition at line 97 of file portmacro.\+h.

\subsection{Function Documentation}
\mbox{\Hypertarget{portmacro_8h_a00617dbc97b67d0f27064b65c8db0279}\label{portmacro_8h_a00617dbc97b67d0f27064b65c8db0279}} 
\index{portmacro.\+h@{portmacro.\+h}!ul\+Port\+Set\+Interrupt\+Mask@{ul\+Port\+Set\+Interrupt\+Mask}}
\index{ul\+Port\+Set\+Interrupt\+Mask@{ul\+Port\+Set\+Interrupt\+Mask}!portmacro.\+h@{portmacro.\+h}}
\subsubsection{\texorpdfstring{ul\+Port\+Set\+Interrupt\+Mask()}{ulPortSetInterruptMask()}}
{\footnotesize\ttfamily unsigned long ul\+Port\+Set\+Interrupt\+Mask (\begin{DoxyParamCaption}\item[{void}]{ }\end{DoxyParamCaption})}

\mbox{\Hypertarget{portmacro_8h_a181162673e726b3f0512ff311cffb38c}\label{portmacro_8h_a181162673e726b3f0512ff311cffb38c}} 
\index{portmacro.\+h@{portmacro.\+h}!v\+Port\+Clear\+Interrupt\+Mask@{v\+Port\+Clear\+Interrupt\+Mask}}
\index{v\+Port\+Clear\+Interrupt\+Mask@{v\+Port\+Clear\+Interrupt\+Mask}!portmacro.\+h@{portmacro.\+h}}
\subsubsection{\texorpdfstring{v\+Port\+Clear\+Interrupt\+Mask()}{vPortClearInterruptMask()}}
{\footnotesize\ttfamily void v\+Port\+Clear\+Interrupt\+Mask (\begin{DoxyParamCaption}\item[{unsigned long}]{ul\+New\+Mask\+Value }\end{DoxyParamCaption})}

Referenced by \+\_\+\+\_\+attribute\+\_\+\+\_\+().

\mbox{\Hypertarget{portmacro_8h_a2ed3554a3de09a3bd09d396ee081ab69}\label{portmacro_8h_a2ed3554a3de09a3bd09d396ee081ab69}} 
\index{portmacro.\+h@{portmacro.\+h}!v\+Port\+Enter\+Critical@{v\+Port\+Enter\+Critical}}
\index{v\+Port\+Enter\+Critical@{v\+Port\+Enter\+Critical}!portmacro.\+h@{portmacro.\+h}}
\subsubsection{\texorpdfstring{v\+Port\+Enter\+Critical()}{vPortEnterCritical()}}
{\footnotesize\ttfamily void v\+Port\+Enter\+Critical (\begin{DoxyParamCaption}\item[{void}]{ }\end{DoxyParamCaption})}

Definition at line 356 of file port.\+c.

References port\+D\+I\+S\+A\+B\+L\+E\+\_\+\+I\+N\+T\+E\+R\+R\+U\+P\+TS, and ux\+Critical\+Nesting.

\mbox{\Hypertarget{portmacro_8h_aed20ada05b957181a0de042802a82a5b}\label{portmacro_8h_aed20ada05b957181a0de042802a82a5b}} 
\index{portmacro.\+h@{portmacro.\+h}!v\+Port\+Exit\+Critical@{v\+Port\+Exit\+Critical}}
\index{v\+Port\+Exit\+Critical@{v\+Port\+Exit\+Critical}!portmacro.\+h@{portmacro.\+h}}
\subsubsection{\texorpdfstring{v\+Port\+Exit\+Critical()}{vPortExitCritical()}}
{\footnotesize\ttfamily void v\+Port\+Exit\+Critical (\begin{DoxyParamCaption}\item[{void}]{ }\end{DoxyParamCaption})}

Definition at line 365 of file port.\+c.

References port\+E\+N\+A\+B\+L\+E\+\_\+\+I\+N\+T\+E\+R\+R\+U\+P\+TS, and ux\+Critical\+Nesting.

\mbox{\Hypertarget{portmacro_8h_acdb8d638456fdeeb9d21cb8f3fc74efe}\label{portmacro_8h_acdb8d638456fdeeb9d21cb8f3fc74efe}} 
\index{portmacro.\+h@{portmacro.\+h}!v\+Port\+Suppress\+Ticks\+And\+Sleep@{v\+Port\+Suppress\+Ticks\+And\+Sleep}}
\index{v\+Port\+Suppress\+Ticks\+And\+Sleep@{v\+Port\+Suppress\+Ticks\+And\+Sleep}!portmacro.\+h@{portmacro.\+h}}
\subsubsection{\texorpdfstring{v\+Port\+Suppress\+Ticks\+And\+Sleep()}{vPortSuppressTicksAndSleep()}}
{\footnotesize\ttfamily void v\+Port\+Suppress\+Ticks\+And\+Sleep (\begin{DoxyParamCaption}\item[{\hyperlink{portmacro_8h_a4d746b2ff8fafc490b764c66411ec457}{port\+Tick\+Type}}]{x\+Expected\+Idle\+Time }\end{DoxyParamCaption})}

Referenced by x\+Port\+Sys\+Tick\+Handler().

\mbox{\Hypertarget{portmacro_8h_add01c927fb689f7ec170e42d47d27927}\label{portmacro_8h_add01c927fb689f7ec170e42d47d27927}} 
\index{portmacro.\+h@{portmacro.\+h}!v\+Port\+Yield@{v\+Port\+Yield}}
\index{v\+Port\+Yield@{v\+Port\+Yield}!portmacro.\+h@{portmacro.\+h}}
\subsubsection{\texorpdfstring{v\+Port\+Yield()}{vPortYield()}}
{\footnotesize\ttfamily void v\+Port\+Yield (\begin{DoxyParamCaption}\item[{void}]{ }\end{DoxyParamCaption})}

Definition at line 344 of file port.\+c.

References port\+N\+V\+I\+C\+\_\+\+I\+N\+T\+\_\+\+C\+T\+R\+L\+\_\+\+R\+EG, and port\+N\+V\+I\+C\+\_\+\+P\+E\+N\+D\+S\+V\+S\+E\+T\+\_\+\+B\+IT.
