diazmanuel/Display-PoV/Hardware Design/DataSheets/Componentes Integrados PCB/zocalo_sd.jpg

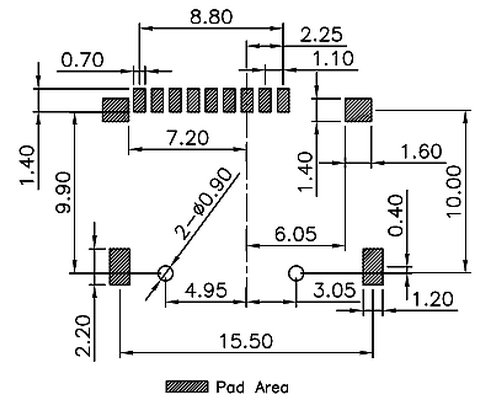
Hardware Design/DataSheets/Componentes Integrados PCB/zocalo_sd.jpg
