diazmanuel/Display-PoV/Hardware Design/DataSheets/Componentes Integrados PCB/zocalo_sd_2.jpg

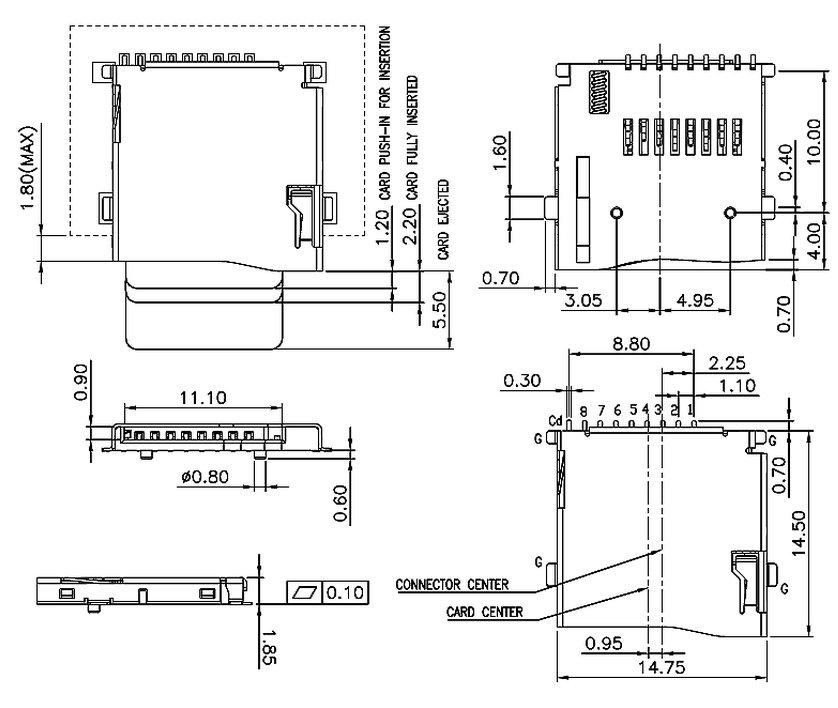
Hardware Design/DataSheets/Componentes Integrados PCB/zocalo_sd_2.jpg
