diazmanuel/Display-PoV/Hardware Design/Maqueta/Ensamblaje.SLDASM

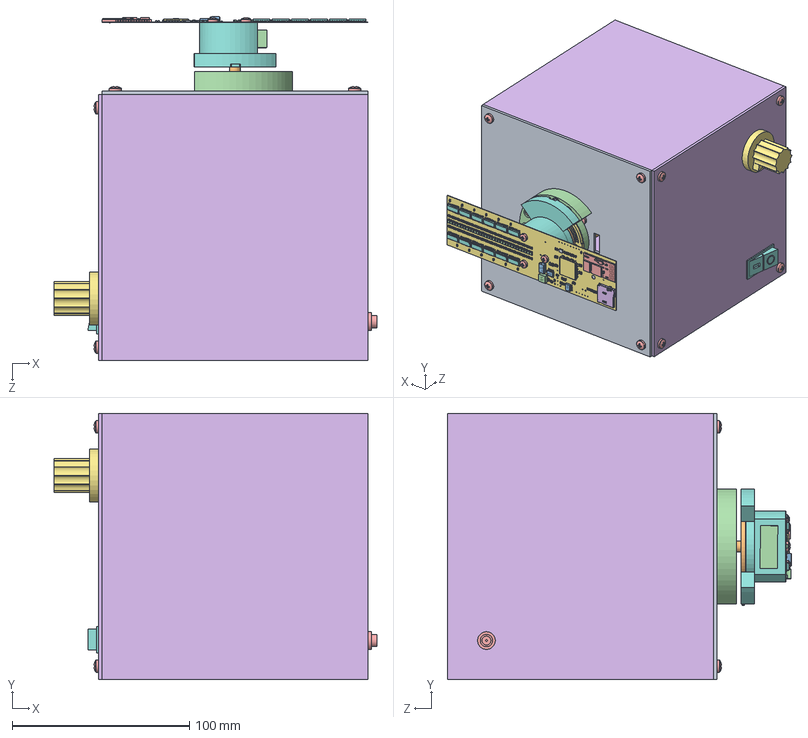
[picture p11: CAD file, 2018-12-03]
Hardware Design/Maqueta/Ensamblaje.SLDASM
182.0 x 150.0 x 194.0 mm
tapa
motor
hex nut style 1_am x 10
PiezaFijaTD2
pan cross head_am x 21
iman
Bobina_TX
PiezaMovilTD2
hall
Bobina_RX
prevailing torque hex nut_am x 3
RX
TX
base
Board
SW3DPS-CAPACITOR_0805-DEFAULT x 2
SW3DPS-CAPACITOR_0603-DEFAULT x 36
SW3DPS-RESISTOR_0603-DEFAULT x 109
User_Library-SOIC8_JEDEC_MS-012AA x 2
User_Library-FYLS-1206 x 32
User_Library-Bluetooth_HC-06_
User_Library-112J-TXAR-R_C_1-1
SW3dPS-lqfp-100
User_Library-SOIC-16-3 x 12
User_Library-ABM8
SW3dPS-SOD-323 x 2
User_Library-AVX_D_CASE
User_Library-SRP-5030_Inductor
Conector
frente
Control_Motor
Interruptor
