diazmanuel/Display-PoV/Hardware Design/Maqueta/PCB/PCB.SLDASM

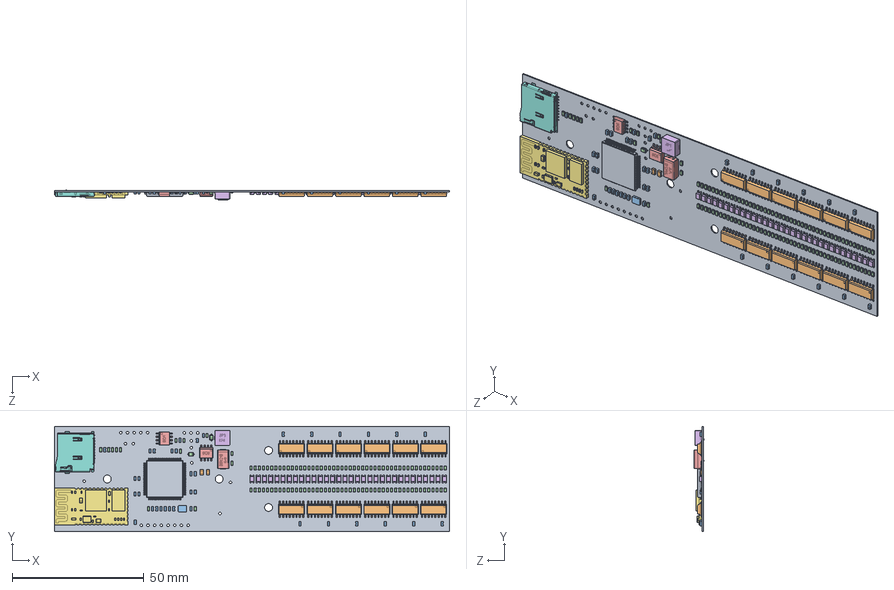
[picture p12: CAD file, 2018-12-03]
Hardware Design/Maqueta/PCB/PCB.SLDASM
150.1 x 40.0 x 3.61 mm
Board
SW3DPS-CAPACITOR_0805-DEFAULT x 2
SW3DPS-CAPACITOR_0603-DEFAULT x 36
SW3DPS-RESISTOR_0603-DEFAULT x 109
User_Library-SOIC8_JEDEC_MS-012AA x 2
User_Library-FYLS-1206 x 32
User_Library-Bluetooth_HC-06_
User_Library-112J-TXAR-R_C_1-1
SW3dPS-lqfp-100
User_Library-SOIC-16-3 x 12
User_Library-ABM8
SW3dPS-SOD-323 x 2
User_Library-AVX_D_CASE
User_Library-SRP-5030_Inductor
