diazmanuel/Display-PoV/(list of files, cad)

Other CAD files:
Hardware Design/Maqueta/PCB/R97.sldasm
Hardware Design/Maqueta/PCB/C2.sldasm
Hardware Design/Maqueta/PCB/C36.sldasm
Hardware Design/Maqueta/PCB/C17.sldasm
Hardware Design/Maqueta/PCB/C20.sldasm
Hardware Design/Maqueta/PCB/R18.sldasm
Hardware Design/Maqueta/PCB/L2.sldasm
Hardware Design/Maqueta/PCB/R26.sldasm
Hardware Design/Maqueta/PCB/R43.sldasm
Hardware Design/Maqueta/PCB/R8.sldasm
Hardware Design/Maqueta/PCB/R86.sldasm
Hardware Design/Maqueta/PCB/R100.sldasm
Hardware Design/Maqueta/PCB/C24.sldasm
Hardware Design/Maqueta/PCB/L30.sldasm
Hardware Design/Maqueta/PCB/U11.sldasm
Hardware Design/Maqueta/PCB/LX.sldasm
Hardware Design/Maqueta/PCB/R50.sldasm
Hardware Design/Maqueta/PCB/R13.sldasm
Hardware Design/Maqueta/PCB/C10.sldasm
Hardware Design/Maqueta/PCB/C4.sldasm
Hardware Design/Maqueta/PCB/R5.sldasm
Hardware Design/Maqueta/PCB/R99.sldasm
Hardware Design/Maqueta/PCB/R108.sldasm
Hardware Design/Maqueta/PCB/U5.sldasm
Hardware Design/Maqueta/PCB/U9.sldasm
Hardware Design/Maqueta/PCB/R82.sldasm
Hardware Design/Maqueta/PCB/R36.sldasm
Hardware Design/Maqueta/PCB/C23.sldasm
Hardware Design/Maqueta/PCB/L14.sldasm
Hardware Design/Maqueta/PCB/R42.sldasm
Hardware Design/Maqueta/PCB/R30.sldasm
Hardware Design/Maqueta/PCB/R83.sldasm
Hardware Design/Maqueta/PCB/U10.sldasm
Hardware Design/Maqueta/PCB/R102.sldasm
Hardware Design/Maqueta/PCB/R80.sldasm
Hardware Design/Maqueta/PCB/C15.sldasm
Hardware Design/Maqueta/PCB/U8.sldasm
Hardware Design/Maqueta/PCB/R77.sldasm
Hardware Design/Maqueta/PCB/C6.sldasm
Hardware Design/Maqueta/PCB/L11.sldasm
Hardware Design/Maqueta/PCB/R79.sldasm
Hardware Design/Maqueta/PCB/R64.sldasm
Hardware Design/Maqueta/PCB/R98.sldasm
Hardware Design/Maqueta/PCB/R49.sldasm
Hardware Design/Maqueta/PCB/R38.sldasm
Hardware Design/Maqueta/PCB/R3.sldasm
Hardware Design/Maqueta/PCB/R88.sldasm
Hardware Design/Maqueta/PCB/R15.sldasm
Hardware Design/Maqueta/PCB/R54.sldasm
Hardware Design/Maqueta/PCB/C5.sldasm
Hardware Design/Maqueta/PCB/R34.sldasm
Hardware Design/Maqueta/PCB/C9.sldasm
Hardware Design/Maqueta/PCB/R75.sldasm
Hardware Design/Maqueta/PCB/R58.sldasm
Hardware Design/Maqueta/PCB/R16.sldasm
Hardware Design/Maqueta/PCB/R6.sldasm
Hardware Design/Maqueta/PCB/R103.sldasm
Hardware Design/Maqueta/PCB/L20.sldasm
Hardware Design/Maqueta/PCB/R72.sldasm
Hardware Design/Maqueta/PCB/L17.sldasm
Hardware Design/Maqueta/PCB/U14.sldasm
Hardware Design/Maqueta/PCB/R12.sldasm
Hardware Design/Maqueta/PCB/Y1.sldasm
Hardware Design/Maqueta/PCB/C32.sldasm
Hardware Design/Maqueta/PCB/U4.sldasm
Hardware Design/Maqueta/PCB/C37.sldasm
Hardware Design/Maqueta/PCB/R85.sldasm
Hardware Design/Maqueta/PCB/D2.sldasm
Hardware Design/Maqueta/PCB/U12.sldasm
Hardware Design/Maqueta/PCB/R95.sldasm
Hardware Design/Maqueta/PCB/R74.sldasm
Hardware Design/Maqueta/PCB/R22.sldasm
Hardware Design/Maqueta/PCB/R53.sldasm
Hardware Design/Maqueta/PCB/R29.sldasm
Hardware Design/Maqueta/PCB/R84.sldasm
Hardware Design/Maqueta/PCB/C1.sldasm
Hardware Design/Maqueta/PCB/R106.sldasm
Hardware Design/Maqueta/PCB/R45.sldasm
Hardware Design/Maqueta/PCB/L8.sldasm
Hardware Design/Maqueta/PCB/R71.sldasm
Hardware Design/Maqueta/PCB/R44.sldasm
Hardware Design/Maqueta/PCB/U15.sldasm
Hardware Design/Maqueta/PCB/R70.sldasm
Hardware Design/Maqueta/PCB/L29.sldasm
Hardware Design/Maqueta/PCB/R73.sldasm
Hardware Design/Maqueta/PCB/R47.sldasm
Hardware Design/Maqueta/PCB/R101.sldasm
Hardware Design/Maqueta/PCB/R66.sldasm
Hardware Design/Maqueta/PCB/L10.sldasm
Hardware Design/Maqueta/PCB/R46.sldasm
Hardware Design/Maqueta/PCB/R107.sldasm
Hardware Design/Maqueta/PCB/R52.sldasm
Hardware Design/Maqueta/PCB/L1.sldasm
Hardware Design/Maqueta/PCB/C30.sldasm
Hardware Design/Maqueta/PCB/R78.sldasm
Hardware Design/Maqueta/PCB/R31.sldasm
Hardware Design/Maqueta/PCB/R39.sldasm
Hardware Design/Maqueta/PCB/R87.sldasm
Hardware Design/Maqueta/PCB/R27.sldasm
Hardware Design/Maqueta/PCB/R109.sldasm
Hardware Design/Maqueta/PCB/C34.sldasm
Hardware Design/Maqueta/PCB/C14.sldasm
Hardware Design/Maqueta/PCB/R2.sldasm
Hardware Design/Maqueta/PCB/R60.sldasm
Hardware Design/Maqueta/PCB/U7.sldasm
Hardware Design/Maqueta/PCB/L15.sldasm
Hardware Design/Maqueta/PCB/C29.sldasm
Hardware Design/Maqueta/PCB/C21.sldasm
Hardware Design/Maqueta/PCB/L18.sldasm
Hardware Design/Maqueta/PCB/R63.sldasm
Hardware Design/Maqueta/PCB/C27.sldasm
Hardware Design/Maqueta/PCB/R41.sldasm
Hardware Design/Maqueta/PCB/C11.sldasm
Hardware Design/Maqueta/PCB/C22.sldasm
Hardware Design/Maqueta/PCB/S1.sldasm
Hardware Design/Maqueta/PCB/C25.sldasm
Hardware Design/Maqueta/PCB/R7.sldasm
Hardware Design/Maqueta/PCB/L21.sldasm
Hardware Design/Maqueta/PCB/U1.sldasm
Hardware Design/Maqueta/PCB/R56.sldasm
Hardware Design/Maqueta/PCB/R21.sldasm
Hardware Design/Maqueta/PCB/R25.sldasm
Hardware Design/Maqueta/PCB/U2.sldasm
Hardware Design/Maqueta/PCB/R32.sldasm
Hardware Design/Maqueta/PCB/R91.sldasm
Hardware Design/Maqueta/PCB/L22.sldasm
Hardware Design/Maqueta/PCB/R14.sldasm
Hardware Design/Maqueta/PCB/L27.sldasm
Hardware Design/Maqueta/PCB/C16.sldasm
Hardware Design/Maqueta/PCB/R48.sldasm
Hardware Design/Maqueta/PCB/R40.sldasm
Hardware Design/Maqueta/PCB/U13.sldasm
Hardware Design/Maqueta/PCB/R67.sldasm
Hardware Design/Maqueta/PCB/R92.sldasm
Hardware Design/Maqueta/PCB/L26.sldasm
Hardware Design/Maqueta/PCB/R69.sldasm
Hardware Design/Maqueta/PCB/R20.sldasm
Hardware Design/Maqueta/PCB/L32.sldasm
Hardware Design/Maqueta/PCB/R68.sldasm
Hardware Design/Maqueta/PCB/C38.sldasm
Hardware Design/Maqueta/PCB/R94.sldasm
Hardware Design/Maqueta/PCB/R28.sldasm
Hardware Design/Maqueta/PCB/L3.sldasm
Hardware Design/Maqueta/PCB/R65.sldasm
Hardware Design/Maqueta/PCB/R96.sldasm
Hardware Design/Maqueta/PCB/R93.sldasm
Hardware Design/Maqueta/PCB/L6.sldasm
Hardware Design/Maqueta/PCB/C26.sldasm
Hardware Design/Maqueta/PCB/Board.sldprt
Hardware Design/Maqueta/PCB/C12.sldasm
Hardware Design/Maqueta/PCB/C13.sldasm
Hardware Design/Maqueta/PCB/C18.sldasm
Hardware Design/Maqueta/PCB/C19.sldasm
Hardware Design/Maqueta/PCB/C28.sldasm
Hardware Design/Maqueta/PCB/C3.sldasm
Hardware Design/Maqueta/PCB/C31.sldasm
Hardware Design/Maqueta/PCB/C33.sldasm
Hardware Design/Maqueta/PCB/C35.sldasm
Hardware Design/Maqueta/PCB/C39.sldasm
Hardware Design/Maqueta/PCB/C7.sldasm
Hardware Design/Maqueta/PCB/C8.sldasm
Hardware Design/Maqueta/PCB/D1.sldasm
Hardware Design/Maqueta/PCB/L12.sldasm
Hardware Design/Maqueta/PCB/L13.sldasm
Hardware Design/Maqueta/PCB/L16.sldasm
Hardware Design/Maqueta/PCB/L19.sldasm
Hardware Design/Maqueta/PCB/L23.sldasm
Hardware Design/Maqueta/PCB/L24.sldasm
Hardware Design/Maqueta/PCB/L25.sldasm
Hardware Design/Maqueta/PCB/L28.sldasm
Hardware Design/Maqueta/PCB/L31.sldasm
Hardware Design/Maqueta/PCB/L4.sldasm
Hardware Design/Maqueta/PCB/L5.sldasm
Hardware Design/Maqueta/PCB/L7.sldasm
Hardware Design/Maqueta/PCB/L9.sldasm
Hardware Design/Maqueta/PCB/R1.sldasm
Hardware Design/Maqueta/PCB/R10.sldasm
Hardware Design/Maqueta/PCB/R104.sldasm
Hardware Design/Maqueta/PCB/R105.sldasm
Hardware Design/Maqueta/PCB/R11.sldasm
Hardware Design/Maqueta/PCB/R17.sldasm
Hardware Design/Maqueta/PCB/R19.sldasm
Hardware Design/Maqueta/PCB/R23.sldasm
Hardware Design/Maqueta/PCB/R24.sldasm
Hardware Design/Maqueta/PCB/R33.sldasm
Hardware Design/Maqueta/PCB/R35.sldasm
Hardware Design/Maqueta/PCB/R37.sldasm
Hardware Design/Maqueta/PCB/R4.sldasm
Hardware Design/Maqueta/PCB/R51.sldasm
Hardware Design/Maqueta/PCB/R55.sldasm
Hardware Design/Maqueta/PCB/R57.sldasm
Hardware Design/Maqueta/PCB/R59.sldasm
Hardware Design/Maqueta/PCB/R61.sldasm
Hardware Design/Maqueta/PCB/R62.sldasm
Hardware Design/Maqueta/PCB/R76.sldasm
Hardware Design/Maqueta/PCB/R81.sldasm
Hardware Design/Maqueta/PCB/R89.sldasm
Hardware Design/Maqueta/PCB/R9.sldasm
Hardware Design/Maqueta/PCB/R90.sldasm
Hardware Design/Maqueta/PCB/S2.sldasm
Hardware Design/Maqueta/PCB/SW3DPS-CAPACITOR_0603-DEFAULT.sldprt
Hardware Design/Maqueta/PCB/SW3DPS-CAPACITOR_0805-DEFAULT.sldprt
Hardware Design/Maqueta/PCB/SW3DPS-RESISTOR_0603-DEFAULT.sldprt
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
