diazmanuel/Display-PoV/Hardware Design/Maqueta/pieza 3d/PiezaFijaTD2.PDF

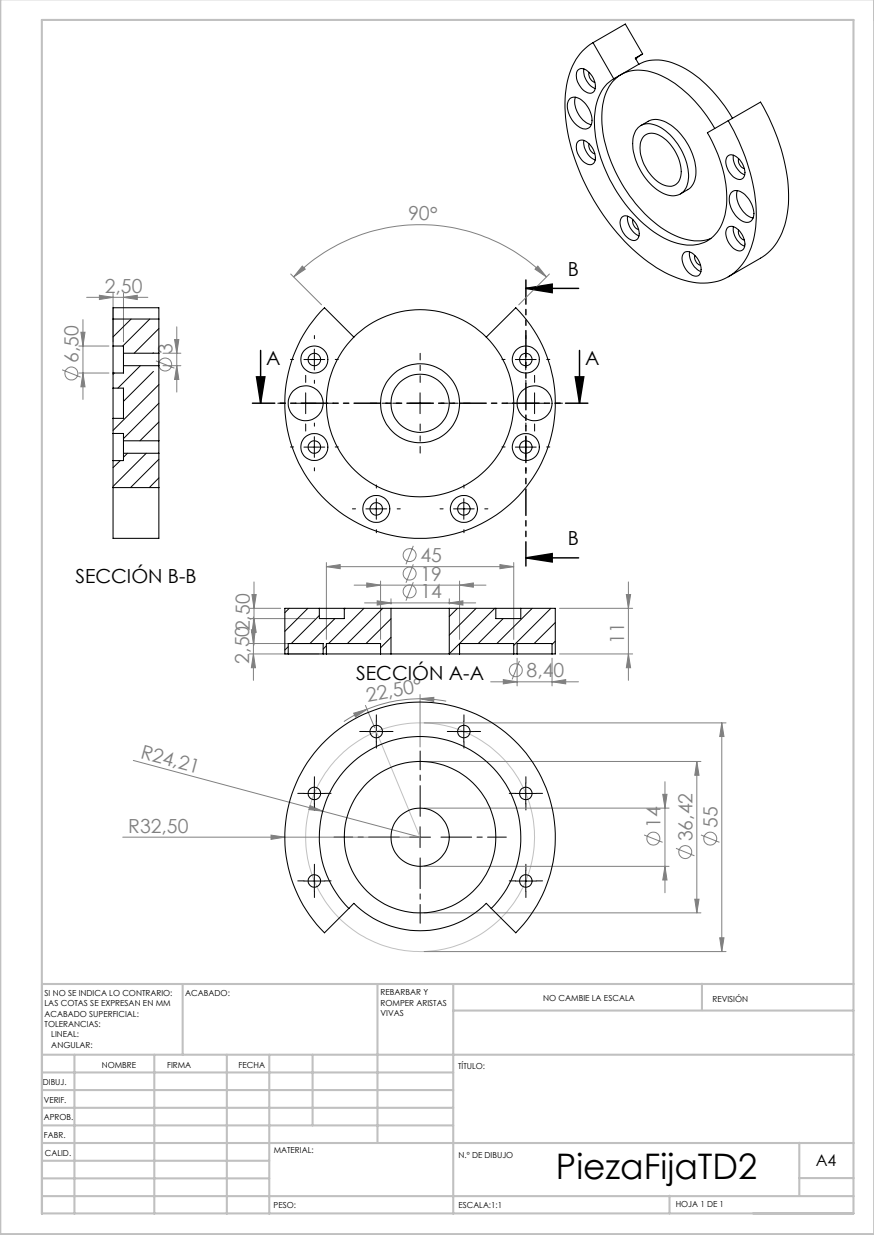
[picture p43: page 1]
SECCIÓN B-B; SECCIÓN A-A; ESCALA:1:1; HOJA 1 DE 1; NO CAMBIE LA ESCALA; REVISIÓN; REBARBAR Y ROMPER ARISTAS; SI NO SE INDICA LO CONTRARIO:; ACABADO:

LAS COTAS SE EXPRESAN EN MM
ACABADO SUPERFICIAL:
TOLERANCIAS:
LINEAL:
ANGULAR:

NOMBRE | FIRMA | FECHA | | | | TÍTULO:
CALID. | | | | MATERIAL: | PiezaFijaTD2 PESO: N.º DE DIBUJO | A4

DIBUJ.
VERIF.
APROB.
FABR.
