diazmanuel/Display-PoV/Hardware Design/PCB/PCB_TPO_TD2.PDF

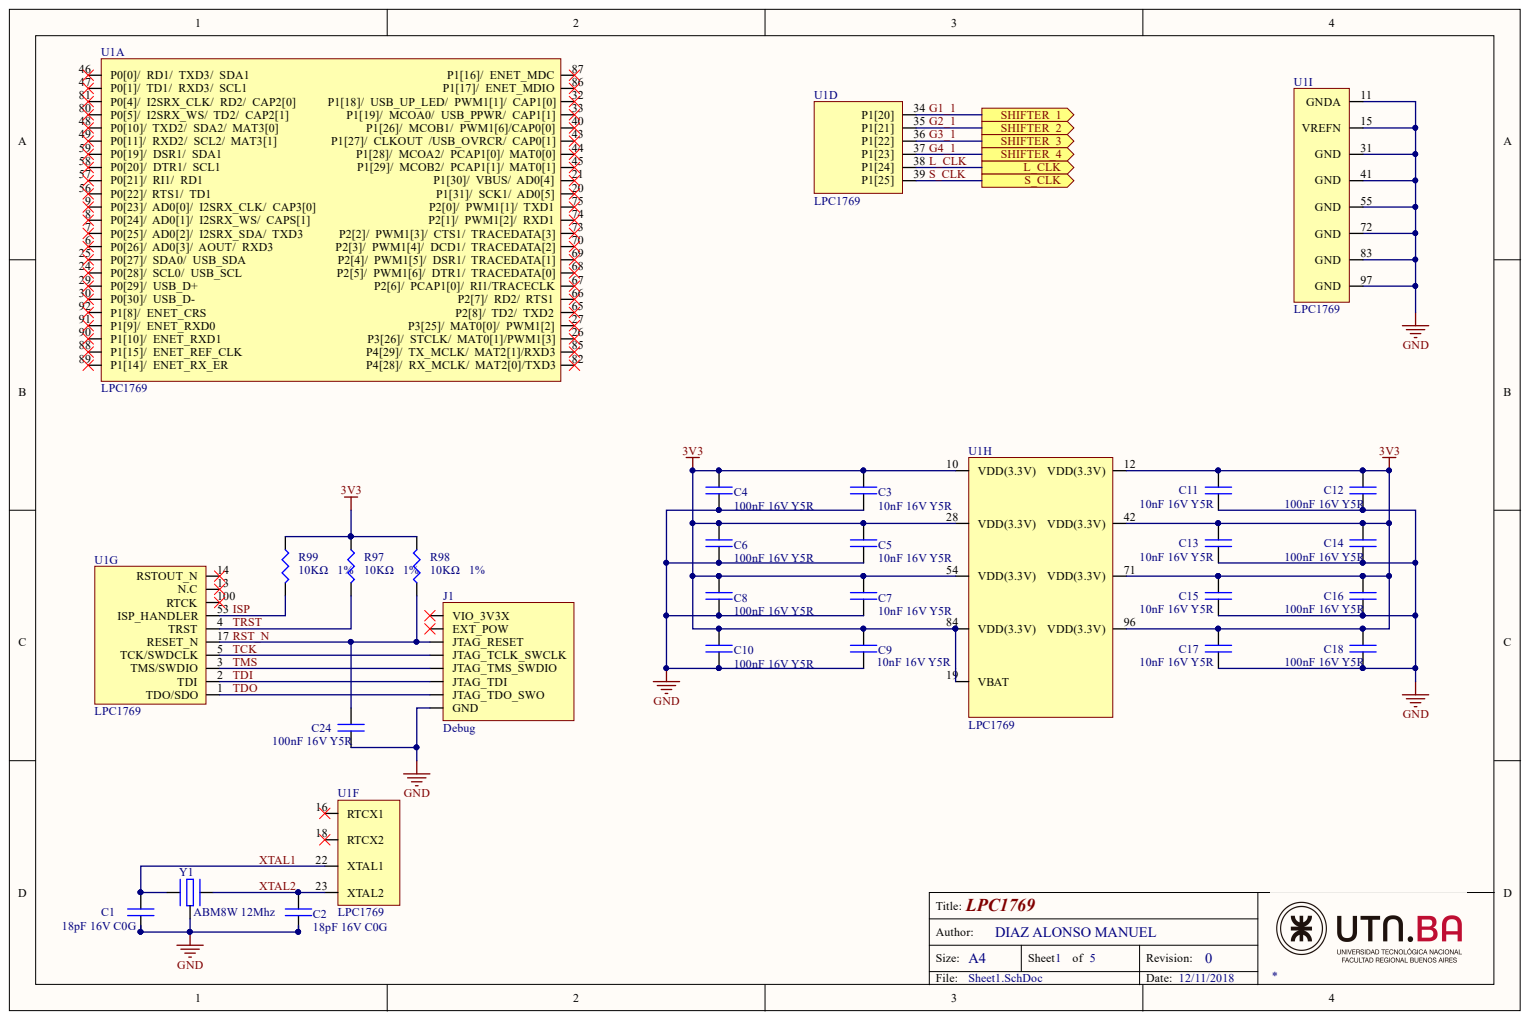
[picture p44: page 1]

3 ISP

TCK TRST TMS TDI TDO

T i t le: LPC1 76 9 | *

A4 Size: | Sheet 1 o f 5 | 0 Rev i s i o n :
Fi le: Sheet 1.Sch D o c | | Date: /

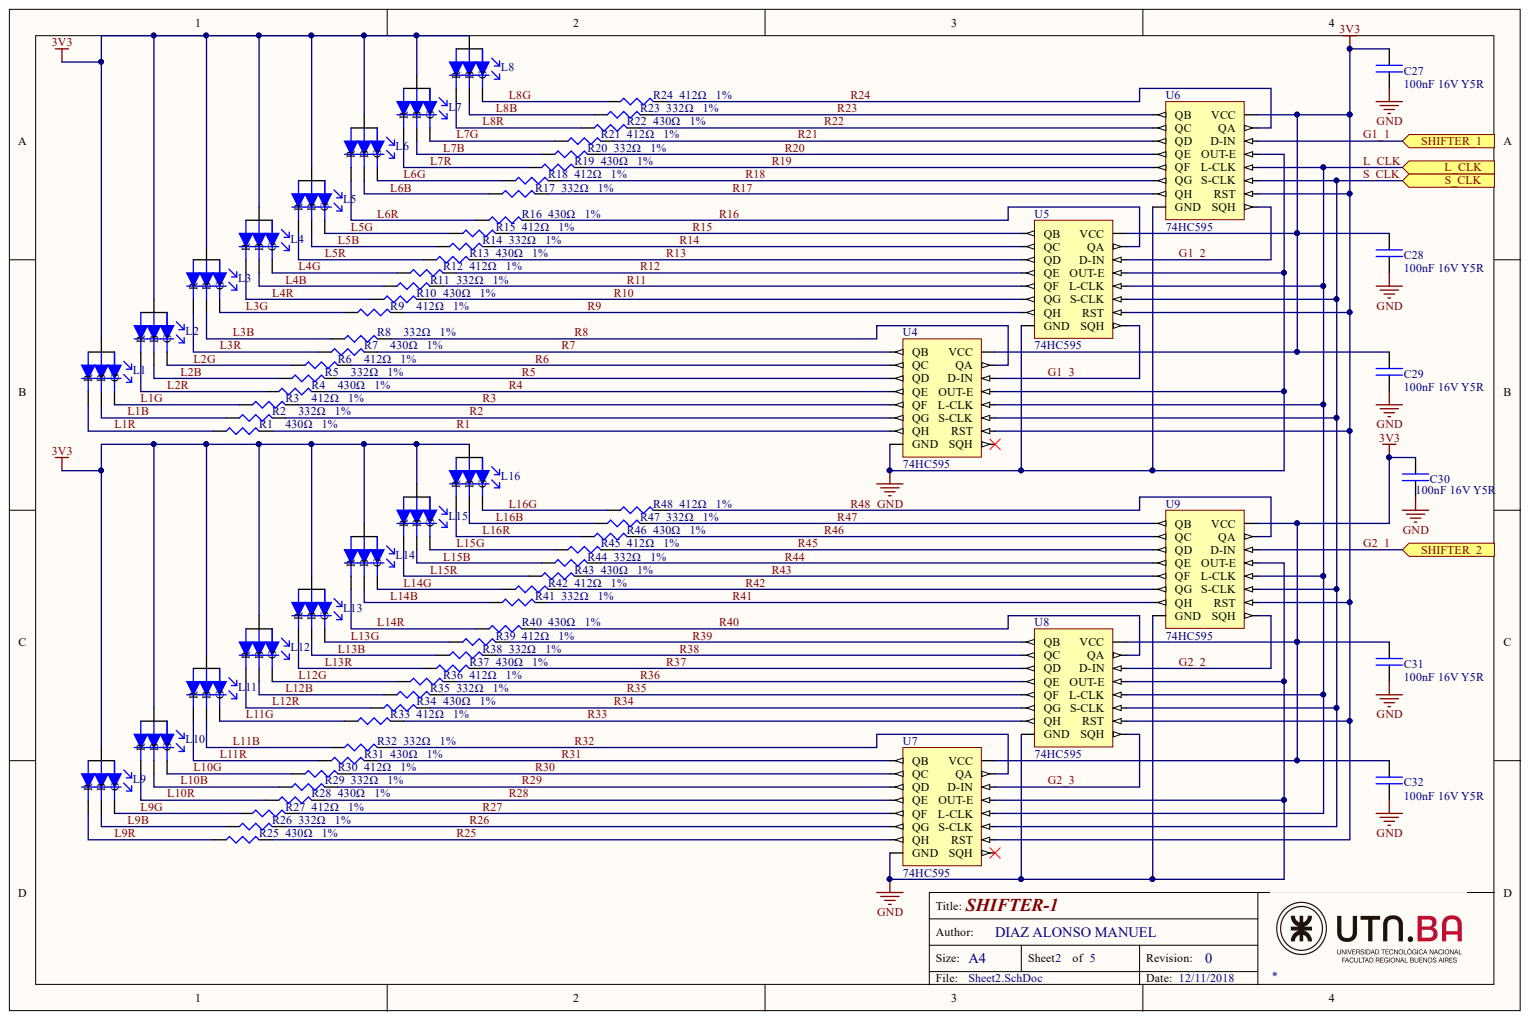
[picture p45: page 2]

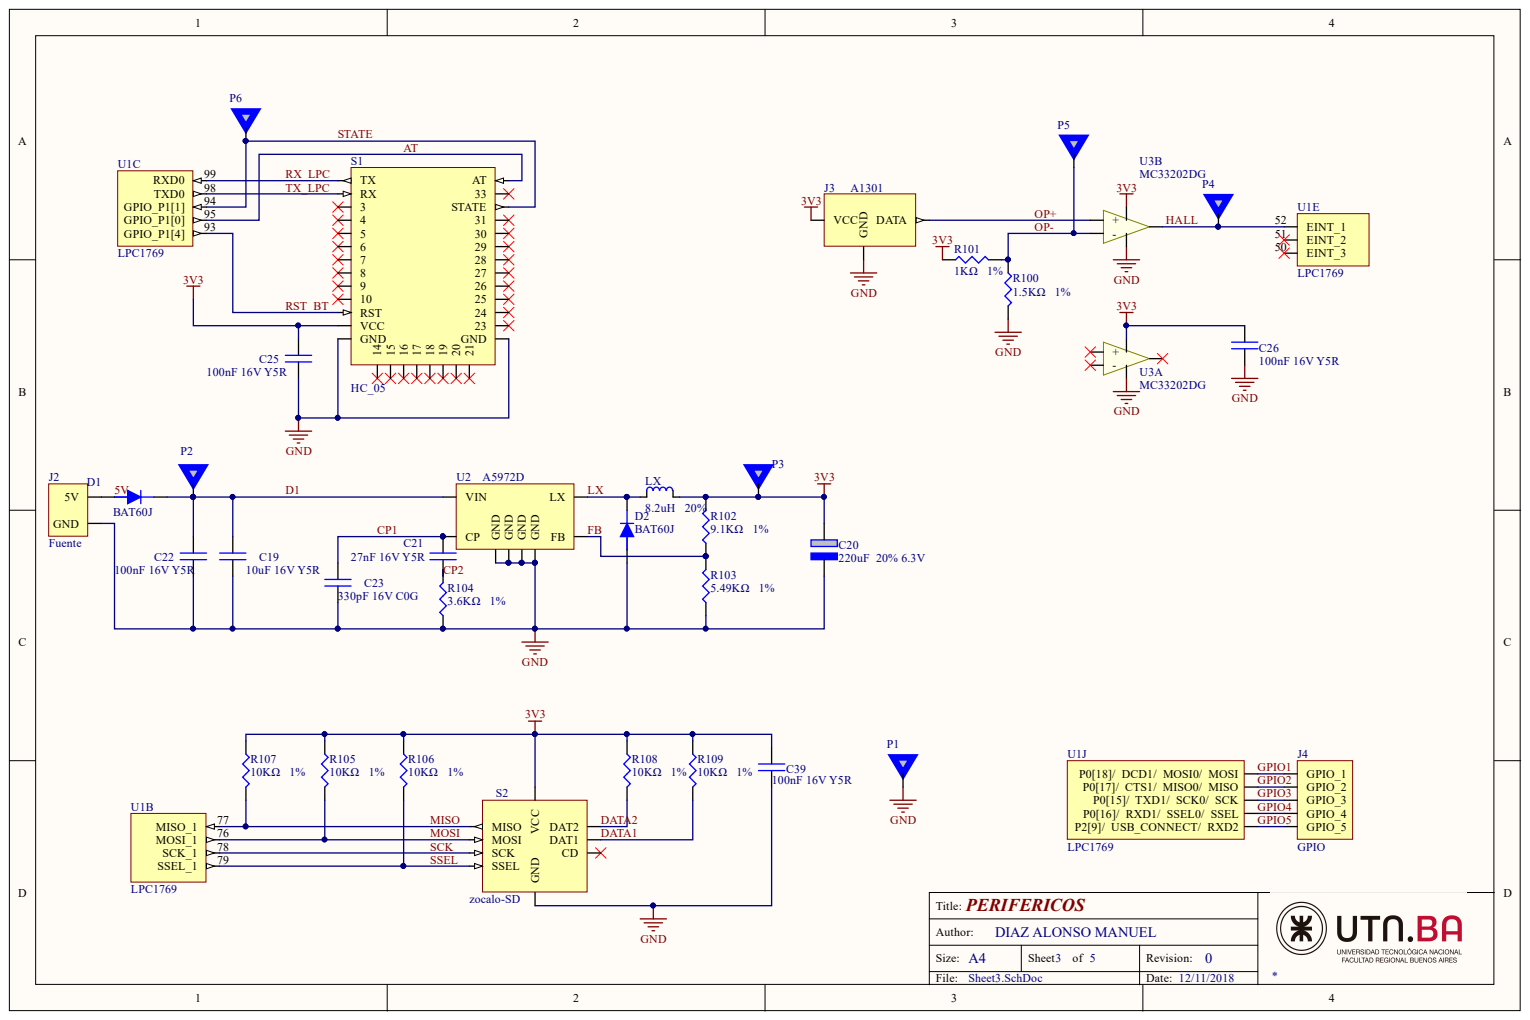
[picture p46: page 3]

TX_LPC

A4 Size: | Sheet of 3 5 | Revision: 0
File: Sheet3.SchDoc | | Date: 12/11/2018

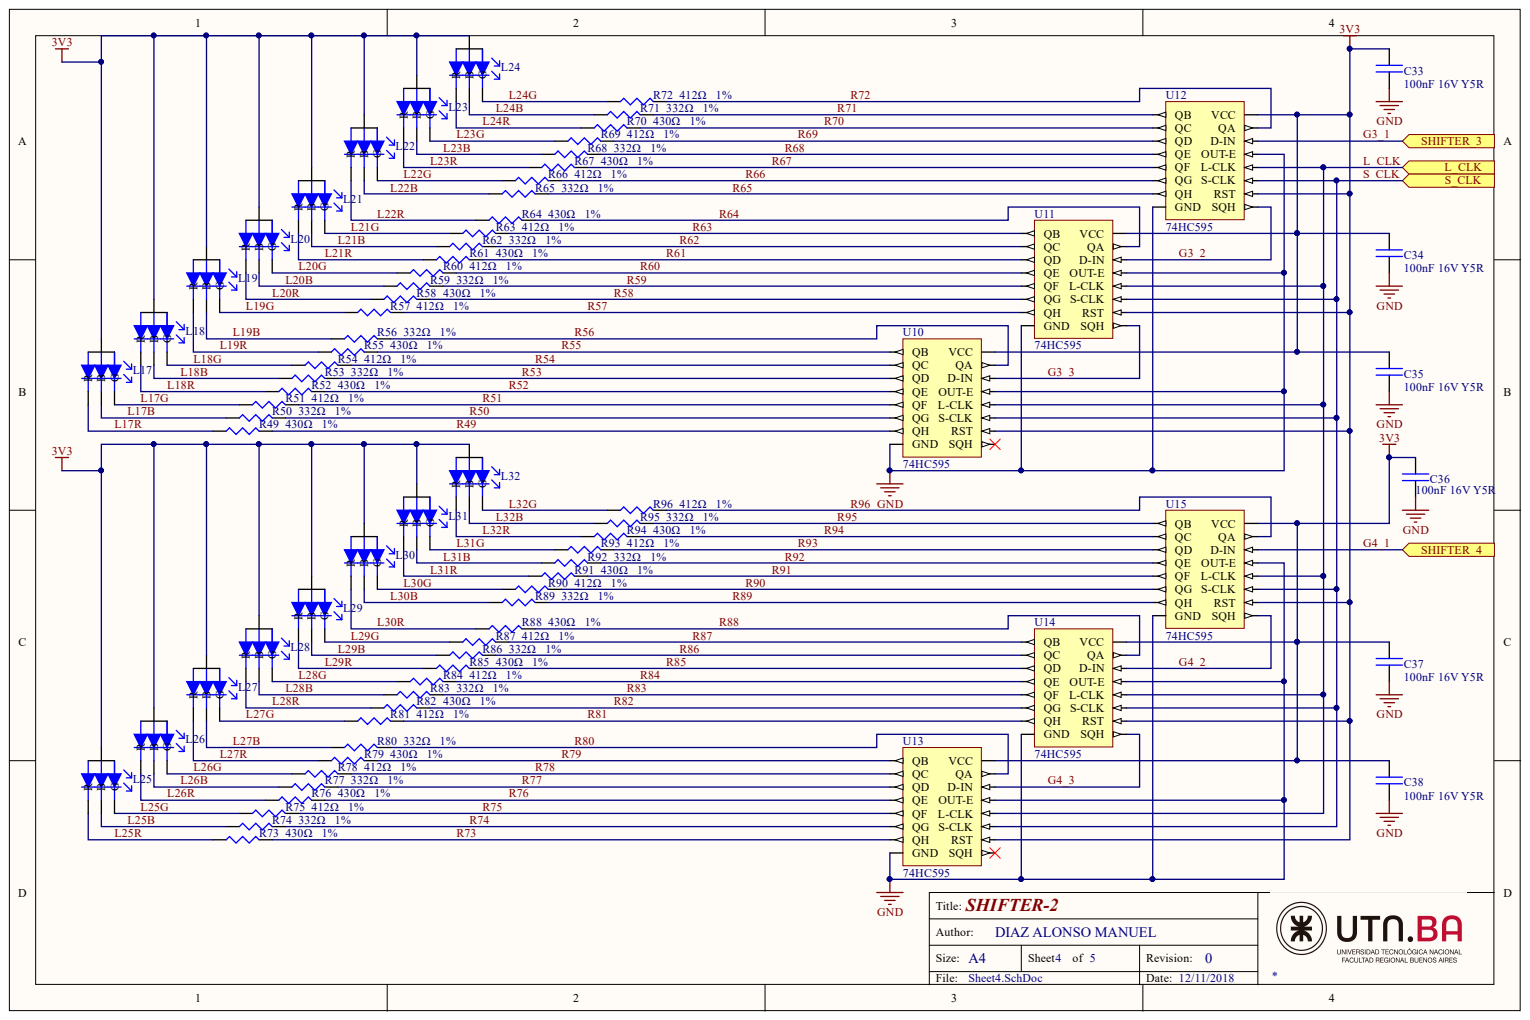
[picture p47: page 4]

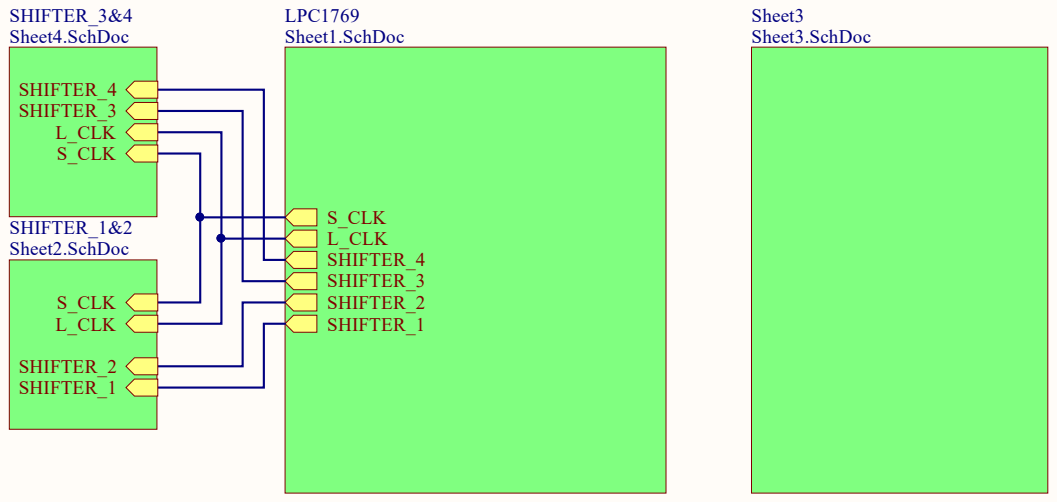
[picture p48: page 5]

A4 Size: | Sheet of 5 5 | Revision: 0
File: Sheet5.SchDoc | | Date: 12/11/2018

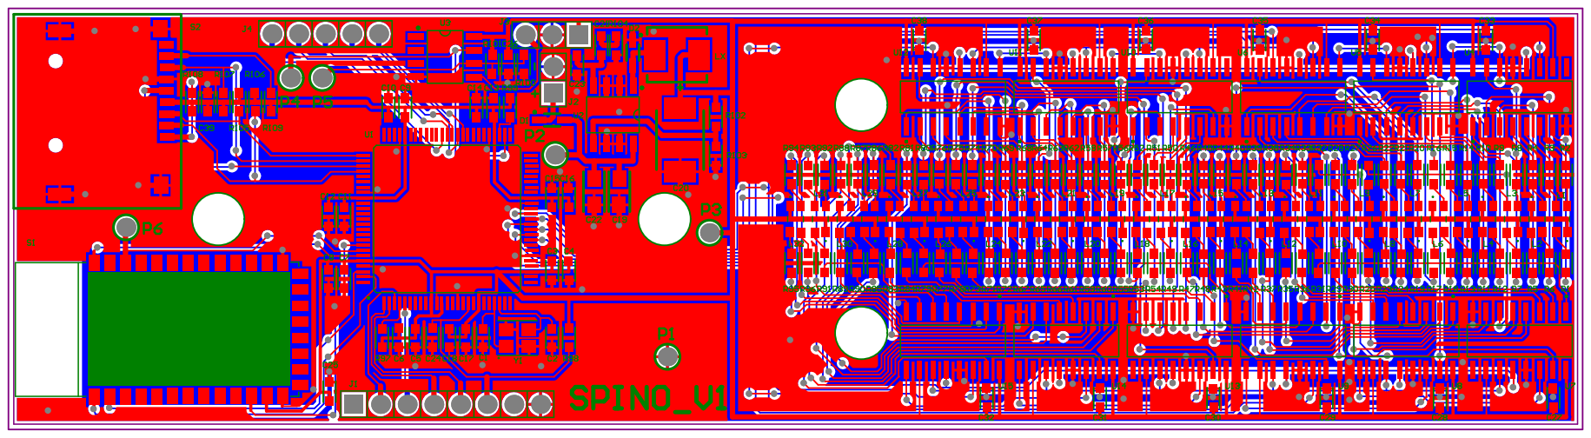
[picture p49: page 6]
