diazmanuel/Display-PoV/Software Design/Aplicacion-PC/src/utils.c

/* MIT License
 *
 * Copyright (c) 2017 spino.tech Guillaume Chereau & Raphael Seghier
 *
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
 * THE SOFTWARE IS PROVIDED "AS IS", WITHOUT WARRANTY OF ANY KIND, EXPRESS OR
 * IMPLIED, INCLUDING BUT NOT LIMITED TO THE WARRANTIES OF MERCHANTABILITY,
 * FITNESS FOR A PARTICULAR PURPOSE AND NONINFRINGEMENT. IN NO EVENT SHALL THE
 * AUTHORS OR COPYRIGHT HOLDERS BE LIABLE FOR ANY CLAIM, DAMAGES OR OTHER
 * LIABILITY, WHETHER IN AN ACTION OF CONTRACT, TORT OR OTHERWISE, ARISING
 * FROM, OUT OF OR IN CONNECTION WITH THE SOFTWARE OR THE USE OR OTHER DEALINGS
 * IN THE SOFTWARE.
 */

#include "spino.h"
#include <time.h>
#include <sys/time.h>
#include <sys/stat.h>

#ifdef __GNUC__
#pragma GCC diagnostic push
#pragma GCC diagnostic ignored "-Wmaybe-uninitialized"
#if __GNUC__ >= 6
#pragma GCC diagnostic ignored "-Wmisleading-indentation"
#endif
#endif

#define STB_IMAGE_IMPLEMENTATION
#define STB_IMAGE_WRITE_IMPLEMENTATION
#include "stb_image.h"
#include "stb_image_write.h"

#ifdef __GNUC__
#pragma GCC diagnostic pop
#endif


#ifndef LOG_TIME
#   define LOG_TIME 1
#endif

#ifndef __MACH__
int64_t get_clock(void)
{
    struct timespec tp;
    clock_gettime(CLOCK_REALTIME, &tp);
    return (int64_t)tp.tv_sec * 1000 * 1000 * 1000
         + (int64_t)tp.tv_nsec;
}
#else

// Apparently clock_gettime does not exists on OSX.
#include <sys/time.h>
int64_t get_clock(void)
{
    struct timeval now;
    gettimeofday(&now, NULL);
    return (int64_t)now.tv_sec * 1000 * 1000 * 1000 +
           (int64_t)now.tv_usec * 1000;
}
#endif

static double get_log_time()
{
    static double origin = 0;
    double time;
    time = get_clock() / (1000.0 * 1000.0 * 1000.0);
    if (!origin) origin = time;
    return time - origin;
}

void dolog(int level, const char *msg,
           const char *func, const char *file, int line, ...)
{
    static bool disabled = false;
    const bool use_colors = !DEFINED(__APPLE__);
    char *msg_formatted, *full_msg;
    const char *format;
    char time_str[32] = "";
    va_list args;

    if (disabled) return;
    va_start(args, line);
    vasprintf(&msg_formatted, msg, args);
    va_end(args);

    if (use_colors && level >= GOX_LOG_WARN) {
        format = "\e[33;31m%s%-60s\e[m %s (%s:%d)";
    } else {
        format = "%s%-60s %s (%s:%d)";
    }

    if (DEFINED(LOG_TIME))
        sprintf(time_str, "%.3f: ", get_log_time());

    file = file + max(0, (int)strlen(file) - 20); // Truncate file path.
    asprintf(&full_msg, format, time_str, msg_formatted, func, file, line);
    sys_log(full_msg);

    disabled = true;
    spinoedit_on_log(spinoedit(), level, msg_formatted);
    disabled = false;

    free(msg_formatted);
    free(full_msg);
}

static const char* get_gl_error_text(int code) {
    switch (code) {
    case GL_INVALID_ENUM:
        return "GL_INVALID_ENUM";
    case GL_INVALID_FRAMEBUFFER_OPERATION:
        return "GL_INVALID_FRAMEBUFFER_OPERATION";
    case GL_INVALID_VALUE:
        return "GL_INVALID_VALUE";
    case GL_INVALID_OPERATION:
        return "GL_INVALID_OPERATION";
    case GL_OUT_OF_MEMORY:
        return "GL_OUT_OF_MEMORY";
    default:
        return "undefined error";
    }
}

int check_gl_errors(const char *file, int line)
{
    int errors = 0;
    while (true)
    {
        GLenum x = glGetError();
        if (x == GL_NO_ERROR)
            return errors;
        LOG_E("%s:%d: OpenGL error: %d (%s)\n",
            file, line, x, get_gl_error_text(x));
        errors++;
    }
}

static int compile_shader(int shader, const char *code, const char *include)
{
    int status, len;
    char *log;
#ifndef GLES2
    const char *pre = "#define highp\n#define mediump\n#define lowp\n";
#else
    const char *pre = "";
#endif
    const char *sources[] = {pre, include, code};
    glShaderSource(shader, 3, (const char**)&sources, NULL);
    glCompileShader(shader);
    glGetShaderiv(shader, GL_COMPILE_STATUS, &status);
    if (status != GL_TRUE) {
        glGetShaderiv(shader, GL_INFO_LOG_LENGTH, &len);
        log = malloc(len + 1);
        LOG_E("Compile shader error:");
        glGetShaderInfoLog(shader, len, &len, log);
        LOG_E("%s", log);
        free(log);
        assert(false);
    }
    return 0;
}

int create_program(const char *vertex_shader_code,
                       const char *fragment_shader_code, const char *include)
{
    int vertex_shader = glCreateShader(GL_VERTEX_SHADER);
    include = include ? : "";
    assert(vertex_shader);
    if (compile_shader(vertex_shader, vertex_shader_code, include))
        return 0;
    int fragment_shader = glCreateShader(GL_FRAGMENT_SHADER);
    assert(fragment_shader);
    if (compile_shader(fragment_shader, fragment_shader_code, include))
        return 0;
    int prog = glCreateProgram();
    glAttachShader(prog, vertex_shader);
    glAttachShader(prog, fragment_shader);
    glLinkProgram(prog);
    int status;
    glGetProgramiv(prog, GL_LINK_STATUS, &status);
    if (status != GL_TRUE) {
        LOG_E("Link Error");
        int len;
        glGetProgramiv(prog, GL_INFO_LOG_LENGTH, &len);
        char log[len];
        glGetProgramInfoLog(prog, len, &len, log);
        LOG_E("%s", log);
        return 0;
    }
    return prog;
}

void delete_program(int prog)
{
    int i;
    GLuint shaders[2];
    GLint count;
    if (DEBUG) {
        GL(glGetProgramiv(prog, GL_ATTACHED_SHADERS, &count));
        assert(count == 2);
    }
    GL(glGetAttachedShaders(prog, 2, NULL, shaders));
    for (i = 0; i < 2; i++)
        GL(glDeleteShader(shaders[i]));
    GL(glDeleteProgram(prog));
}

bool str_startswith(const char *s1, const char *s2)
{
    if (!s1 || !s2) return false;
    if (strlen(s1) < strlen(s2)) return false;
    return strncmp(s1, s2, strlen(s2)) == 0;
}

char *read_file(const char *path, int *size)
{
    FILE *file;
    char *ret = NULL;
    int read_size __attribute__((unused));
    int size_default;

    size = size ?: &size_default; // Allow to pass NULL as size;
    file = fopen(path, "rb");
    if (!file) return NULL;
    fseek(file, 0, SEEK_END);
    *size = ftell(file);
    fseek(file, 0, SEEK_SET);
    ret = malloc(*size + 1);
    read_size = fread(ret, *size, 1, file);
    assert(read_size == 1 || *size == 0);
    ret[*size] = '\0';
    fclose(file);
    return ret;
}

uint8_t *img_read_from_mem(const char *data, int size,
                           int *w, int *h, int *bpp)
{
    assert(*bpp >= 0 && *bpp <= 4);
    return stbi_load_from_memory((uint8_t*)data, size, w, h, bpp, *bpp);
}

uint8_t *img_read(const char *path, int *width, int *height, int *bpp)
{
    int size = 0;
    char *data;
    bool need_to_free = false;
    uint8_t *img;

    data = read_file(path, &size);
    need_to_free = true;
    if (!data) LOG_E("Cannot open image %s", path);
    assert(data);
    img = img_read_from_mem(data, size, width, height, bpp);
    if (need_to_free) free(data);
    return img;
}

void img_write(const uint8_t *img, int w, int h, int bpp, const char *path)
{
    stbi_write_png(path, w, h, bpp, img, 0);
}

/*
static unsigned int base85_decode_byte(char c) {
    return c >= '\\' ? c - 36 : c - 35;
}

void base85_decode(const char *src, uint8_t *out)
{
    unsigned int tmp;
    while (*src) {
        tmp = base85_decode_byte(src[0]) +
            85 * (base85_decode_byte(src[1]) +
                    85 * (base85_decode_byte(src[2]) +
                        85 * (base85_decode_byte(src[3]) +
                            85 * base85_decode_byte(src[4]))));

        out[0] = ((tmp >> 0) & 0xFF);
        out[1] = ((tmp >> 8) & 0xFF);
        out[2] = ((tmp >> 16) & 0xFF);
        out[3] = ((tmp >> 24) & 0xFF);

        src += 5;
        out += 4;
    }
}
*/

static const char en85[] = {
    '0', '1', '2', '3', '4', '5', '6', '7', '8', '9',
    'A', 'B', 'C', 'D', 'E', 'F', 'G', 'H', 'I', 'J',
    'K', 'L', 'M', 'N', 'O', 'P', 'Q', 'R', 'S', 'T',
    'U', 'V', 'W', 'X', 'Y', 'Z',
    'a', 'b', 'c', 'd', 'e', 'f', 'g', 'h', 'i', 'j',
    'k', 'l', 'm', 'n', 'o', 'p', 'q', 'r', 's', 't',
    'u', 'v', 'w', 'x', 'y', 'z',
    '!', '#', '$', '%', '&', '(', ')', '*', '+', '-',
    ';', '<', '=', '>', '?', '@', '^', '_',	'`', '{',
    '|', '}', '~'
};

static char de85[256];
static void prep_base85(void)
{
    int i;
    if (de85['Z'])
        return;
    for (i = 0; i < ARRAY_SIZE(en85); i++) {
        int ch = en85[i];
        de85[ch] = i + 1;
    }
}

int decode_85(char *dst, const char *buffer, int len)
{
    prep_base85();

    while (len) {
        unsigned acc = 0;
        int de, cnt = 4;
        unsigned char ch;
        do {
            ch = *buffer++;
            de = de85[ch];
            if (--de < 0)
                return -1;;
            acc = acc * 85 + de;
        } while (--cnt);
        ch = *buffer++;
        de = de85[ch];
        if (--de < 0)
            return -1;
        if (0xffffffff / 85 < acc ||
                0xffffffff - de < (acc *= 85))
            return -1;
        acc += de;

        cnt = (len < 4) ? len : 4;
        len -= cnt;
        do {
            acc = (acc << 8) | (acc >> 24);
            *dst++ = acc;
        } while (--cnt);
    }
    return 0;
}
