diazmanuel/Display-PoV/(commit log)

2018-05-05 Pieza 3D SolidWorks
    pieza 3d giratoria
    [PiezaTD2.SLDPRT]
2018-05-07 Adding new files
    [CuerpoDeMontaje.SLDPRT, ShiftersTest_3x8.pcb]
2018-05-07 pieza 3d formato impresora 3d (#2)
    [PiezaTD2.STL]
2018-05-16 Agrego Plantilla de Proyecto tipo
2018-05-21 uart + pc + datasheet (#3)
    Merge branch3 - diazmanuel
2018-05-28 Branch3 (#6)
    * uart + pc + datasheet
    * cargadata
    * bluetooth init
2018-05-29 Branch4 (#7)
    * codigo unificado
    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
2018-06-07 Branch4 (#8)
    * aun no funciona
    * test+datasheets
    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
2018-06-07 Limpio archivos de debug (#9)
2018-06-16 My branch (#11)
    * Limpio archivos de debug
    * 06/07/18 Code Update
    * gitignore Update
    * 06/07/18 Code Update
    * 06/07/18 Update
    * Update
    * Update
    * 06/07/18 Update
2018-06-16 Branch4 (#10)
    * funciona
    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
2018-08-16 se fue
    [CuerpoDeMontaje.SLDPRT]
2018-08-16 este tambien
    [CuerpoDeMontaje.STL]
2018-08-16 pieazas 3d
    [PiezaFijaTD2.SLDPRT, PiezaFijaTD2.STL, PiezaMovilTD2.SLDPRT, PiezaMovilTD2.STL]
2018-08-17 add hojas de datos
    aca va chamuyo~
2018-08-27 Delete PCB_TPO_TD2.PDF
    viejo
2018-08-27 Delete PCB_TPO_TD2.rar
    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
2018-08-31 Alex (#13)
    * Add files via upload
    +PCB Kicad
    * Add files via upload
    * Add files via upload
    * Delete PCB-Kicad.zip
    [Kicad-BOM.csv, TD2-PCB.kicad_pcb, TD2-PCB.sch]
2018-11-15 Hardware Update(#28)
    [Board.sldprt, Bobina_RX.SLDPRT, Bobina_TX.SLDPRT, C1.sldasm, C10.sldasm, C11.sldasm, C12.sldasm, C13.sldasm]
2018-12-03 Informes (#30)
    [C1.sldasm, C10.sldasm, C11.sldasm, C12.sldasm, C13.sldasm, C14.sldasm, C15.sldasm, C16.sldasm]
2018-12-08 manual de usuario (#32)
2018-12-11 My branch (#39)
    * Agrego migracion de proyecto a FreeRTOS
    * Agrego migracion de proyecto a FreeRTOS
    * Code Update
    * Drivers Update: Peek & Overwrite (#14)
    * Limpio uso de queues (#15)
    * My branch (#16)
    * Limpio uso de queues
    * Code Update
    Task de descompresion funcionando
    * Testing Code (#17)
    Descompresion correcta.\r\n Shifteo correcto.\r\n HallSensor y IRQ relacionados: Falta testing.
    * My branch (#18)
    * Cleaning Useless Functions
    * My branch (#20)
    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
    [Bluetooth.c, Bluetooth.h, Display.c, Display.h, GPIOLPC1769.c, GPIOLPC1769.h, HallSensor.c, HallSensor.h]
